umurcg/roboticFarm/modelsali/Models2/CableCarier/Track Joining Plate_MIR Stress Analysis Report 05_01_2017.html

Image Width (pixels):

# Stress Analysis Report



Analyzed File: | Track Joining Plate_MIR.ipt
Autodesk Inventor Version: | 2017 (Build 210142000, 142)
Creation Date: | 05/01/2017, 04:51
Study Author: | Ali
Summary:

###  Project Info (iProperties)

####  Summary

Author | umr

####  Project

Part Number | Track Joining Plate_MIR
Designer | Ali
Cost | £0.00
Date Created | 01/04/2014

####  Status

Design Status | WorkInProgress

####  Custom

Sending System | SolidWorks 2014
Last Author | Rory
Last Saved | 22/03/2016

####  Physical

Material | SolidWorks Materials|6061 Alloy|21
Density | 2.7 g/cm^3
Mass | 0.0997726 kg
Area | 17201.1 mm^2
Volume | 36952.8 mm^3
Center of Gravity | x=0 mm y=-32.6579 mm z=-2.5 mm

Note: Physical values could be different from Physical values used by FEA reported below.

##  Static Analysis:1

General objective and settings:

Design Objective | Single Point
Study Type | Static Analysis
Last Modification Date | 05/01/2017, 04:49
Detect and Eliminate Rigid Body Modes | No

Mesh settings:

Avg. Element Size (fraction of model diameter) | 0.1
Min. Element Size (fraction of avg. size) | 0.2
Grading Factor | 1.5
Max. Turn Angle | 60 deg
Create Curved Mesh Elements | Yes

###  Material(s)

Name | SolidWorks Materials|6061 Alloy|21
General | Mass Density | 2.7 g/cm^3
| Yield Strength | 55.1485 MPa
| Ultimate Tensile Strength | 124.084 MPa
Stress | Young's Modulus | 69 GPa
| Poisson's Ratio | 0.33 ul
| Shear Modulus | 25.9398 GPa
Part Name(s) | Track Joining Plate_MIR

###  Operating conditions

####  Force:1

Load Type | Force
Magnitude | 300.000 N
Vector X | 0.000 N
Vector Y | -300.000 N
Vector Z | 0.000 N

#####  Selected Face(s)

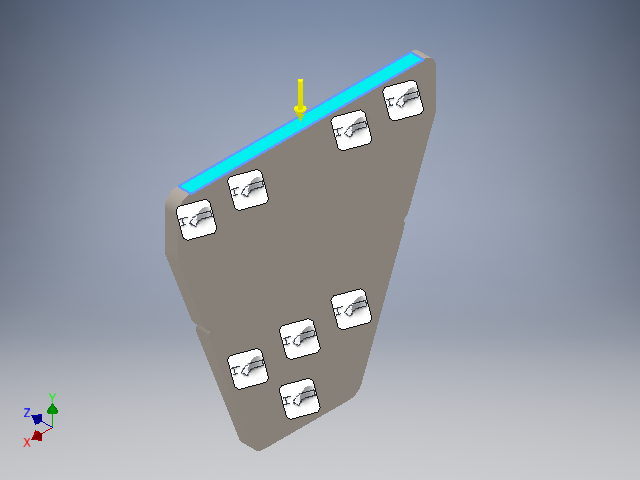
[picture p12: modelsali/Models2/CableCarier/Images/Track Joining Plate_MIR Stress Analysis Report 05_01_2017/0/Load_0_1.png]


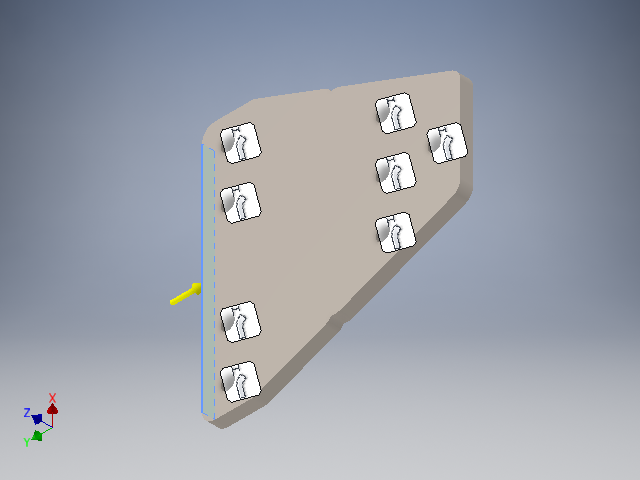
[picture p13: modelsali/Models2/CableCarier/Images/Track Joining Plate_MIR Stress Analysis Report 05_01_2017/0/Load_0_1_rev.png]


####  Fixed Constraint:1

Constraint Type | Fixed Constraint

#####  Selected Face(s)

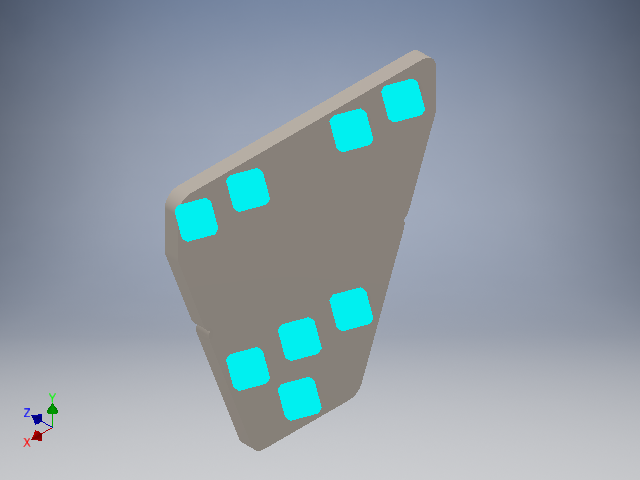
[picture p14: modelsali/Models2/CableCarier/Images/Track Joining Plate_MIR Stress Analysis Report 05_01_2017/0/Constraint_0_0.png]


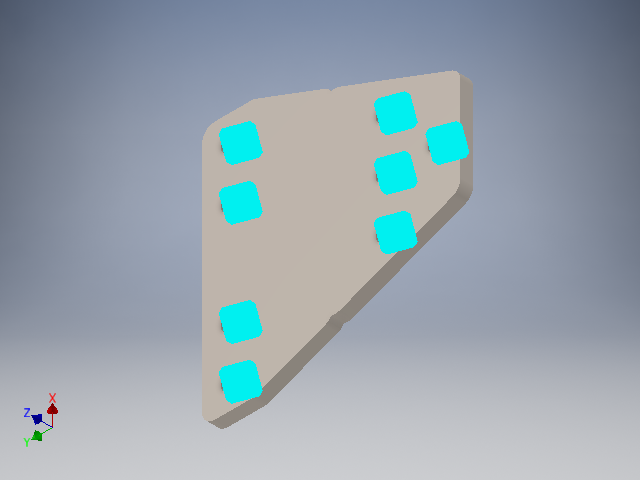
[picture p15: modelsali/Models2/CableCarier/Images/Track Joining Plate_MIR Stress Analysis Report 05_01_2017/0/Constraint_0_0_rev.png]


###  Results

####  Reaction Force and Moment on Constraints

Constraint Name | Reaction Force | | Reaction Moment
| Magnitude | Component (X,Y,Z) | Magnitude | Component (X,Y,Z)
Fixed Constraint:1 | 300 N | 0 N | 0.750183 N m | -0.750183 N m
| | 300 N | | 0 N m
| | 0 N | | 0 N m

####  Result Summary

Name | Minimum | Maximum
Volume | 36952.8 mm^3
Mass | 0.0997726 kg
Von Mises Stress | 0.00381254 MPa | 13.3405 MPa
1st Principal Stress | -1.33449 MPa | 9.61153 MPa
3rd Principal Stress | -10.5247 MPa | 0.820453 MPa
Displacement | 0 mm | 0.00102038 mm
Safety Factor | 4.1339 ul | 15 ul
Stress XX | -3.39842 MPa | 2.84843 MPa
Stress XY | -5.35685 MPa | 5.08963 MPa
Stress XZ | -3.9444 MPa | 3.36345 MPa
Stress YY | -8.54324 MPa | 8.24378 MPa
Stress YZ | -5.30222 MPa | 1.28965 MPa
Stress ZZ | -4.37922 MPa | 5.03622 MPa
X Displacement | -0.000126355 mm | 0.000126466 mm
Y Displacement | -0.00068512 mm | 0 mm
Z Displacement | -0.000884961 mm | 0.000793341 mm
Equivalent Strain | 0.0000000489979 ul | 0.000172419 ul
1st Principal Strain | 0.0000000444516 ul | 0.000158573 ul
3rd Principal Strain | -0.000165094 ul | -0.0000000357224 ul
Strain XX | -0.0000426302 ul | 0.0000384396 ul
Strain XY | -0.000103255 ul | 0.0000981045 ul
Strain XZ | -0.0000760298 ul | 0.0000648317 ul
Strain YY | -0.000126692 ul | 0.000118599 ul
Strain YZ | -0.000102202 ul | 0.0000248585 ul
Strain ZZ | -0.0000789899 ul | 0.000102537 ul

####  Figures

#####  Von Mises Stress

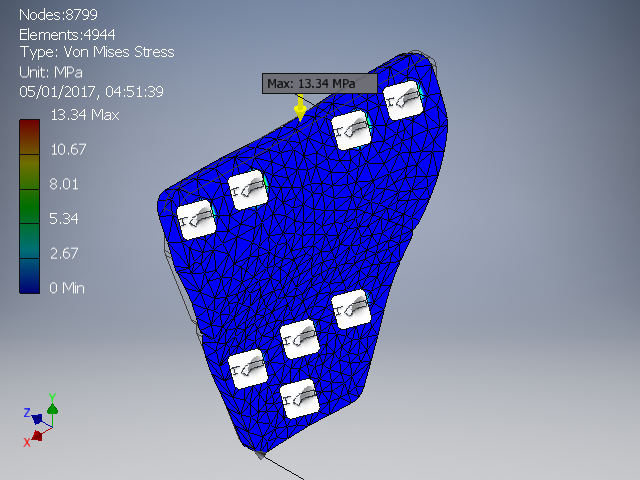
[picture p16: modelsali/Models2/CableCarier/Images/Track Joining Plate_MIR Stress Analysis Report 05_01_2017/0/Result_0_1.png]


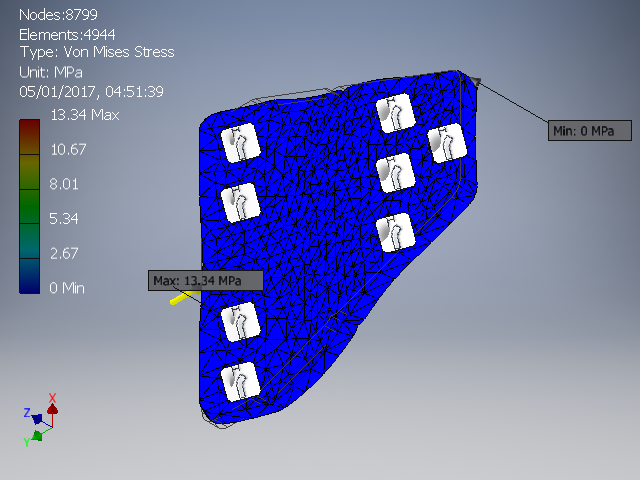
[picture p17: modelsali/Models2/CableCarier/Images/Track Joining Plate_MIR Stress Analysis Report 05_01_2017/0/Result_0_1_rev.png]


#####  1st Principal Stress

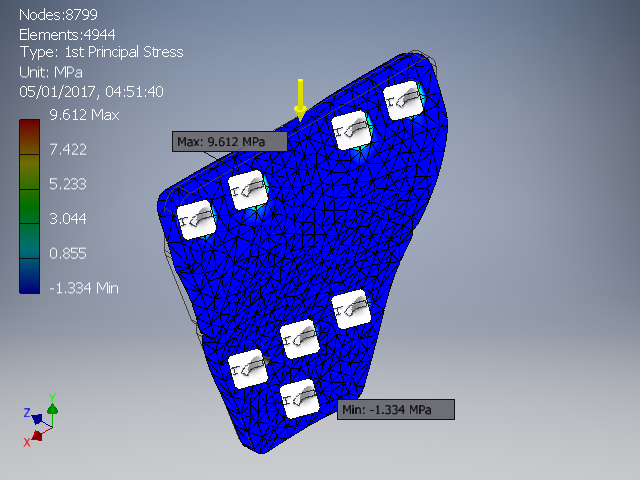
[picture p18: modelsali/Models2/CableCarier/Images/Track Joining Plate_MIR Stress Analysis Report 05_01_2017/0/Result_0_6.png]


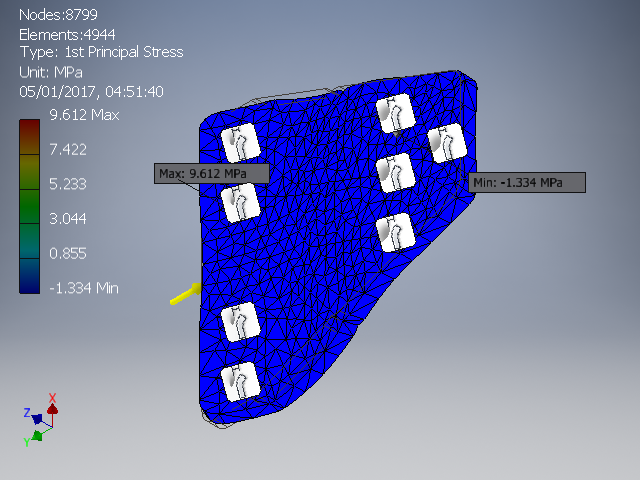
[picture p19: modelsali/Models2/CableCarier/Images/Track Joining Plate_MIR Stress Analysis Report 05_01_2017/0/Result_0_6_rev.png]


#####  3rd Principal Stress

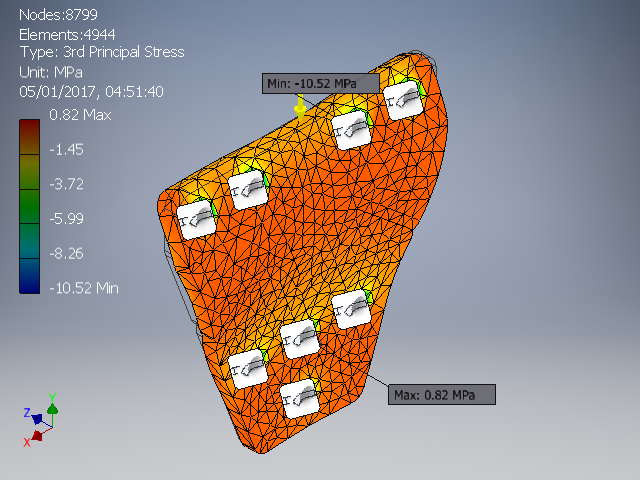
[picture p20: modelsali/Models2/CableCarier/Images/Track Joining Plate_MIR Stress Analysis Report 05_01_2017/0/Result_0_8.png]


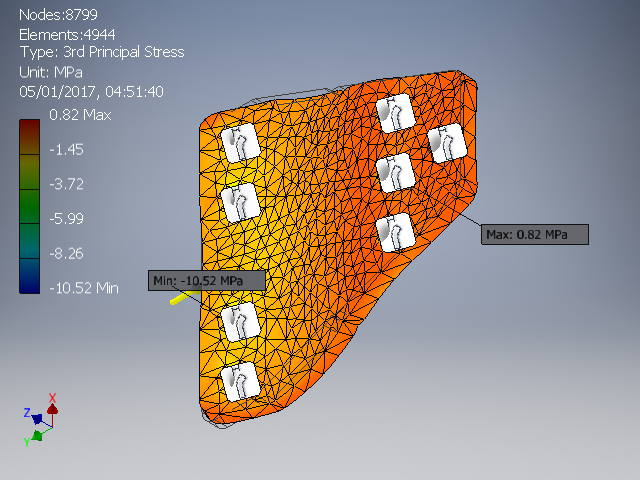
[picture p21: modelsali/Models2/CableCarier/Images/Track Joining Plate_MIR Stress Analysis Report 05_01_2017/0/Result_0_8_rev.png]


#####  Displacement

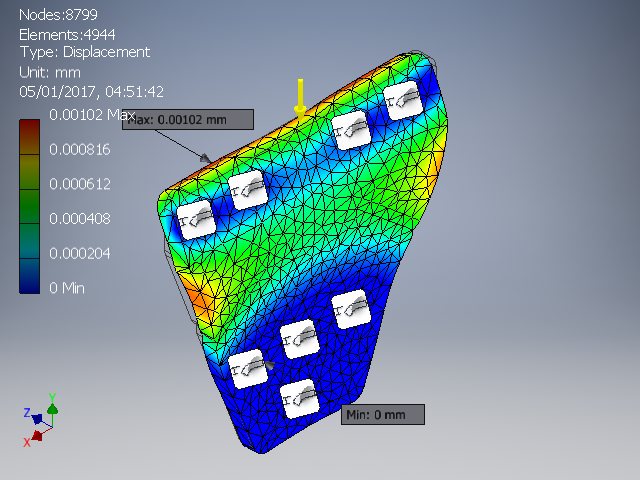
[picture p22: modelsali/Models2/CableCarier/Images/Track Joining Plate_MIR Stress Analysis Report 05_01_2017/0/Result_0_2.png]


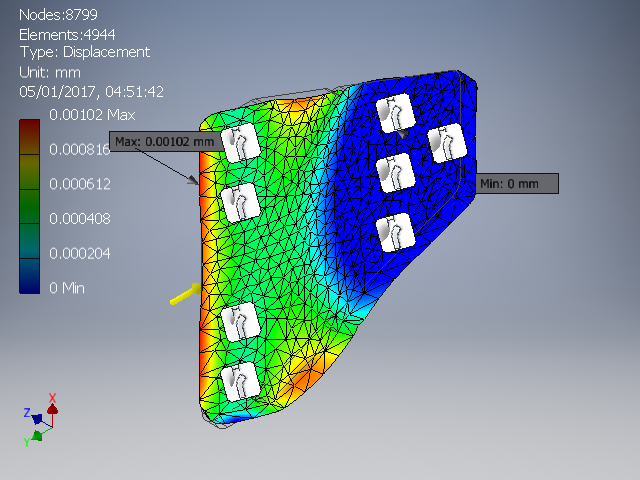
[picture p23: modelsali/Models2/CableCarier/Images/Track Joining Plate_MIR Stress Analysis Report 05_01_2017/0/Result_0_2_rev.png]


#####  Safety Factor

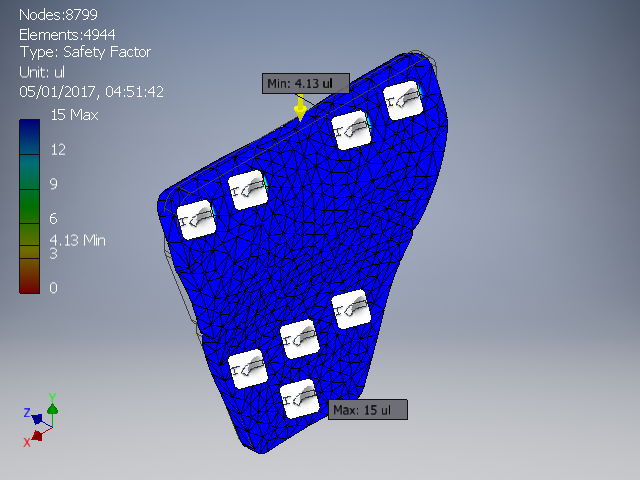
[picture p24: modelsali/Models2/CableCarier/Images/Track Joining Plate_MIR Stress Analysis Report 05_01_2017/0/Result_0_57.png]


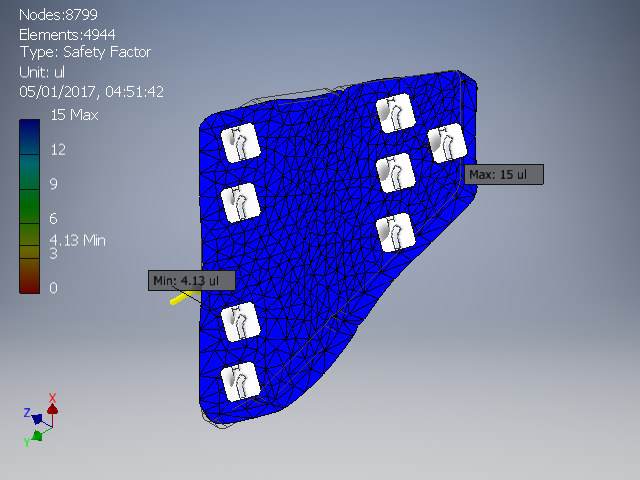
[picture p25: modelsali/Models2/CableCarier/Images/Track Joining Plate_MIR Stress Analysis Report 05_01_2017/0/Result_0_57_rev.png]


#####  Stress XX

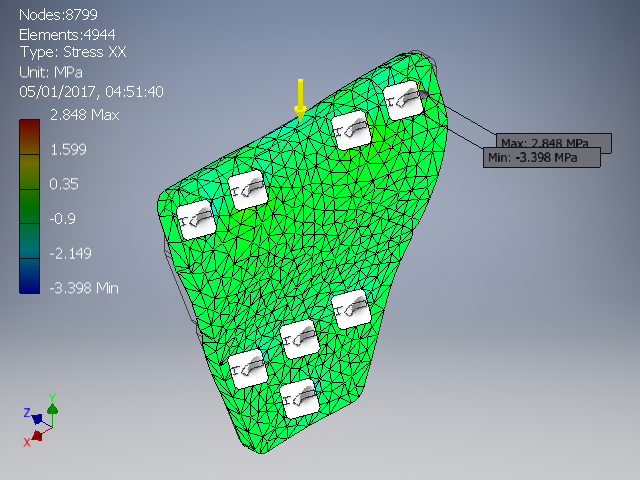
[picture p26: modelsali/Models2/CableCarier/Images/Track Joining Plate_MIR Stress Analysis Report 05_01_2017/0/Result_0_9.png]


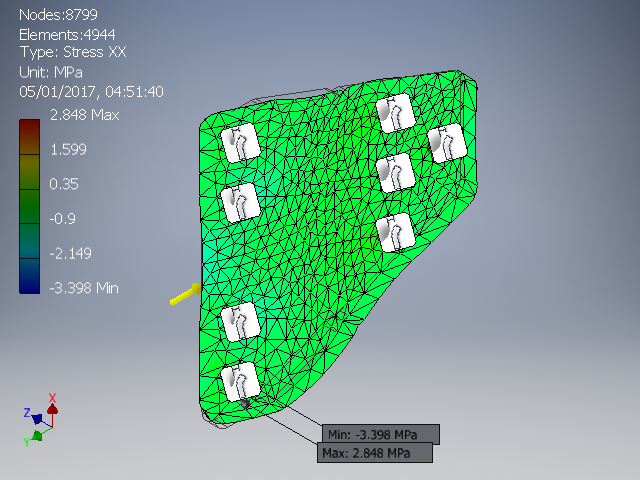
[picture p27: modelsali/Models2/CableCarier/Images/Track Joining Plate_MIR Stress Analysis Report 05_01_2017/0/Result_0_9_rev.png]


#####  Stress XY

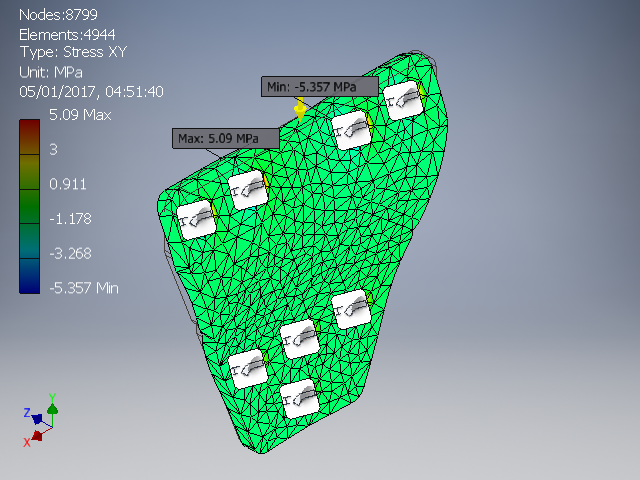
[picture p28: modelsali/Models2/CableCarier/Images/Track Joining Plate_MIR Stress Analysis Report 05_01_2017/0/Result_0_10.png]


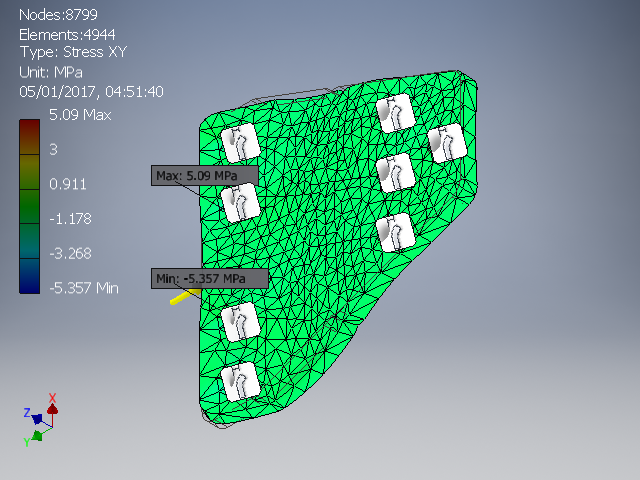
[picture p29: modelsali/Models2/CableCarier/Images/Track Joining Plate_MIR Stress Analysis Report 05_01_2017/0/Result_0_10_rev.png]


#####  Stress XZ

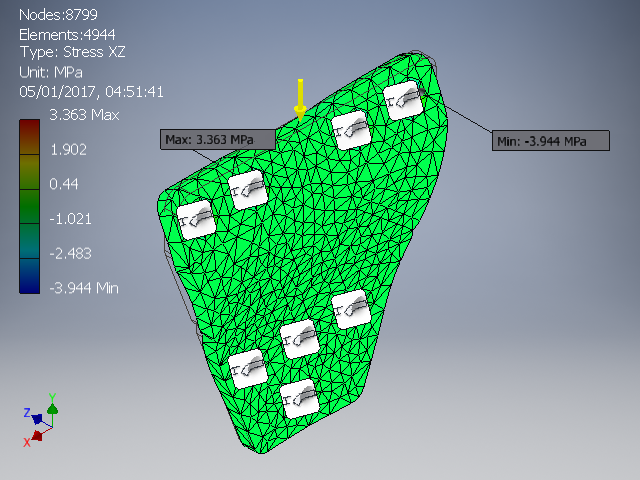
[picture p30: modelsali/Models2/CableCarier/Images/Track Joining Plate_MIR Stress Analysis Report 05_01_2017/0/Result_0_11.png]


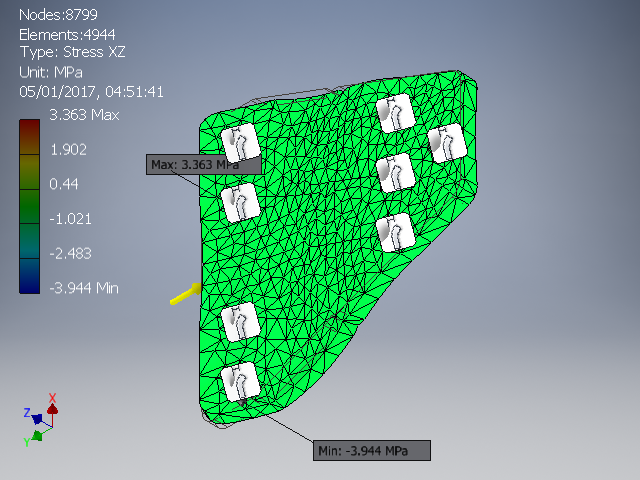
[picture p31: modelsali/Models2/CableCarier/Images/Track Joining Plate_MIR Stress Analysis Report 05_01_2017/0/Result_0_11_rev.png]


#####  Stress YY

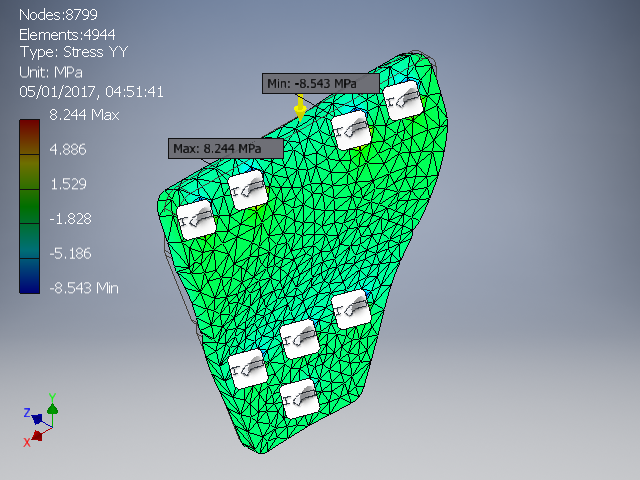
[picture p32: modelsali/Models2/CableCarier/Images/Track Joining Plate_MIR Stress Analysis Report 05_01_2017/0/Result_0_12.png]


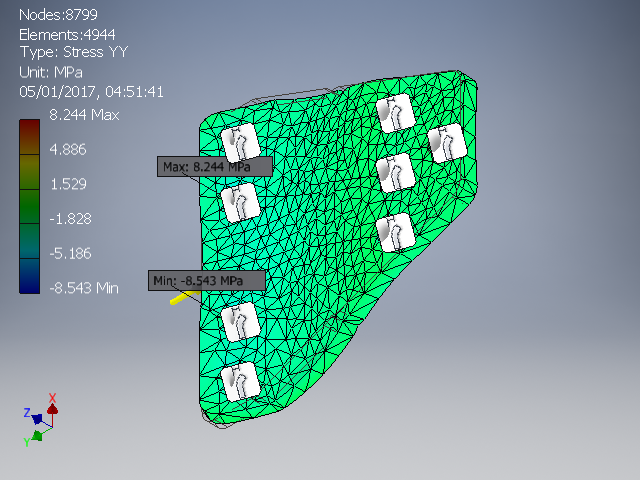
[picture p33: modelsali/Models2/CableCarier/Images/Track Joining Plate_MIR Stress Analysis Report 05_01_2017/0/Result_0_12_rev.png]


#####  Stress YZ

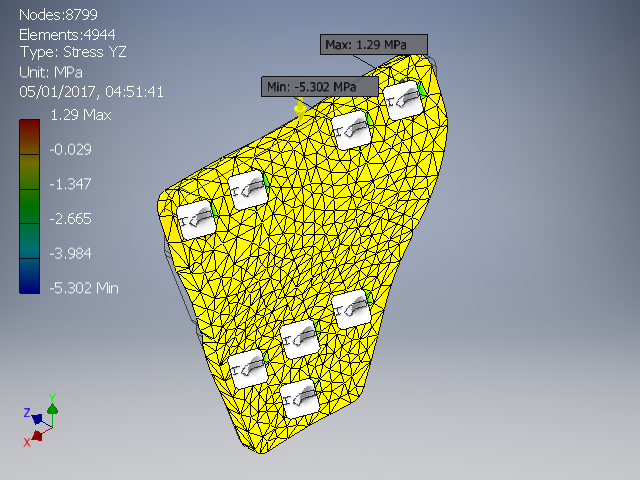
[picture p34: modelsali/Models2/CableCarier/Images/Track Joining Plate_MIR Stress Analysis Report 05_01_2017/0/Result_0_13.png]


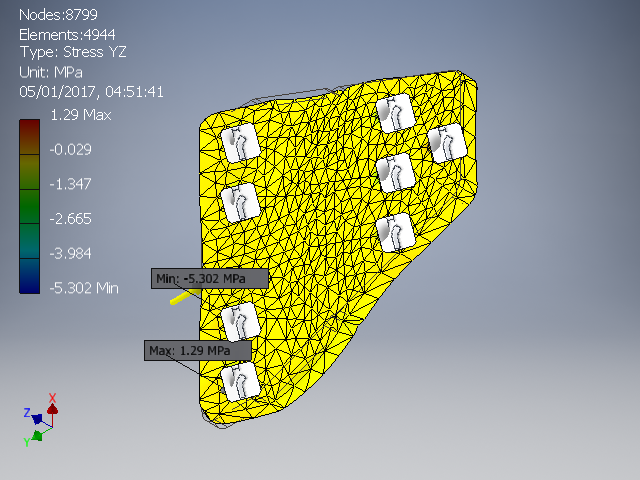
[picture p35: modelsali/Models2/CableCarier/Images/Track Joining Plate_MIR Stress Analysis Report 05_01_2017/0/Result_0_13_rev.png]


#####  Stress ZZ

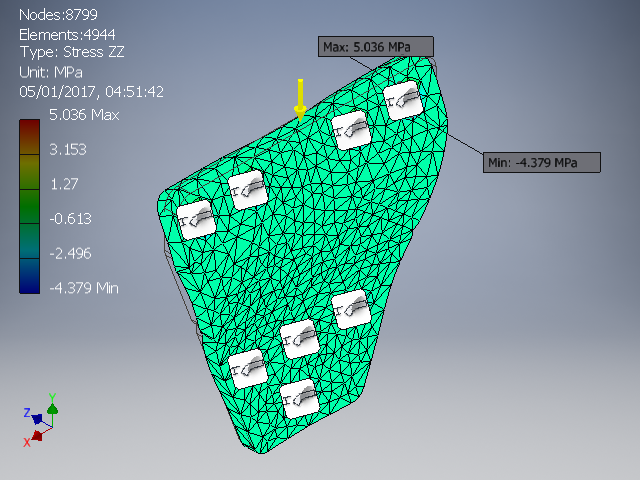
[picture p36: modelsali/Models2/CableCarier/Images/Track Joining Plate_MIR Stress Analysis Report 05_01_2017/0/Result_0_14.png]


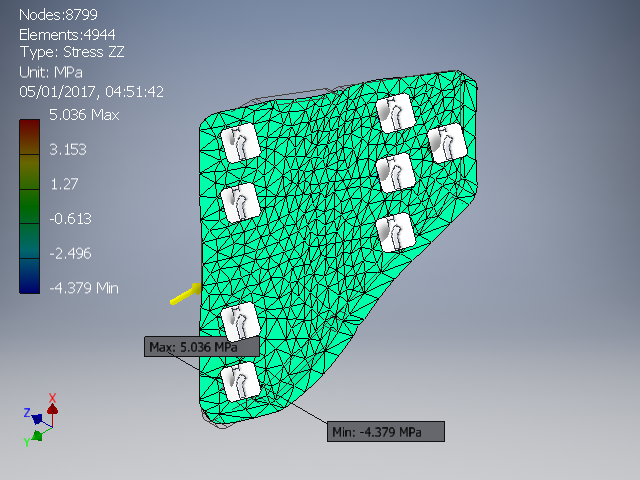
[picture p37: modelsali/Models2/CableCarier/Images/Track Joining Plate_MIR Stress Analysis Report 05_01_2017/0/Result_0_14_rev.png]


#####  X Displacement

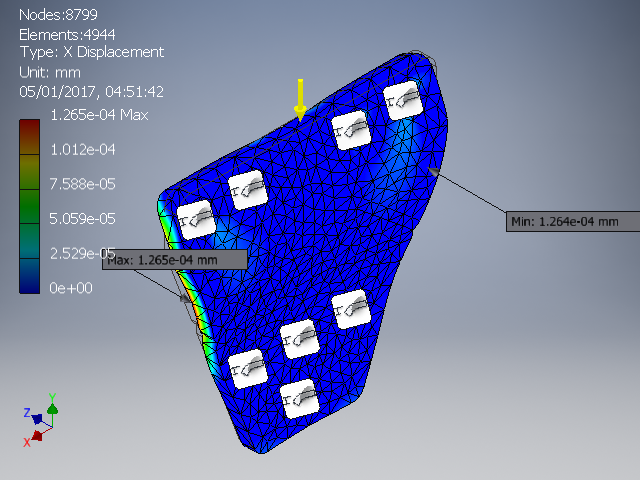
[picture p38: modelsali/Models2/CableCarier/Images/Track Joining Plate_MIR Stress Analysis Report 05_01_2017/0/Result_0_3.png]


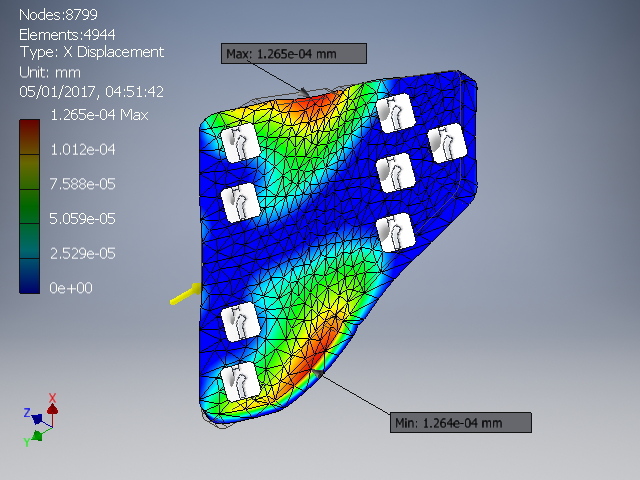
[picture p39: modelsali/Models2/CableCarier/Images/Track Joining Plate_MIR Stress Analysis Report 05_01_2017/0/Result_0_3_rev.png]


#####  Y Displacement

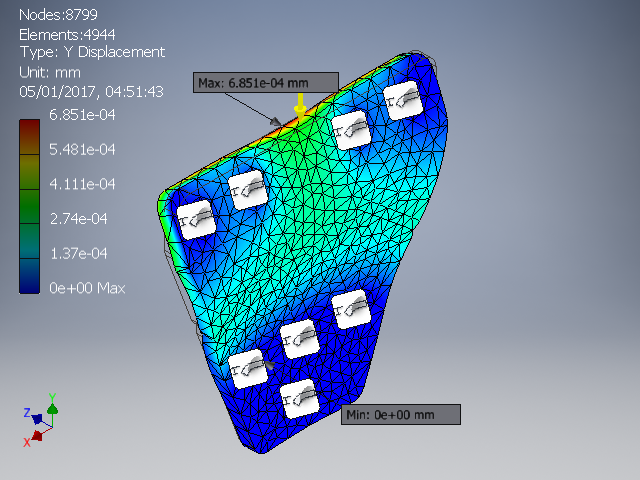
[picture p40: modelsali/Models2/CableCarier/Images/Track Joining Plate_MIR Stress Analysis Report 05_01_2017/0/Result_0_4.png]


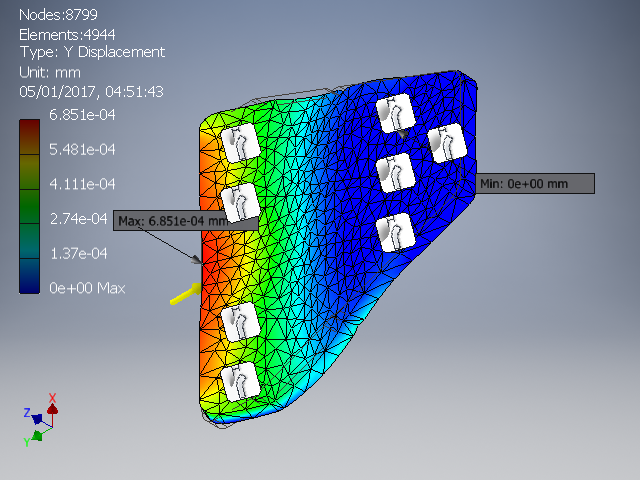
[picture p41: modelsali/Models2/CableCarier/Images/Track Joining Plate_MIR Stress Analysis Report 05_01_2017/0/Result_0_4_rev.png]


#####  Z Displacement

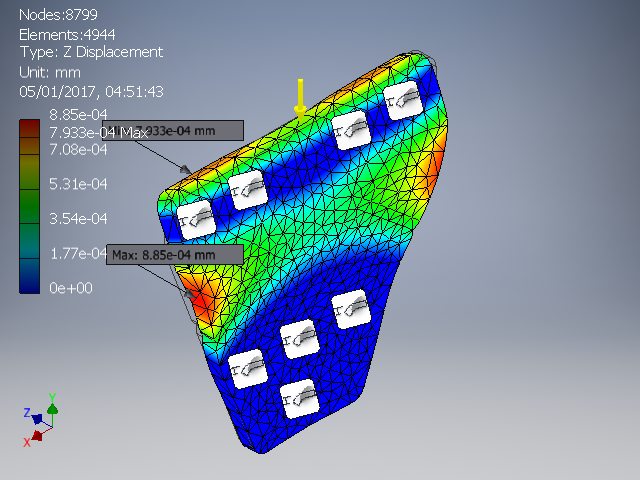
[picture p42: modelsali/Models2/CableCarier/Images/Track Joining Plate_MIR Stress Analysis Report 05_01_2017/0/Result_0_5.png]


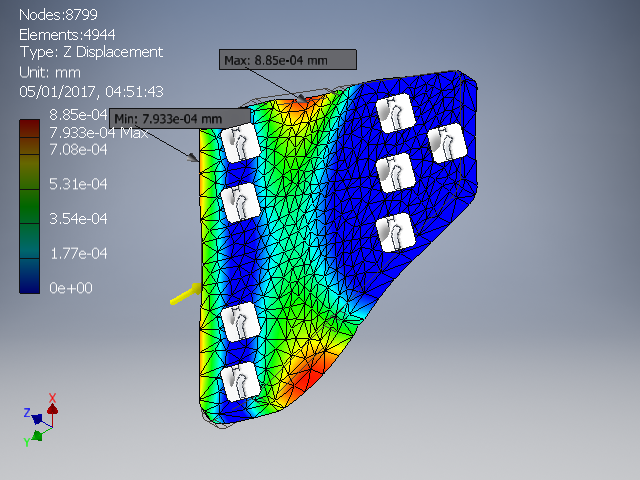
[picture p43: modelsali/Models2/CableCarier/Images/Track Joining Plate_MIR Stress Analysis Report 05_01_2017/0/Result_0_5_rev.png]


#####  Equivalent Strain

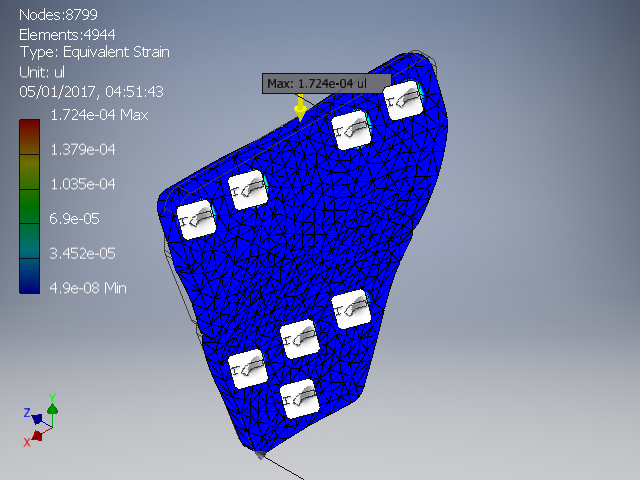
[picture p44: modelsali/Models2/CableCarier/Images/Track Joining Plate_MIR Stress Analysis Report 05_01_2017/0/Result_0_80.png]


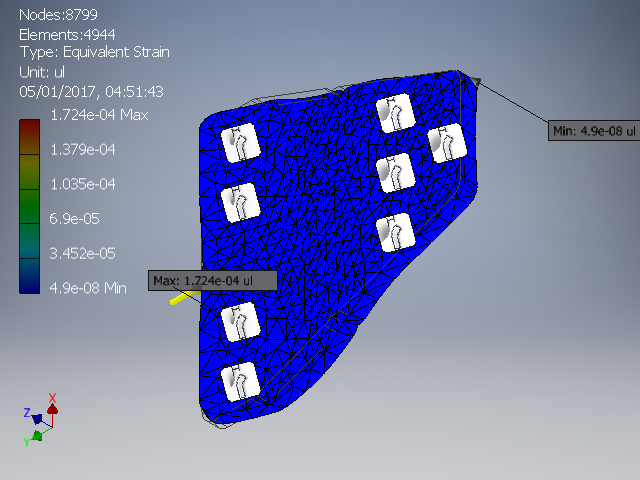
[picture p45: modelsali/Models2/CableCarier/Images/Track Joining Plate_MIR Stress Analysis Report 05_01_2017/0/Result_0_80_rev.png]


#####  1st Principal Strain

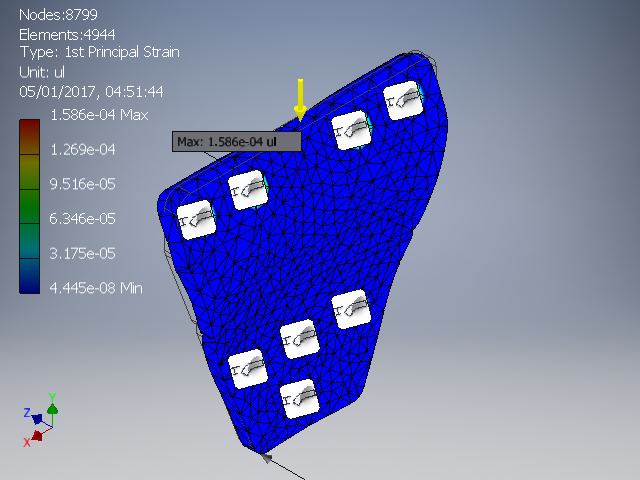
[picture p46: modelsali/Models2/CableCarier/Images/Track Joining Plate_MIR Stress Analysis Report 05_01_2017/0/Result_0_81.png]


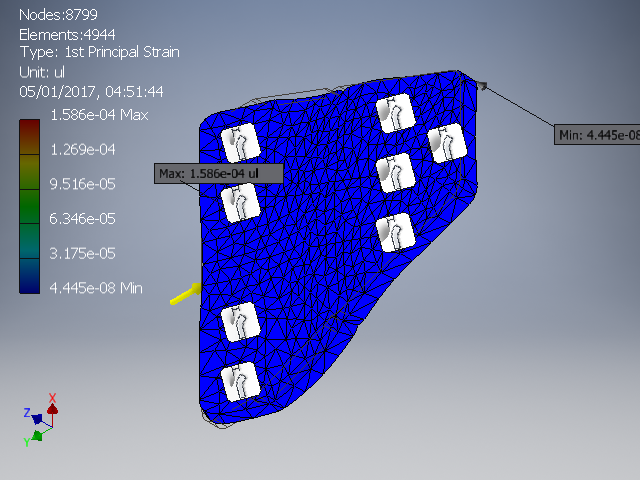
[picture p47: modelsali/Models2/CableCarier/Images/Track Joining Plate_MIR Stress Analysis Report 05_01_2017/0/Result_0_81_rev.png]


#####  3rd Principal Strain

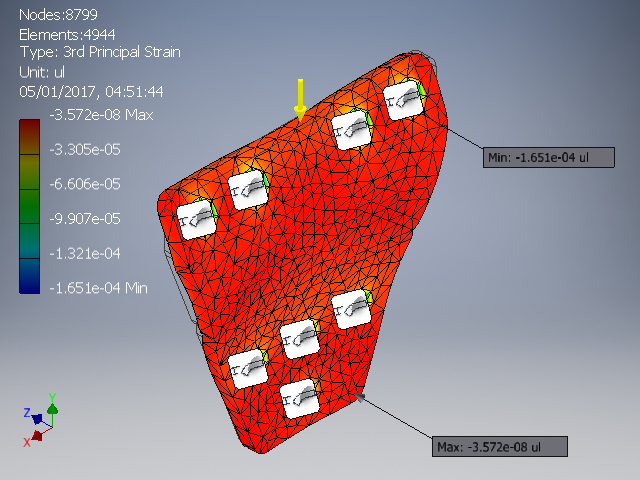
[picture p48: modelsali/Models2/CableCarier/Images/Track Joining Plate_MIR Stress Analysis Report 05_01_2017/0/Result_0_83.png]


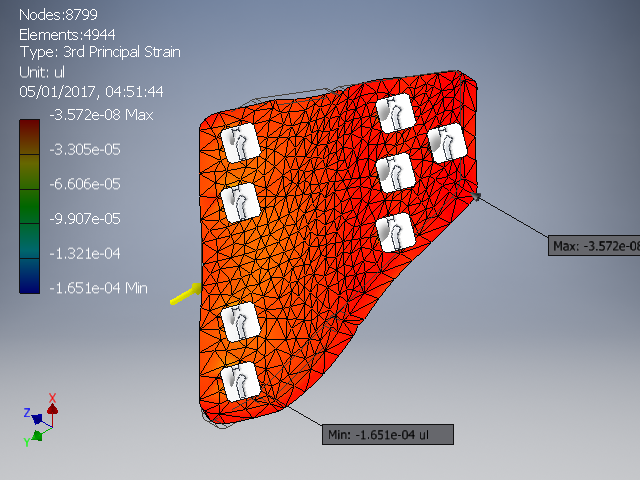
[picture p49: modelsali/Models2/CableCarier/Images/Track Joining Plate_MIR Stress Analysis Report 05_01_2017/0/Result_0_83_rev.png]


#####  Strain XX

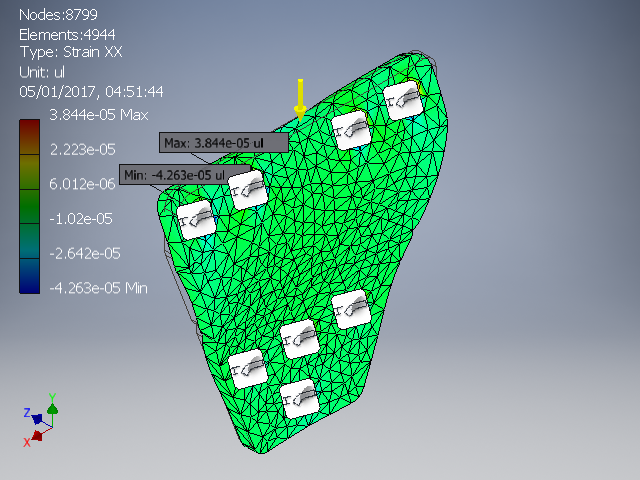
[picture p50: modelsali/Models2/CableCarier/Images/Track Joining Plate_MIR Stress Analysis Report 05_01_2017/0/Result_0_58.png]


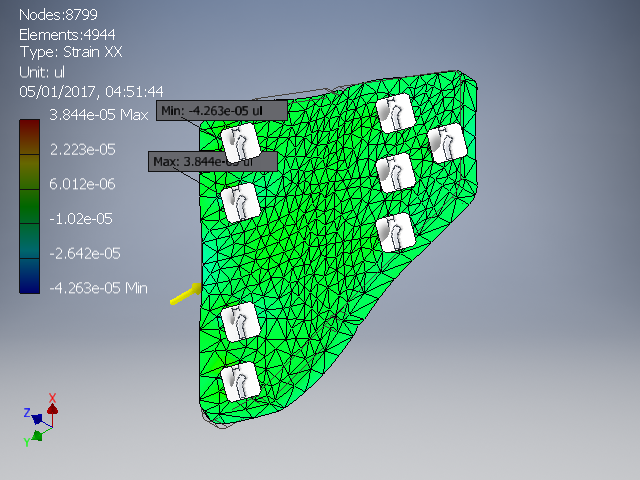
[picture p51: modelsali/Models2/CableCarier/Images/Track Joining Plate_MIR Stress Analysis Report 05_01_2017/0/Result_0_58_rev.png]


#####  Strain XY

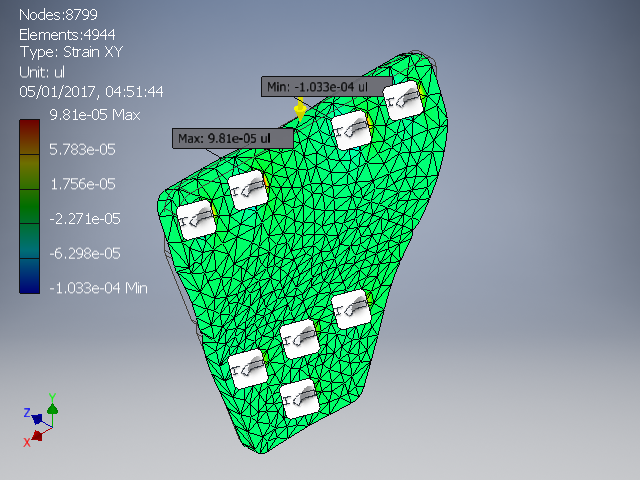
[picture p52: modelsali/Models2/CableCarier/Images/Track Joining Plate_MIR Stress Analysis Report 05_01_2017/0/Result_0_59.png]


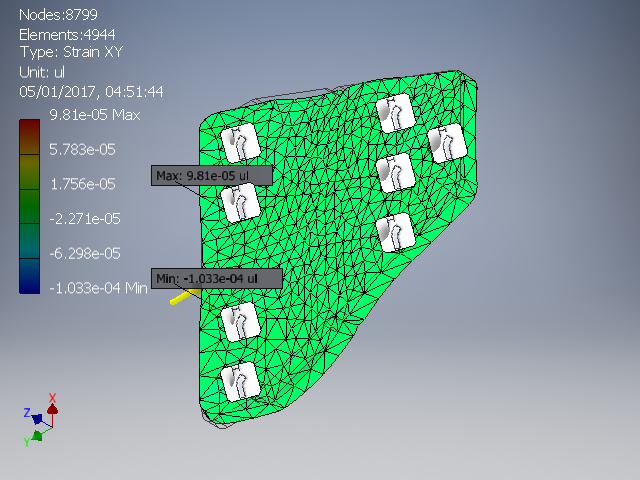
[picture p53: modelsali/Models2/CableCarier/Images/Track Joining Plate_MIR Stress Analysis Report 05_01_2017/0/Result_0_59_rev.png]


#####  Strain XZ

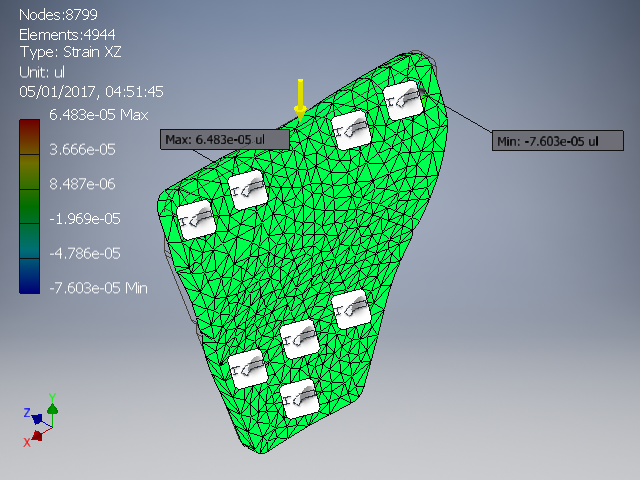
[picture p54: modelsali/Models2/CableCarier/Images/Track Joining Plate_MIR Stress Analysis Report 05_01_2017/0/Result_0_60.png]


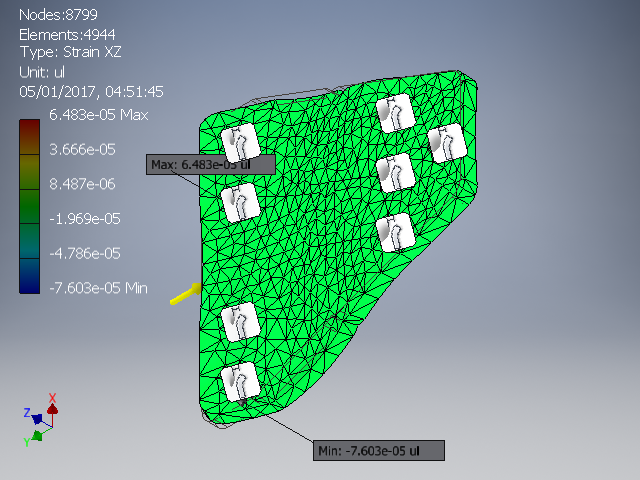
[picture p55: modelsali/Models2/CableCarier/Images/Track Joining Plate_MIR Stress Analysis Report 05_01_2017/0/Result_0_60_rev.png]


#####  Strain YY

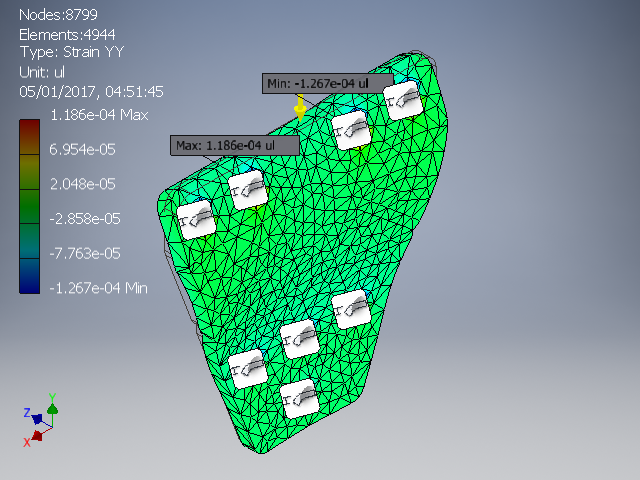
[picture p56: modelsali/Models2/CableCarier/Images/Track Joining Plate_MIR Stress Analysis Report 05_01_2017/0/Result_0_61.png]


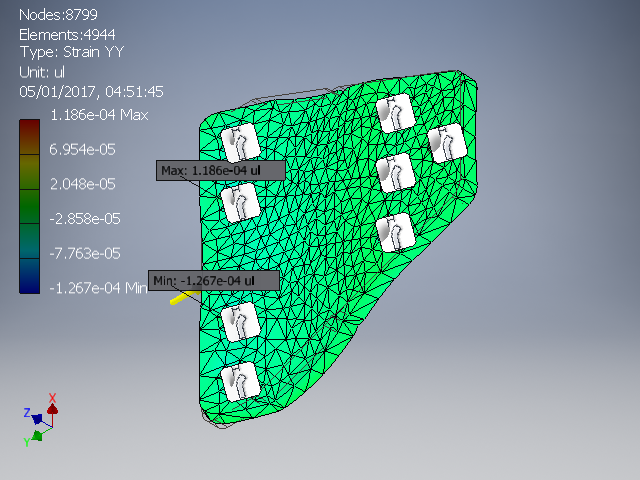
[picture p57: modelsali/Models2/CableCarier/Images/Track Joining Plate_MIR Stress Analysis Report 05_01_2017/0/Result_0_61_rev.png]


#####  Strain YZ

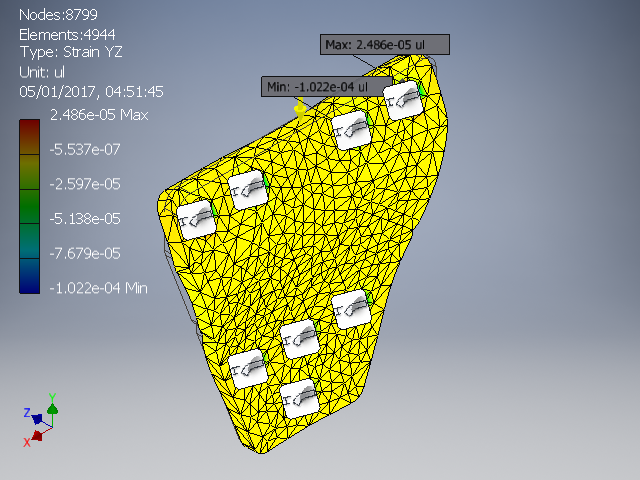
[picture p58: modelsali/Models2/CableCarier/Images/Track Joining Plate_MIR Stress Analysis Report 05_01_2017/0/Result_0_62.png]


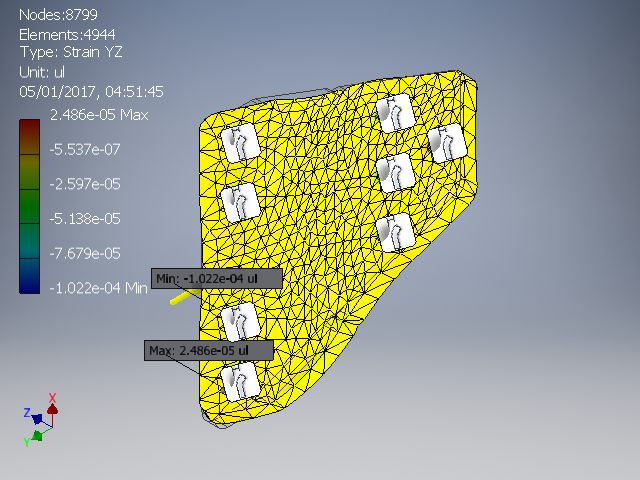
[picture p59: modelsali/Models2/CableCarier/Images/Track Joining Plate_MIR Stress Analysis Report 05_01_2017/0/Result_0_62_rev.png]


#####  Strain ZZ

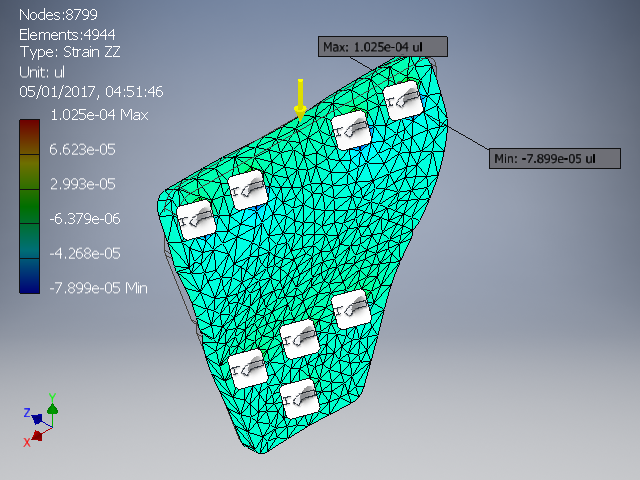
[picture p60: modelsali/Models2/CableCarier/Images/Track Joining Plate_MIR Stress Analysis Report 05_01_2017/0/Result_0_63.png]


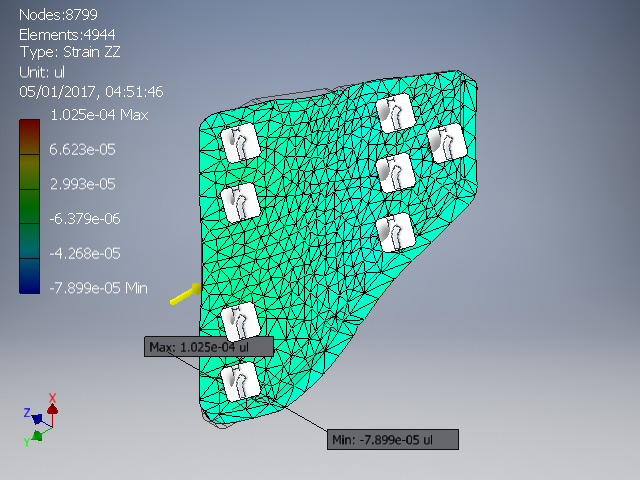
[picture p61: modelsali/Models2/CableCarier/Images/Track Joining Plate_MIR Stress Analysis Report 05_01_2017/0/Result_0_63_rev.png]


C:\Users\Ali\Desktop\roboticFarm-master\Models2\CableCarier\Track Joining Plate_MIR.ipt

Image Width (pixels):
