umurcg/roboticFarm/modelsali/Models2/Gantry/Driveshaft Stress Analysis Report 05_01_2017.html

Image Width (pixels):

# Stress Analysis Report



Analyzed File: | Driveshaft.ipt
Autodesk Inventor Version: | 2017 (Build 210142000, 142)
Creation Date: | 05/01/2017, 04:24
Study Author: | Ali
Summary:

###  Project Info (iProperties)

####  Summary

Author | umr

####  Project

Part Number | Driveshaft
Designer | umr
Cost | £0.00
Date Created | 12/12/2016

####  Status

Design Status | WorkInProgress

####  Physical

Material | Aluminum 6061
Density | 2.7 g/cm^3
Mass | 0.0689187 kg
Area | 20459.6 mm^2
Volume | 25525.4 mm^3
Center of Gravity | x=0.00000000026142 mm y=650 mm z=0 mm

Note: Physical values could be different from Physical values used by FEA reported below.

##  Static Analysis:1

General objective and settings:

Design Objective | Single Point
Study Type | Static Analysis
Last Modification Date | 05/01/2017, 04:22
Detect and Eliminate Rigid Body Modes | No

Mesh settings:

Avg. Element Size (fraction of model diameter) | 0.05
Min. Element Size (fraction of avg. size) | 0.1
Grading Factor | 1.5
Max. Turn Angle | 60 deg
Create Curved Mesh Elements | Yes

###  Material(s)

Name | Aluminum 6061
General | Mass Density | 2.7 g/cm^3
| Yield Strength | 275 MPa
| Ultimate Tensile Strength | 310 MPa
Stress | Young's Modulus | 68.9 GPa
| Poisson's Ratio | 0.33 ul
| Shear Modulus | 25.9023 GPa
Part Name(s) | Driveshaft

###  Operating conditions

####  Moment:1

Load Type | Moment
Magnitude | 100.000 N mm
Vector X | 0.000 N mm
Vector Y | -100.000 N mm
Vector Z | 0.000 N mm

#####  Selected Face(s)

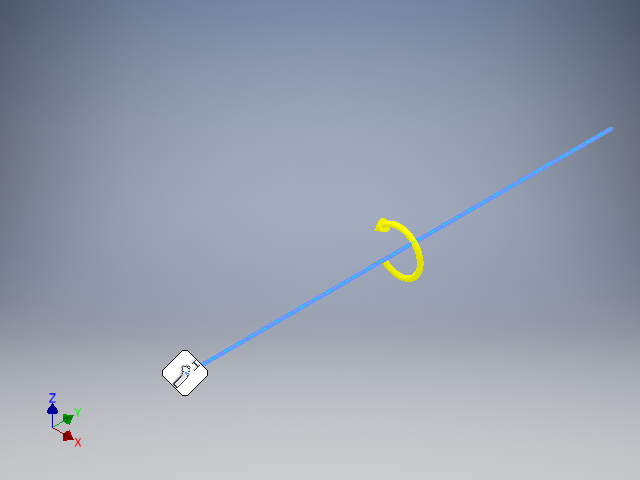
[picture p62: modelsali/Models2/Gantry/Images/Driveshaft Stress Analysis Report 05_01_2017/0/Load_0_0.png]


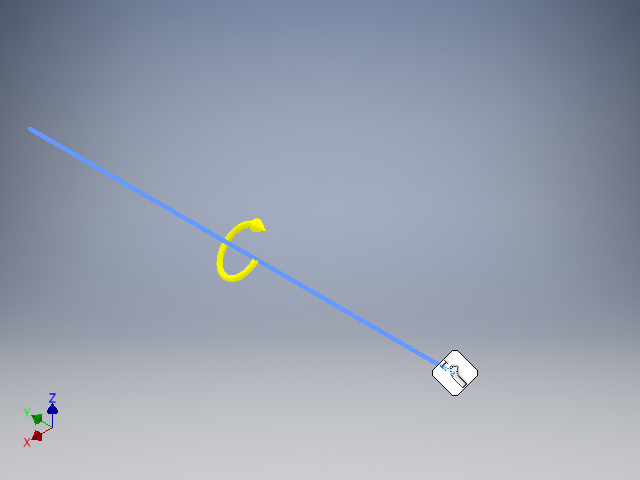
[picture p63: modelsali/Models2/Gantry/Images/Driveshaft Stress Analysis Report 05_01_2017/0/Load_0_0_rev.png]


####  Fixed Constraint:1

Constraint Type | Fixed Constraint

#####  Selected Face(s)

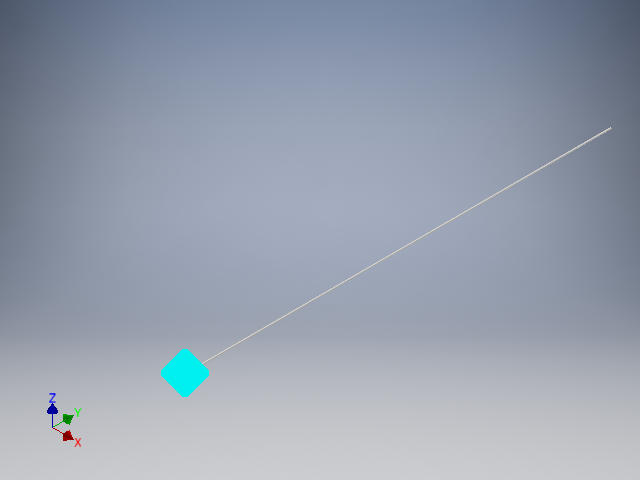
[picture p64: modelsali/Models2/Gantry/Images/Driveshaft Stress Analysis Report 05_01_2017/0/Constraint_0_2.png]


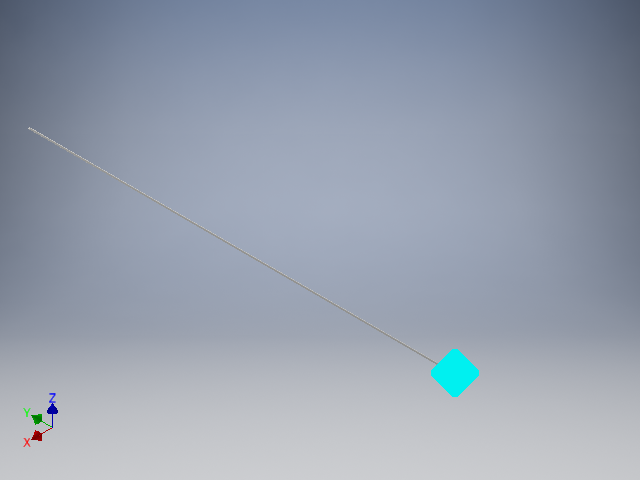
[picture p65: modelsali/Models2/Gantry/Images/Driveshaft Stress Analysis Report 05_01_2017/0/Constraint_0_2_rev.png]


###  Results

####  Reaction Force and Moment on Constraints

Constraint Name | Reaction Force | | Reaction Moment
| Magnitude | Component (X,Y,Z) | Magnitude | Component (X,Y,Z)
Fixed Constraint:1 | 0 N | 0 N | 0.0998838 N m | -0.00295947 N m
| | 0 N | | 0.0998395 N m
| | 0 N | | 0.000288372 N m

####  Result Summary

Name | Minimum | Maximum
Volume | 25525.4 mm^3
Mass | 0.0689187 kg
Von Mises Stress | 0.00118769 MPa | 11.9474 MPa
1st Principal Stress | -0.00111354 MPa | 7.09513 MPa
3rd Principal Stress | -7.41829 MPa | 0.144277 MPa
Displacement | 0 mm | 0.758937 mm
Safety Factor | 15 ul | 15 ul
Stress XX | -5.44887 MPa | 4.71323 MPa
Stress XY | -5.83788 MPa | 5.30874 MPa
Stress XZ | -5.2708 MPa | 4.14465 MPa
Stress YY | -0.696162 MPa | 0.526933 MPa
Stress YZ | -5.00687 MPa | 5.21906 MPa
Stress ZZ | -4.76428 MPa | 5.61412 MPa
X Displacement | -0.0471642 mm | 0.215522 mm
Y Displacement | -0.00173211 mm | 0.00173486 mm
Z Displacement | -0.00834352 mm | 0.750322 mm
Equivalent Strain | 0.00000001575 ul | 0.000153756 ul
1st Principal Strain | 0.0000000104867 ul | 0.000134059 ul
3rd Principal Strain | -0.000134647 ul | -0.000000013685 ul
Strain XX | -0.000106698 ul | 0.000091753 ul
Strain XY | -0.00011269 ul | 0.000102476 ul
Strain XZ | -0.000101744 ul | 0.0000800056 ul
Strain YY | -0.00000738737 ul | 0.00000635923 ul
Strain YZ | -0.0000966494 ul | 0.000100745 ul
Strain ZZ | -0.0000911946 ul | 0.00010547 ul

####  Figures

#####  Von Mises Stress

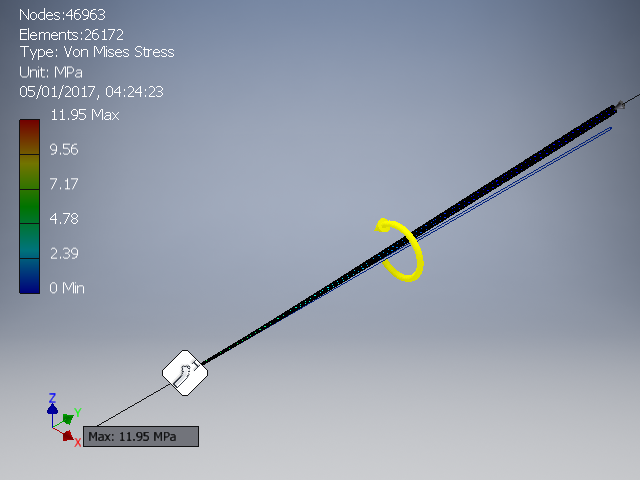
[picture p66: modelsali/Models2/Gantry/Images/Driveshaft Stress Analysis Report 05_01_2017/0/Result_0_1.png]


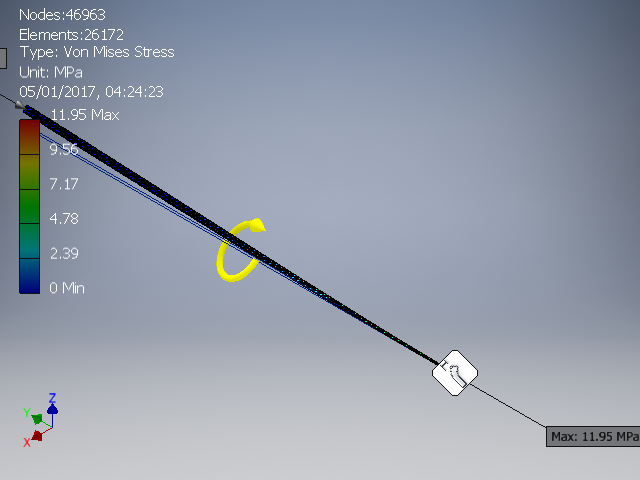
[picture p67: modelsali/Models2/Gantry/Images/Driveshaft Stress Analysis Report 05_01_2017/0/Result_0_1_rev.png]


#####  1st Principal Stress

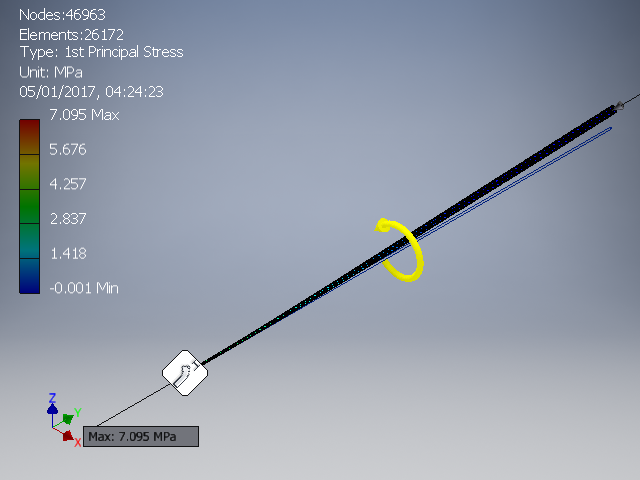
[picture p68: modelsali/Models2/Gantry/Images/Driveshaft Stress Analysis Report 05_01_2017/0/Result_0_6.png]


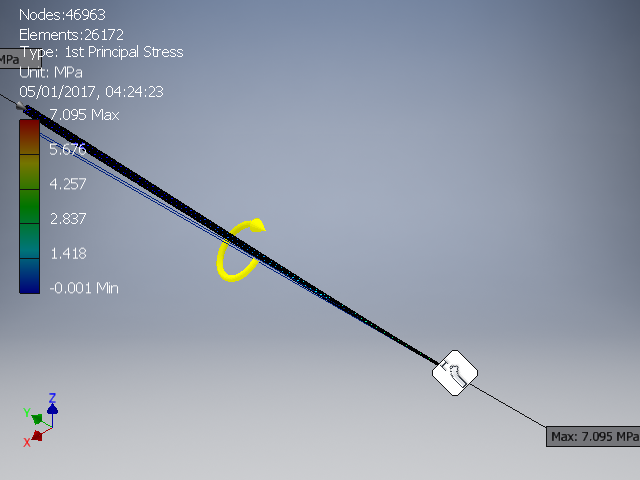
[picture p69: modelsali/Models2/Gantry/Images/Driveshaft Stress Analysis Report 05_01_2017/0/Result_0_6_rev.png]


#####  3rd Principal Stress

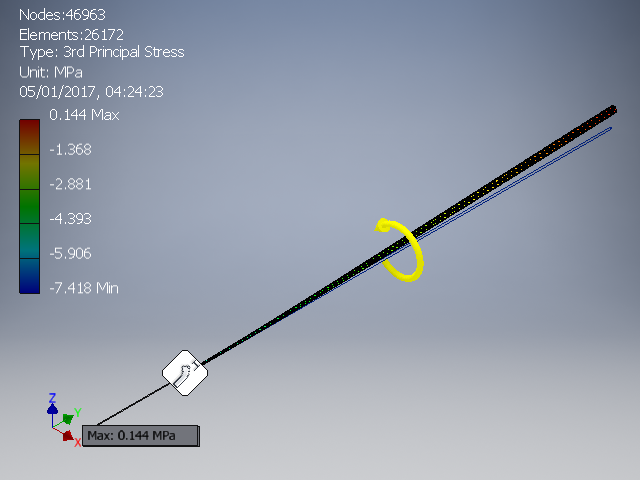
[picture p70: modelsali/Models2/Gantry/Images/Driveshaft Stress Analysis Report 05_01_2017/0/Result_0_8.png]


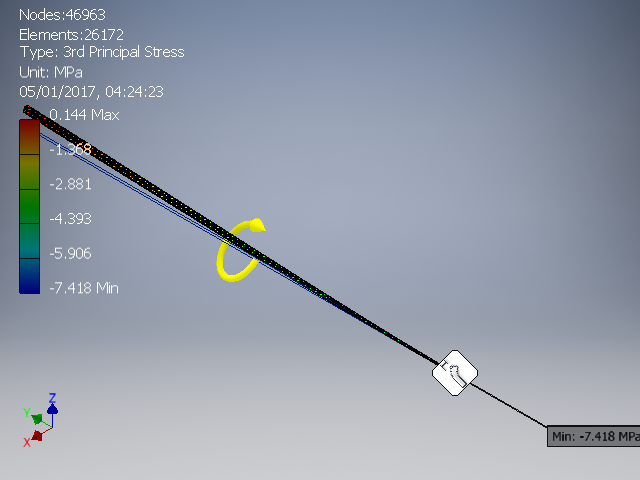
[picture p71: modelsali/Models2/Gantry/Images/Driveshaft Stress Analysis Report 05_01_2017/0/Result_0_8_rev.png]


#####  Displacement

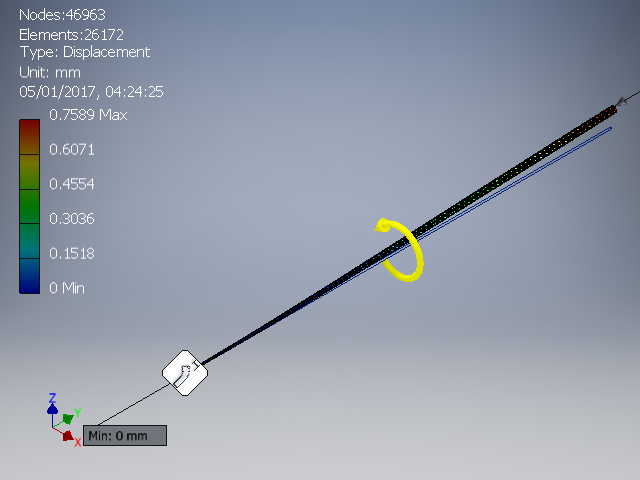
[picture p72: modelsali/Models2/Gantry/Images/Driveshaft Stress Analysis Report 05_01_2017/0/Result_0_2.png]


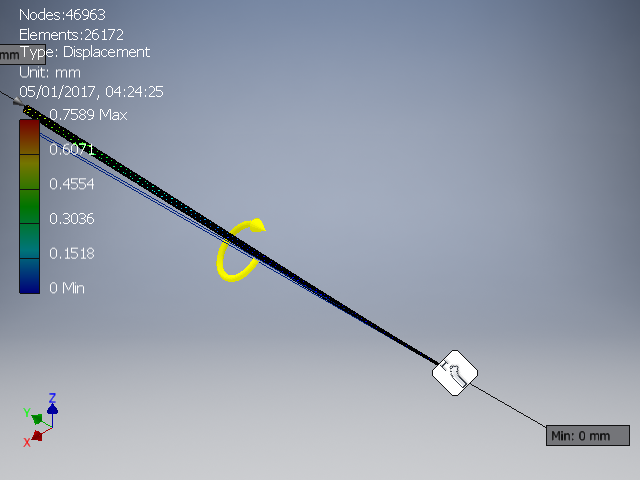
[picture p73: modelsali/Models2/Gantry/Images/Driveshaft Stress Analysis Report 05_01_2017/0/Result_0_2_rev.png]


#####  Safety Factor

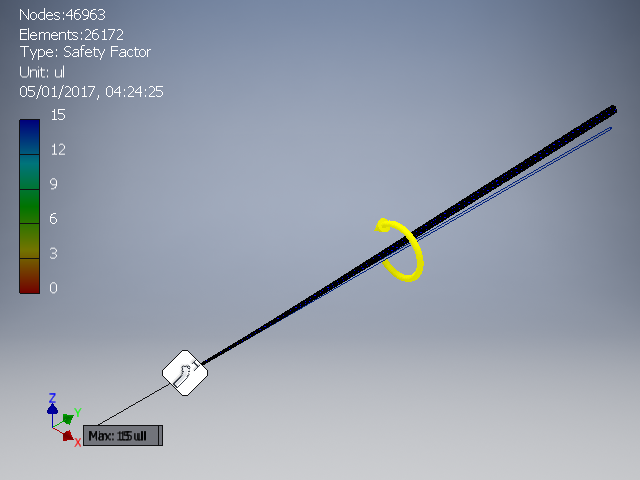
[picture p74: modelsali/Models2/Gantry/Images/Driveshaft Stress Analysis Report 05_01_2017/0/Result_0_57.png]


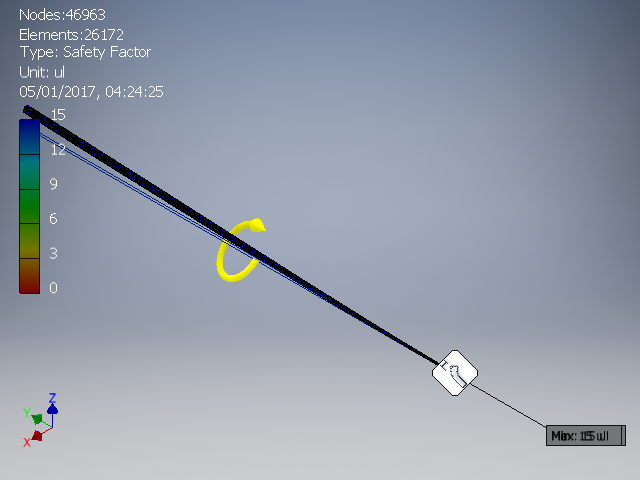
[picture p75: modelsali/Models2/Gantry/Images/Driveshaft Stress Analysis Report 05_01_2017/0/Result_0_57_rev.png]


#####  Stress XX

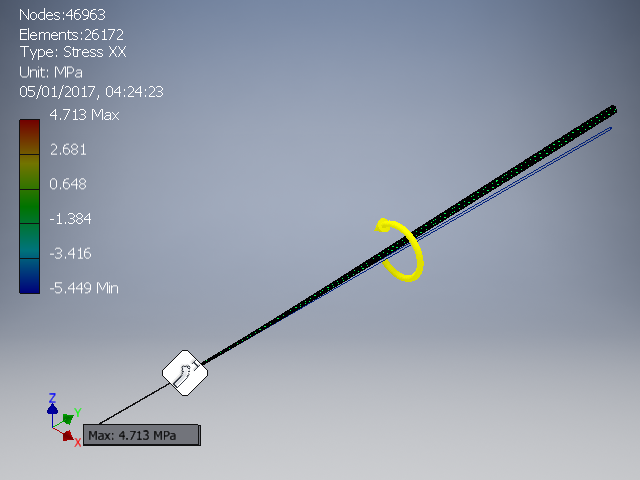
[picture p76: modelsali/Models2/Gantry/Images/Driveshaft Stress Analysis Report 05_01_2017/0/Result_0_9.png]


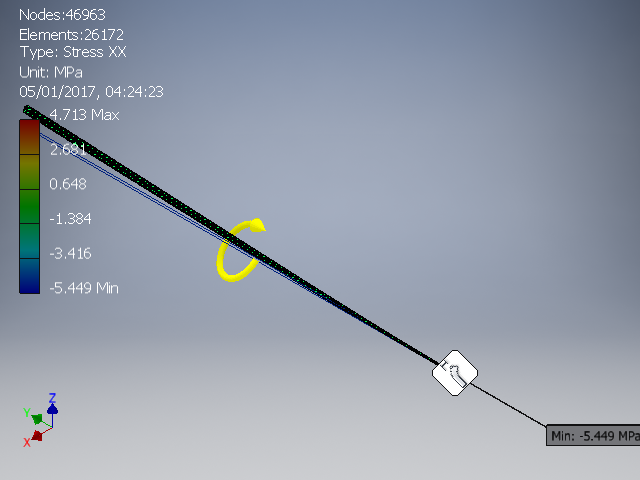
[picture p77: modelsali/Models2/Gantry/Images/Driveshaft Stress Analysis Report 05_01_2017/0/Result_0_9_rev.png]


#####  Stress XY

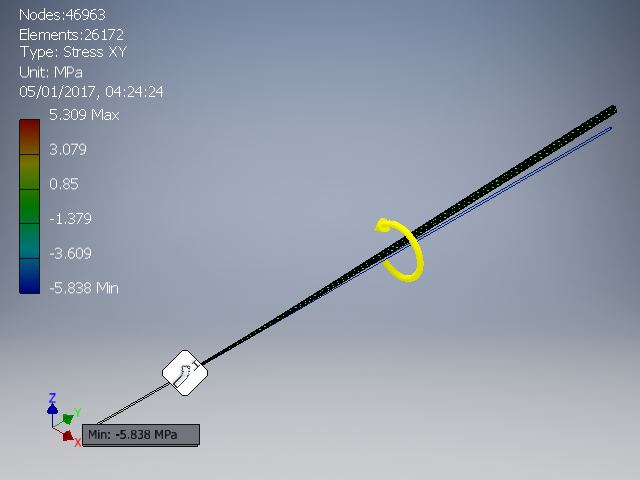
[picture p78: modelsali/Models2/Gantry/Images/Driveshaft Stress Analysis Report 05_01_2017/0/Result_0_10.png]


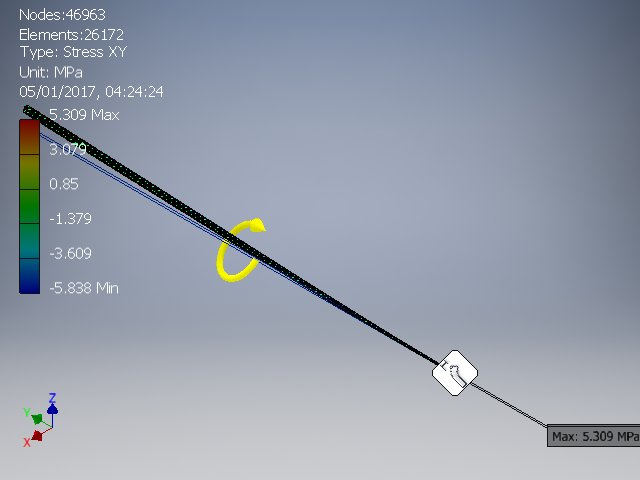
[picture p79: modelsali/Models2/Gantry/Images/Driveshaft Stress Analysis Report 05_01_2017/0/Result_0_10_rev.png]


#####  Stress XZ

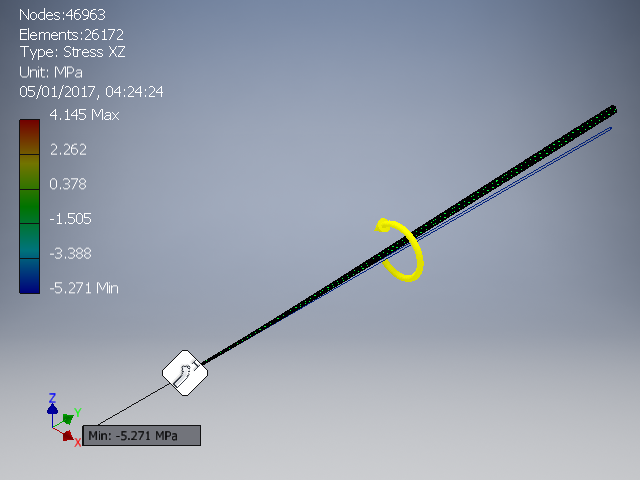
[picture p80: modelsali/Models2/Gantry/Images/Driveshaft Stress Analysis Report 05_01_2017/0/Result_0_11.png]


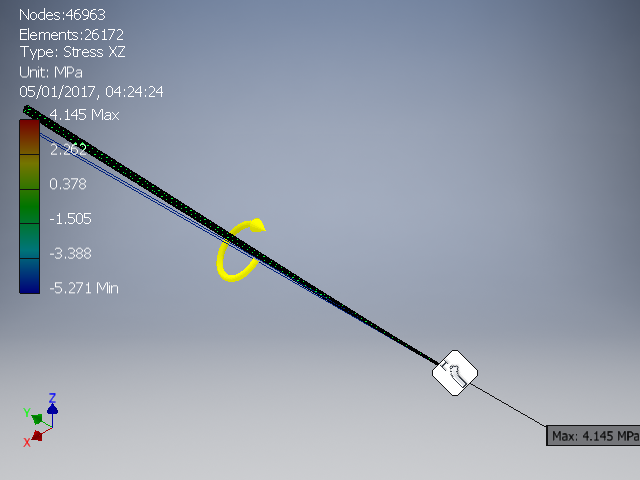
[picture p81: modelsali/Models2/Gantry/Images/Driveshaft Stress Analysis Report 05_01_2017/0/Result_0_11_rev.png]


#####  Stress YY

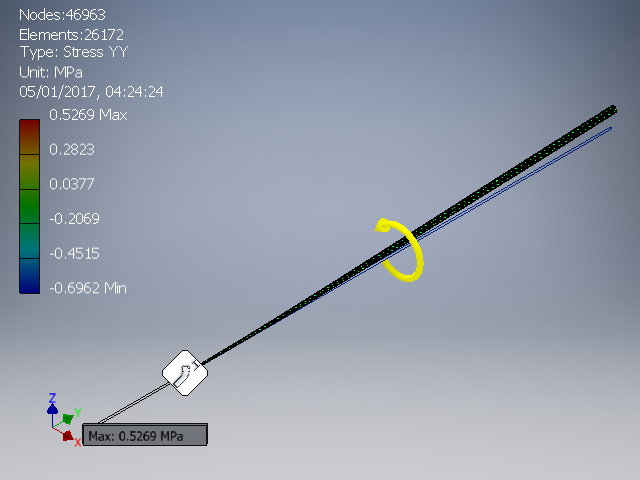
[picture p82: modelsali/Models2/Gantry/Images/Driveshaft Stress Analysis Report 05_01_2017/0/Result_0_12.png]


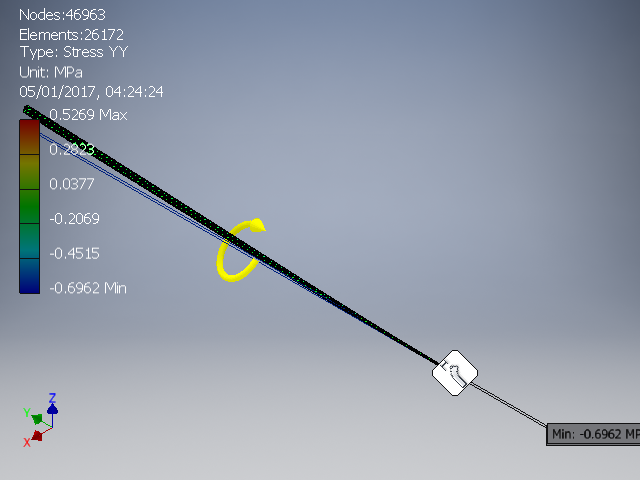
[picture p83: modelsali/Models2/Gantry/Images/Driveshaft Stress Analysis Report 05_01_2017/0/Result_0_12_rev.png]


#####  Stress YZ

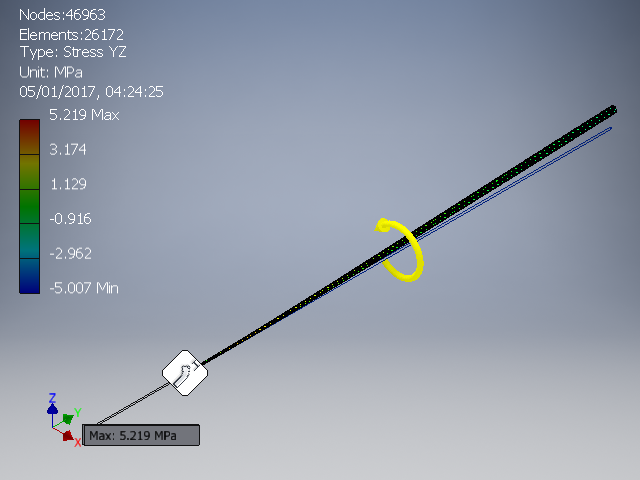
[picture p84: modelsali/Models2/Gantry/Images/Driveshaft Stress Analysis Report 05_01_2017/0/Result_0_13.png]


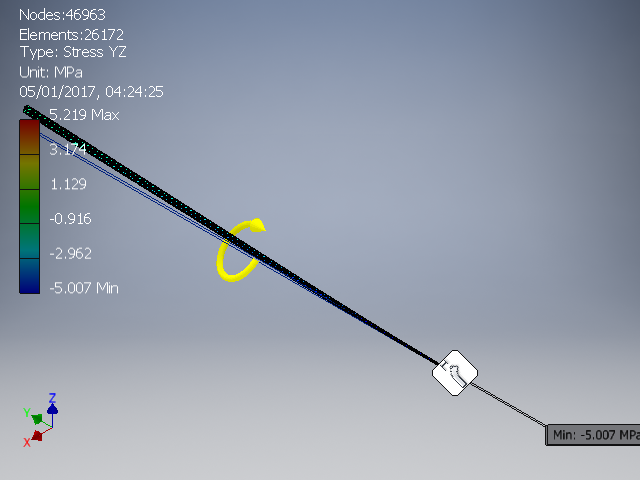
[picture p85: modelsali/Models2/Gantry/Images/Driveshaft Stress Analysis Report 05_01_2017/0/Result_0_13_rev.png]


#####  Stress ZZ

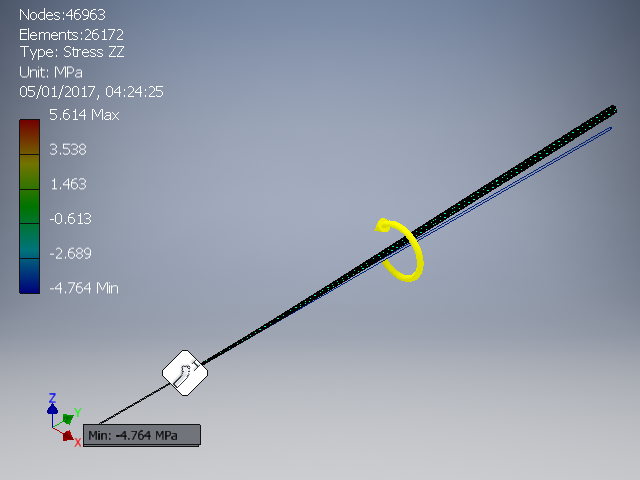
[picture p86: modelsali/Models2/Gantry/Images/Driveshaft Stress Analysis Report 05_01_2017/0/Result_0_14.png]


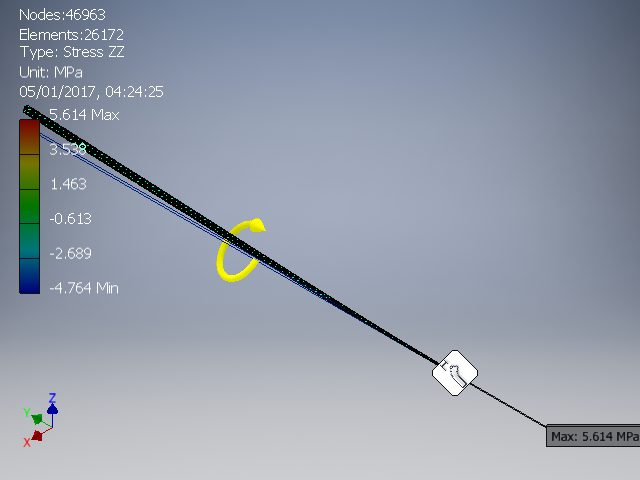
[picture p87: modelsali/Models2/Gantry/Images/Driveshaft Stress Analysis Report 05_01_2017/0/Result_0_14_rev.png]


#####  X Displacement

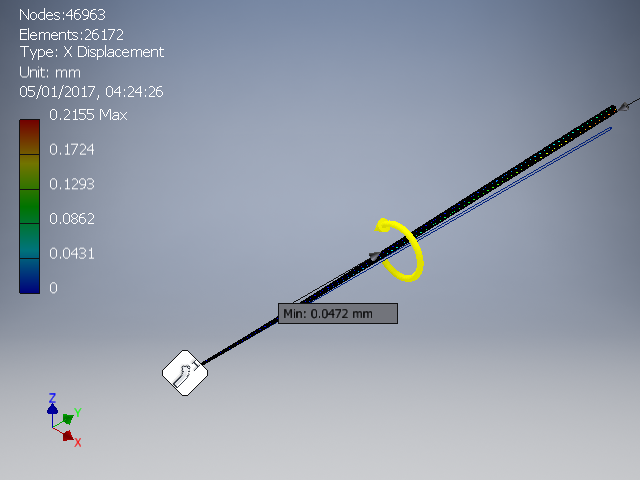
[picture p88: modelsali/Models2/Gantry/Images/Driveshaft Stress Analysis Report 05_01_2017/0/Result_0_3.png]


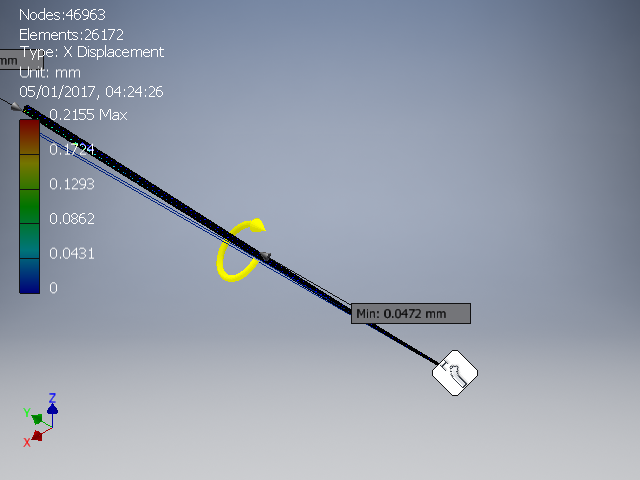
[picture p89: modelsali/Models2/Gantry/Images/Driveshaft Stress Analysis Report 05_01_2017/0/Result_0_3_rev.png]


#####  Y Displacement

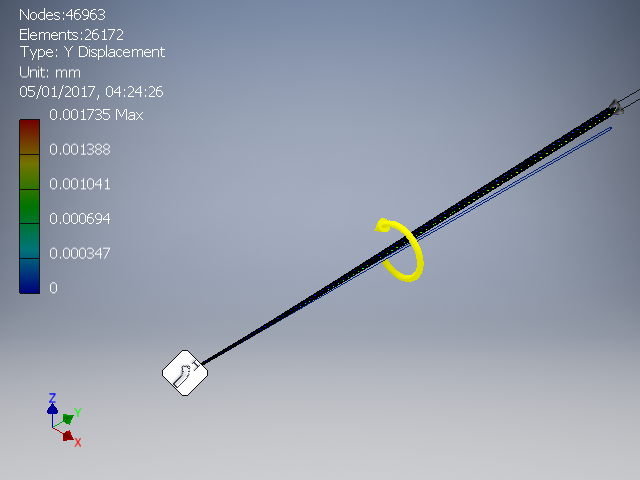
[picture p90: modelsali/Models2/Gantry/Images/Driveshaft Stress Analysis Report 05_01_2017/0/Result_0_4.png]


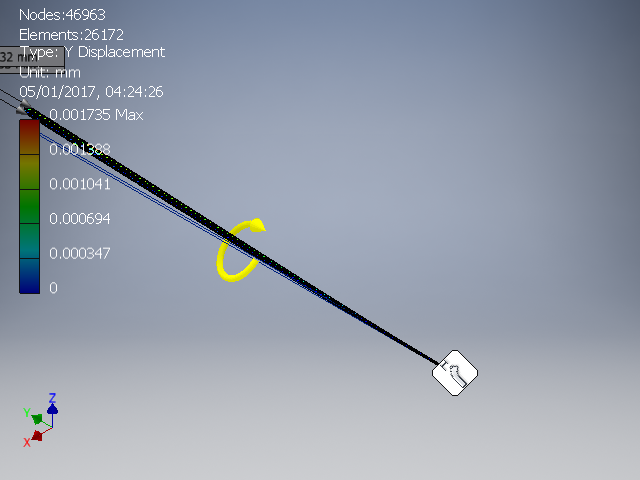
[picture p91: modelsali/Models2/Gantry/Images/Driveshaft Stress Analysis Report 05_01_2017/0/Result_0_4_rev.png]


#####  Z Displacement

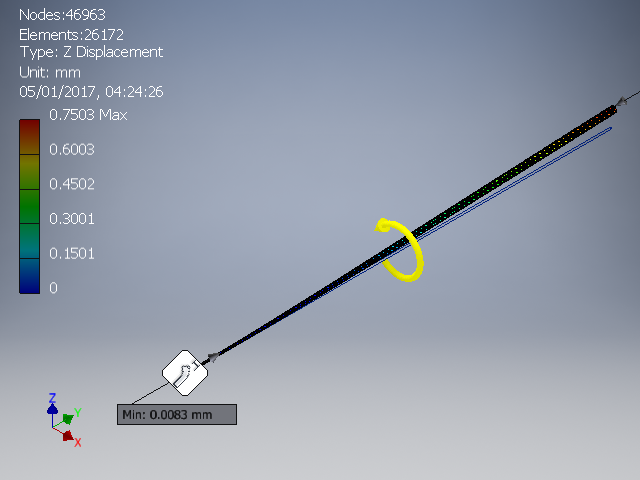
[picture p92: modelsali/Models2/Gantry/Images/Driveshaft Stress Analysis Report 05_01_2017/0/Result_0_5.png]


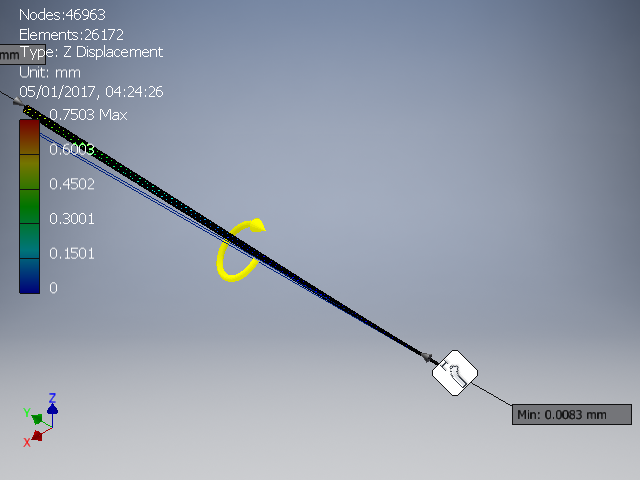
[picture p93: modelsali/Models2/Gantry/Images/Driveshaft Stress Analysis Report 05_01_2017/0/Result_0_5_rev.png]


#####  Equivalent Strain

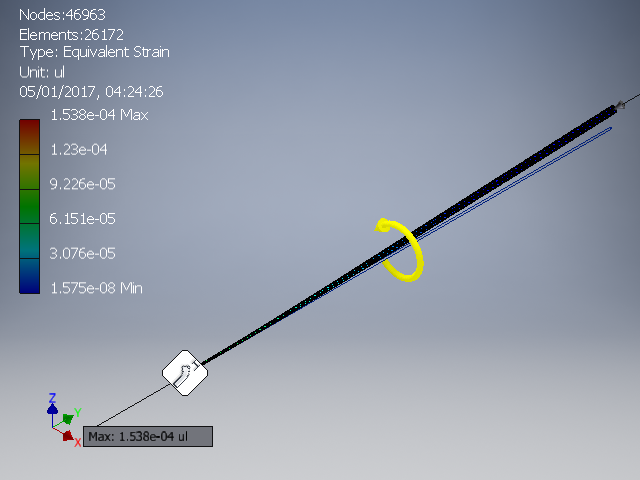
[picture p94: modelsali/Models2/Gantry/Images/Driveshaft Stress Analysis Report 05_01_2017/0/Result_0_80.png]


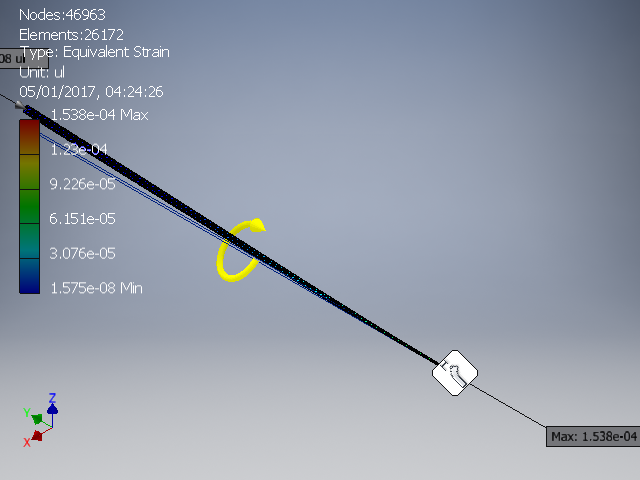
[picture p95: modelsali/Models2/Gantry/Images/Driveshaft Stress Analysis Report 05_01_2017/0/Result_0_80_rev.png]


#####  1st Principal Strain

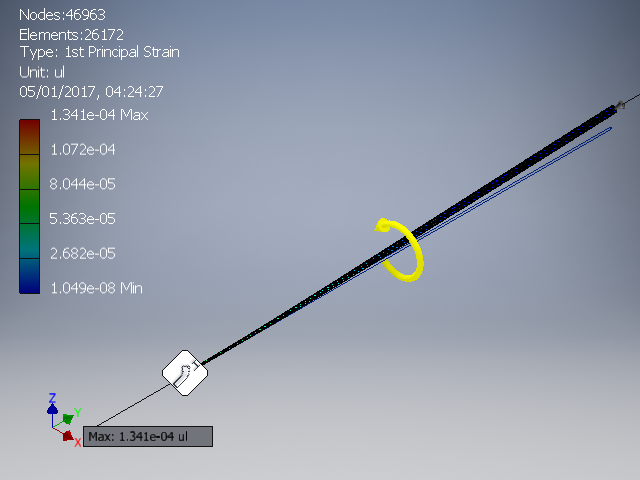
[picture p96: modelsali/Models2/Gantry/Images/Driveshaft Stress Analysis Report 05_01_2017/0/Result_0_81.png]


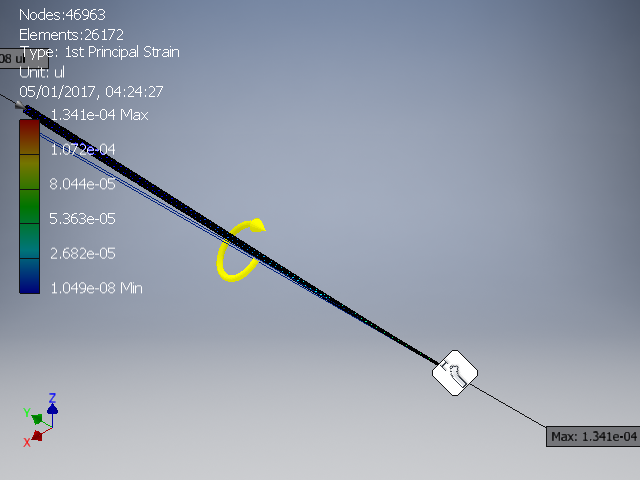
[picture p97: modelsali/Models2/Gantry/Images/Driveshaft Stress Analysis Report 05_01_2017/0/Result_0_81_rev.png]


#####  3rd Principal Strain

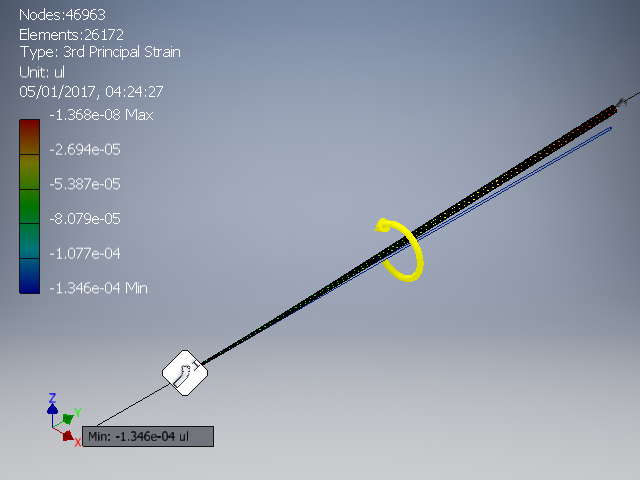
[picture p98: modelsali/Models2/Gantry/Images/Driveshaft Stress Analysis Report 05_01_2017/0/Result_0_83.png]


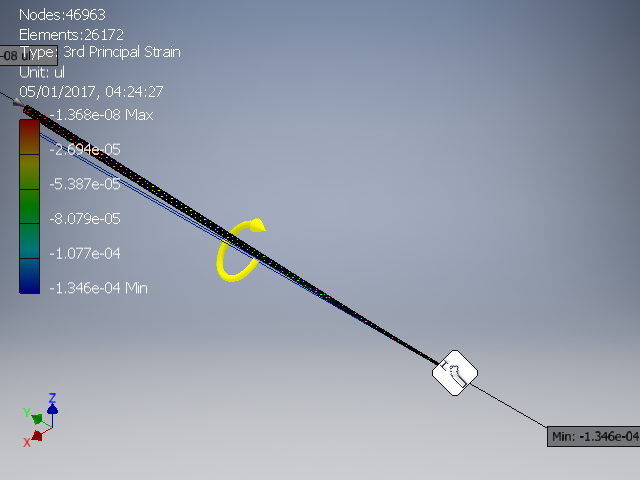
[picture p99: modelsali/Models2/Gantry/Images/Driveshaft Stress Analysis Report 05_01_2017/0/Result_0_83_rev.png]


#####  Strain XX

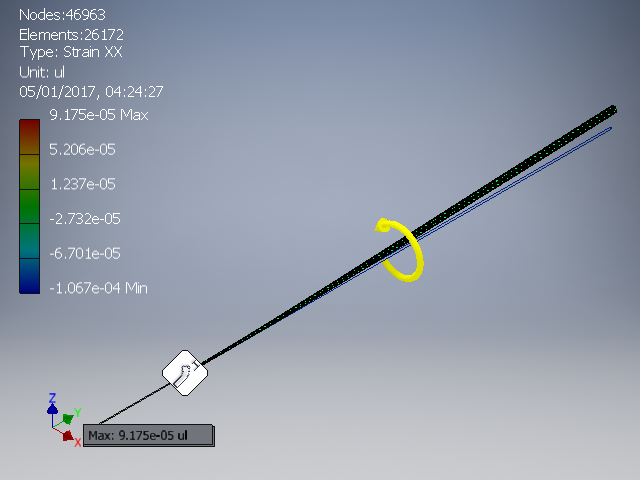
[picture p100: modelsali/Models2/Gantry/Images/Driveshaft Stress Analysis Report 05_01_2017/0/Result_0_58.png]


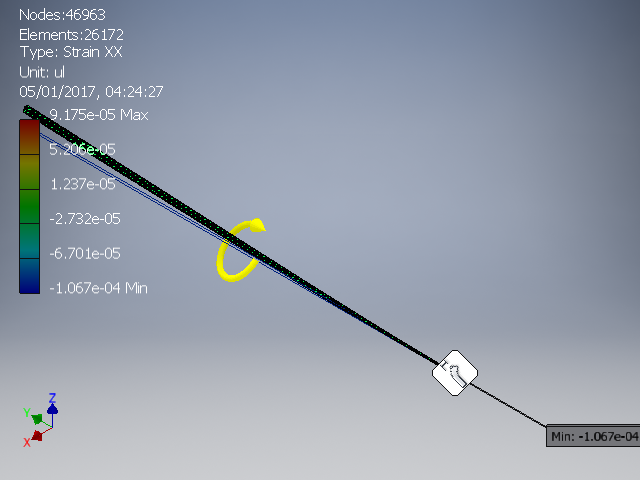
[picture p101: modelsali/Models2/Gantry/Images/Driveshaft Stress Analysis Report 05_01_2017/0/Result_0_58_rev.png]


#####  Strain XY

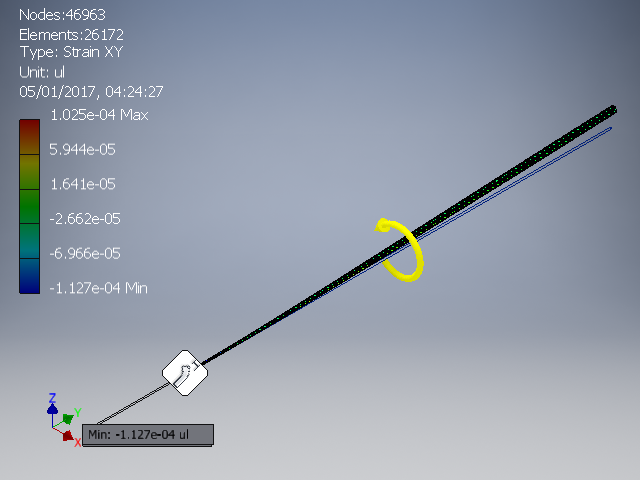
[picture p102: modelsali/Models2/Gantry/Images/Driveshaft Stress Analysis Report 05_01_2017/0/Result_0_59.png]


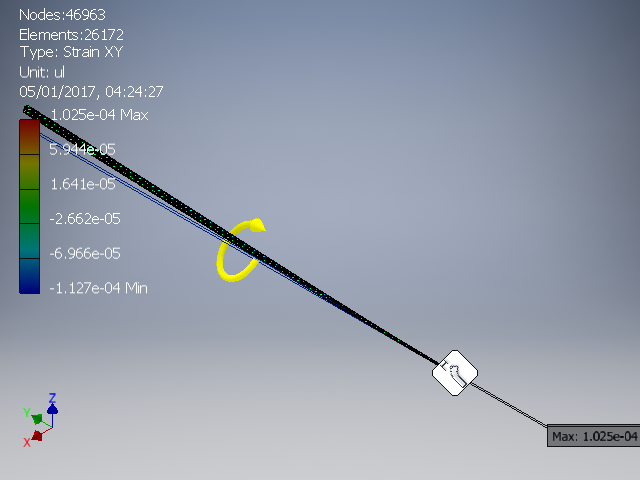
[picture p103: modelsali/Models2/Gantry/Images/Driveshaft Stress Analysis Report 05_01_2017/0/Result_0_59_rev.png]


#####  Strain XZ

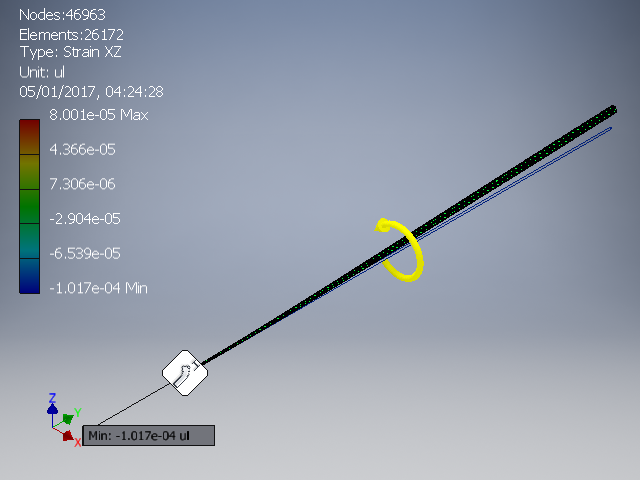
[picture p104: modelsali/Models2/Gantry/Images/Driveshaft Stress Analysis Report 05_01_2017/0/Result_0_60.png]


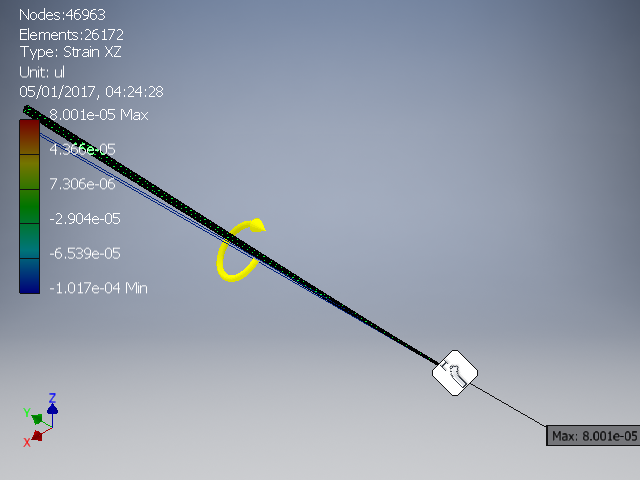
[picture p105: modelsali/Models2/Gantry/Images/Driveshaft Stress Analysis Report 05_01_2017/0/Result_0_60_rev.png]


#####  Strain YY

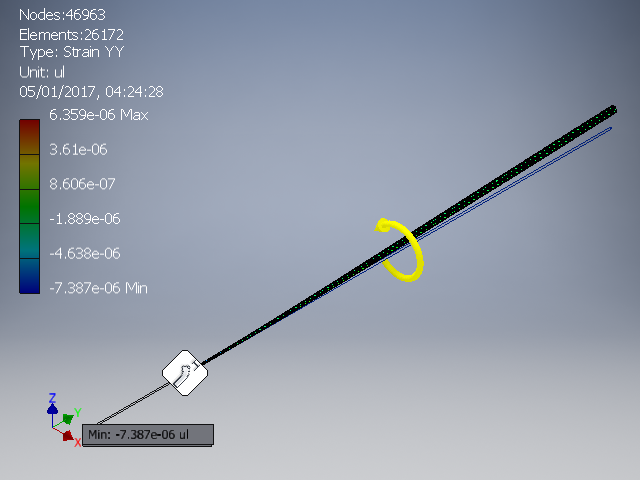
[picture p106: modelsali/Models2/Gantry/Images/Driveshaft Stress Analysis Report 05_01_2017/0/Result_0_61.png]


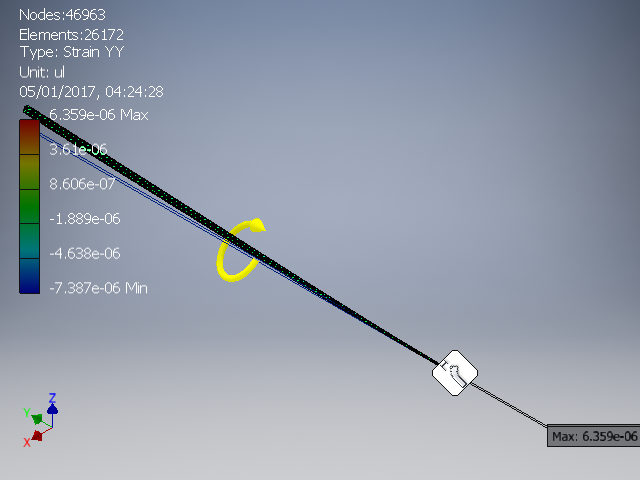
[picture p107: modelsali/Models2/Gantry/Images/Driveshaft Stress Analysis Report 05_01_2017/0/Result_0_61_rev.png]


#####  Strain YZ

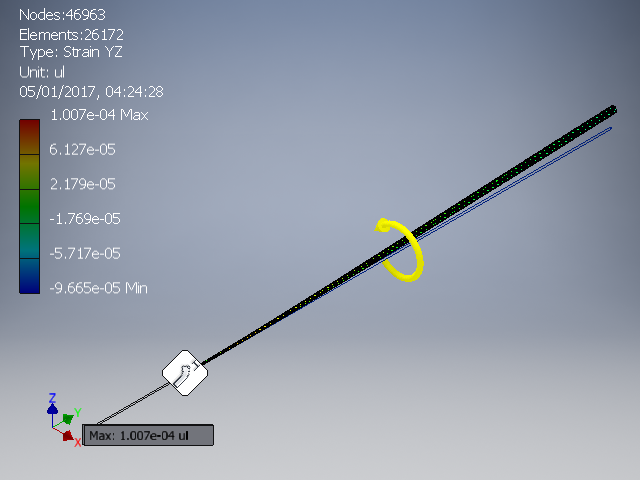
[picture p108: modelsali/Models2/Gantry/Images/Driveshaft Stress Analysis Report 05_01_2017/0/Result_0_62.png]


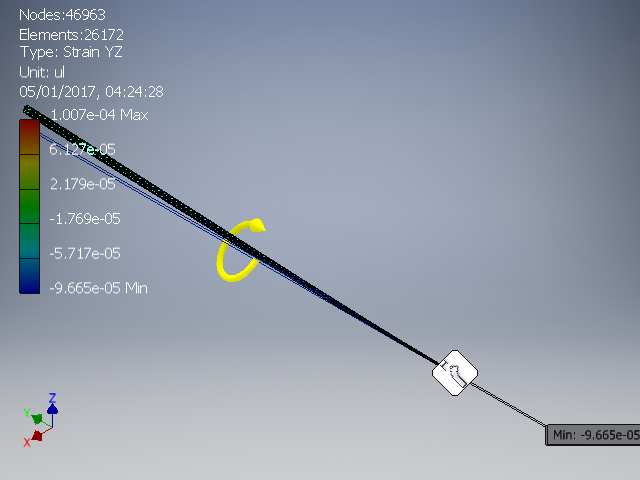
[picture p109: modelsali/Models2/Gantry/Images/Driveshaft Stress Analysis Report 05_01_2017/0/Result_0_62_rev.png]


#####  Strain ZZ

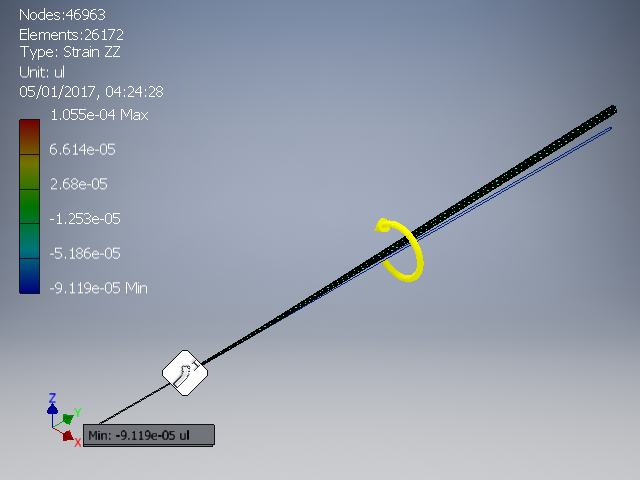
[picture p110: modelsali/Models2/Gantry/Images/Driveshaft Stress Analysis Report 05_01_2017/0/Result_0_63.png]


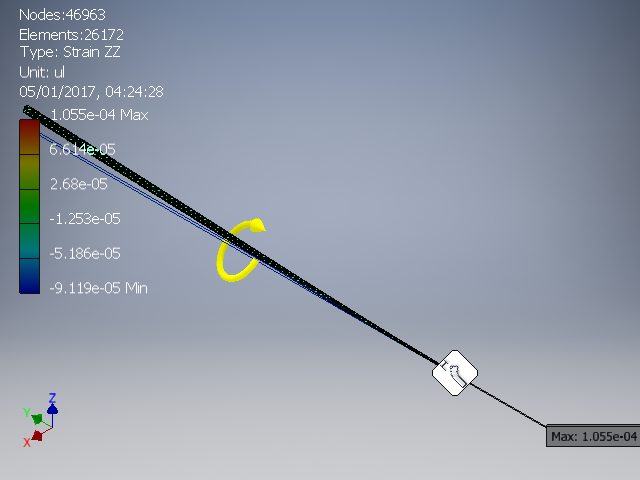
[picture p111: modelsali/Models2/Gantry/Images/Driveshaft Stress Analysis Report 05_01_2017/0/Result_0_63_rev.png]


C:\Users\Ali\Desktop\roboticFarm-master\Models2\Gantry\Driveshaft.ipt

Image Width (pixels):
