umurcg/roboticFarm/modelsali/Models2/Stress/Gantry Plate Stress Analysis Report 05_01_2017.html

Image Width (pixels):

# Stress Analysis Report



Analyzed File: | Gantry Plate.ipt
Autodesk Inventor Version: | 2017 (Build 210142000, 142)
Creation Date: | 05/01/2017, 05:47
Study Author: | Ali
Summary:

###  Project Info (iProperties)

####  Summary

Author | umr

####  Project

Part Number | Gantry Plate
Designer | umr
Cost | £0.00
Date Created | 01/04/2014

####  Status

Design Status | WorkInProgress

####  Custom

Sending System | SolidWorks 2014
Last Author | Rory
Last Saved | 21/05/2016

####  Physical

Material | SolidWorks Materials|6061 Alloy|21
Density | 2.7 g/cm^3
Mass | 0.284739 kg
Area | 46700 mm^2
Volume | 105459 mm^3
Center of Gravity | x=-80.6771 mm y=67.9083 mm z=2.5 mm

Note: Physical values could be different from Physical values used by FEA reported below.

##  Static Analysis:1

General objective and settings:

Design Objective | Single Point
Study Type | Static Analysis
Last Modification Date | 05/01/2017, 05:46
Detect and Eliminate Rigid Body Modes | No

Mesh settings:

Avg. Element Size (fraction of model diameter) | 0.1
Min. Element Size (fraction of avg. size) | 0.2
Grading Factor | 1.5
Max. Turn Angle | 60 deg
Create Curved Mesh Elements | Yes

###  Material(s)

Name | Aluminum 6061
General | Mass Density | 2.7 g/cm^3
| Yield Strength | 275 MPa
| Ultimate Tensile Strength | 310 MPa
Stress | Young's Modulus | 68.9 GPa
| Poisson's Ratio | 0.33 ul
| Shear Modulus | 25.9023 GPa
Part Name(s) | Gantry Plate

###  Operating conditions

####  Force:1

Load Type | Force
Magnitude | 200.000 N
Vector X | 0.000 N
Vector Y | -200.000 N
Vector Z | 0.000 N

#####  Selected Face(s)

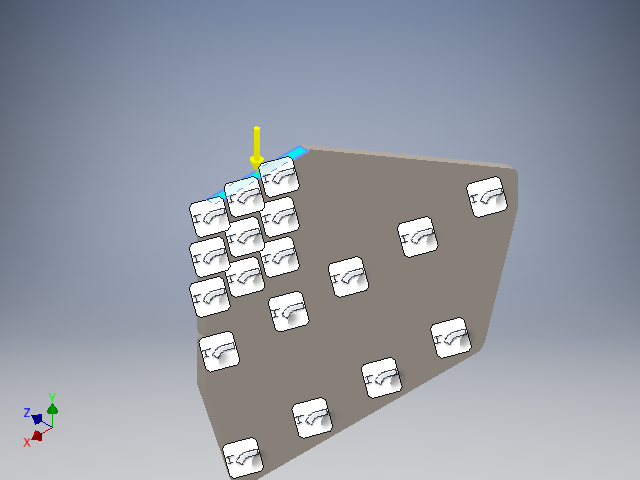
[picture p112: modelsali/Models2/Stress/Images/Gantry Plate Stress Analysis Report 05_01_2017/0/Load_0_1.png]


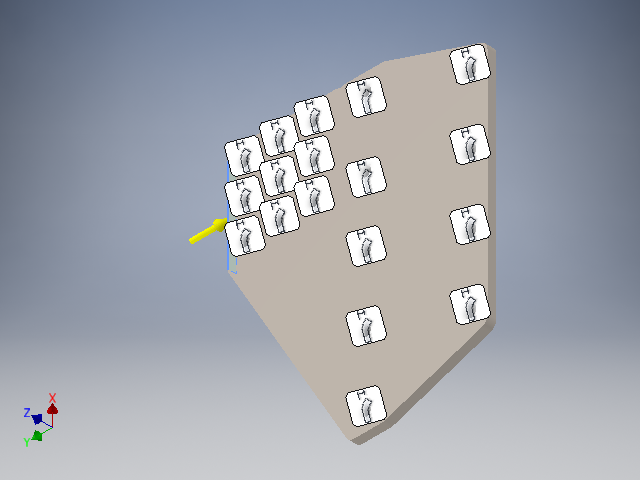
[picture p113: modelsali/Models2/Stress/Images/Gantry Plate Stress Analysis Report 05_01_2017/0/Load_0_1_rev.png]


####  Fixed Constraint:1

Constraint Type | Fixed Constraint

#####  Selected Face(s)

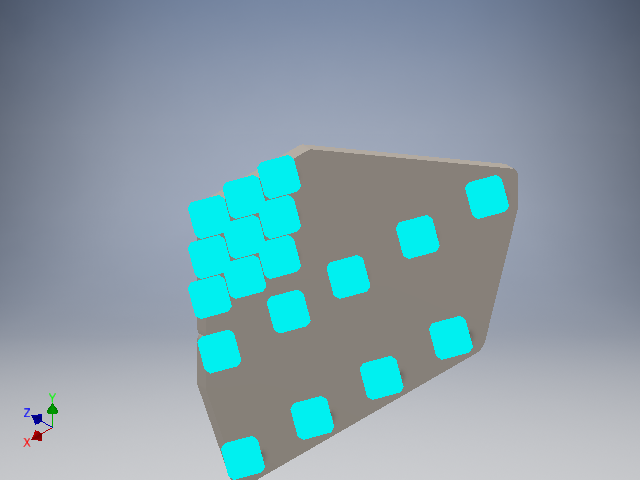
[picture p114: modelsali/Models2/Stress/Images/Gantry Plate Stress Analysis Report 05_01_2017/0/Constraint_0_0.png]


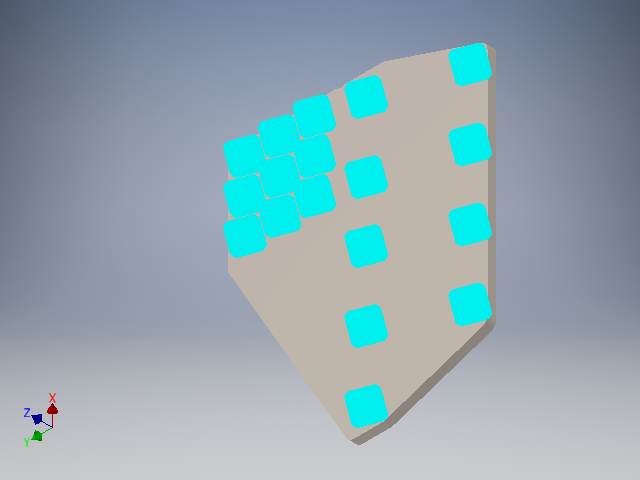
[picture p115: modelsali/Models2/Stress/Images/Gantry Plate Stress Analysis Report 05_01_2017/0/Constraint_0_0_rev.png]


###  Results

####  Reaction Force and Moment on Constraints

Constraint Name | Reaction Force | | Reaction Moment
| Magnitude | Component (X,Y,Z) | Magnitude | Component (X,Y,Z)
Fixed Constraint:1 | 200 N | 0 N | 6.03862 N m | 0.500393 N m
| | 200 N | | 0 N m
| | 0 N | | 6.01785 N m

####  Result Summary

Name | Minimum | Maximum
Volume | 105459 mm^3
Mass | 0.284739 kg
Von Mises Stress | 0.000415616 MPa | 7.76232 MPa
1st Principal Stress | -0.977927 MPa | 6.36483 MPa
3rd Principal Stress | -7.03118 MPa | 0.38019 MPa
Displacement | 0 mm | 0.000561821 mm
Safety Factor | 15 ul | 15 ul
Stress XX | -1.8933 MPa | 2.23893 MPa
Stress XY | -3.1212 MPa | 2.85202 MPa
Stress XZ | -1.70719 MPa | 1.54829 MPa
Stress YY | -6.90479 MPa | 5.10206 MPa
Stress YZ | -0.158316 MPa | 2.76185 MPa
Stress ZZ | -1.49075 MPa | 2.47959 MPa
X Displacement | -0.0000376145 mm | 0.0000924481 mm
Y Displacement | -0.000391651 mm | 0 mm
Z Displacement | -0.000402845 mm | 0.000126073 mm
Equivalent Strain | 0.00000000539467 ul | 0.000100275 ul
1st Principal Strain | 0.00000000479784 ul | 0.0000985865 ul
3rd Principal Strain | -0.0000966369 ul | -0.00000000440666 ul
Strain XX | -0.0000211852 ul | 0.0000312625 ul
Strain XY | -0.0000602495 ul | 0.0000550534 ul
Strain XZ | -0.0000329544 ul | 0.0000298873 ul
Strain YY | -0.0000941973 ul | 0.0000651361 ul
Strain YZ | -0.00000305603 ul | 0.0000533129 ul
Strain ZZ | -0.0000223475 ul | 0.0000532302 ul

####  Figures

#####  Von Mises Stress

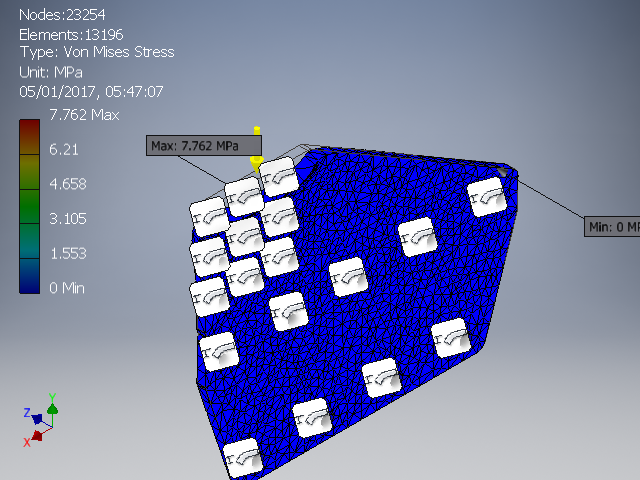
[picture p116: modelsali/Models2/Stress/Images/Gantry Plate Stress Analysis Report 05_01_2017/0/Result_0_1.png]


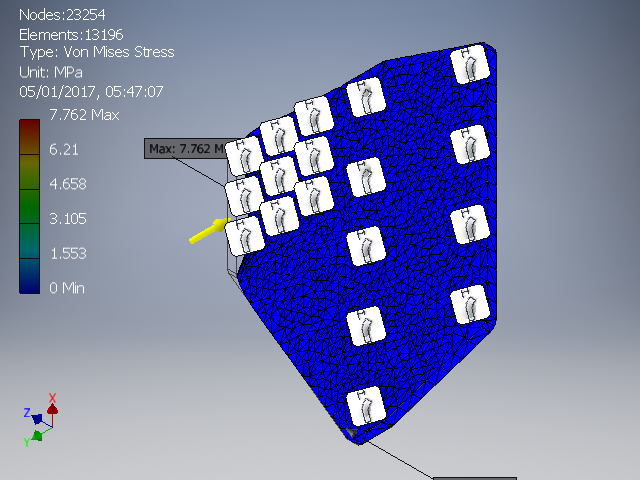
[picture p117: modelsali/Models2/Stress/Images/Gantry Plate Stress Analysis Report 05_01_2017/0/Result_0_1_rev.png]


#####  1st Principal Stress

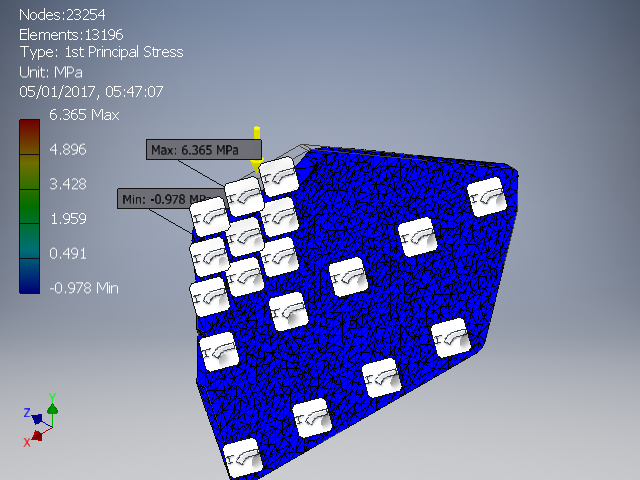
[picture p118: modelsali/Models2/Stress/Images/Gantry Plate Stress Analysis Report 05_01_2017/0/Result_0_6.png]


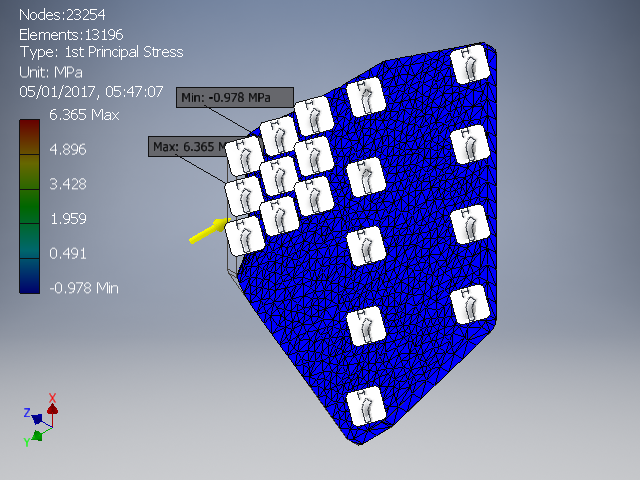
[picture p119: modelsali/Models2/Stress/Images/Gantry Plate Stress Analysis Report 05_01_2017/0/Result_0_6_rev.png]


#####  3rd Principal Stress

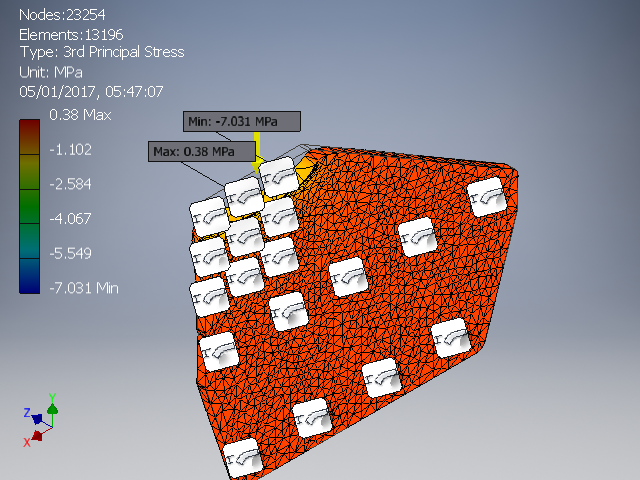
[picture p120: modelsali/Models2/Stress/Images/Gantry Plate Stress Analysis Report 05_01_2017/0/Result_0_8.png]


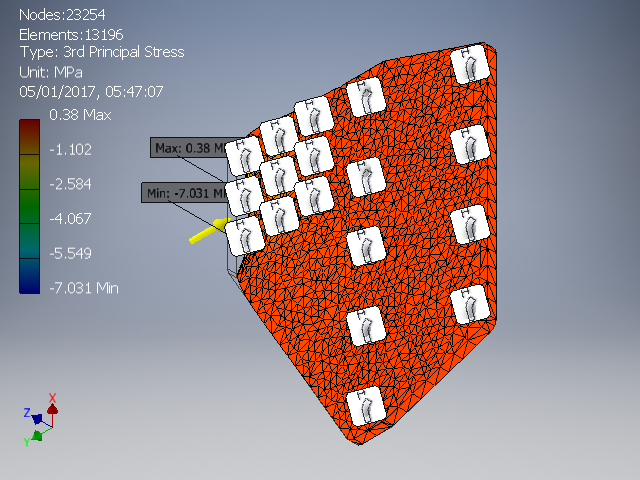
[picture p121: modelsali/Models2/Stress/Images/Gantry Plate Stress Analysis Report 05_01_2017/0/Result_0_8_rev.png]


#####  Displacement

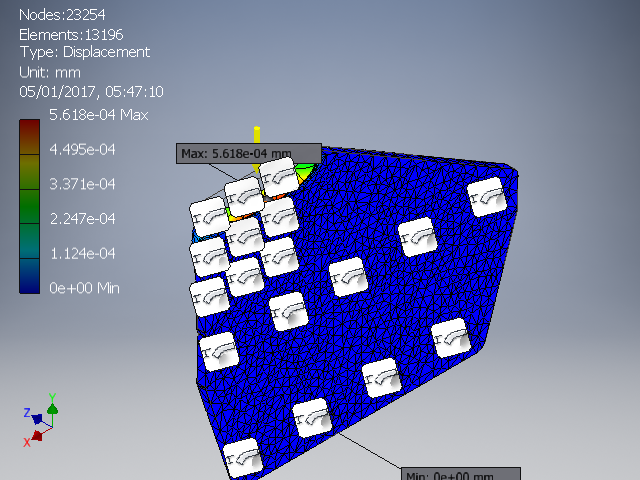
[picture p122: modelsali/Models2/Stress/Images/Gantry Plate Stress Analysis Report 05_01_2017/0/Result_0_2.png]


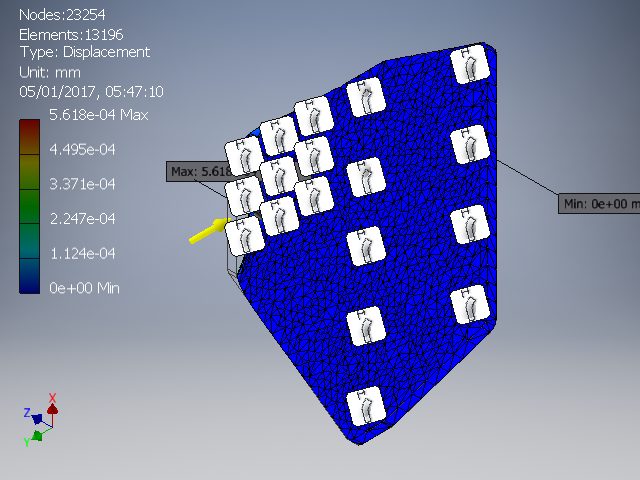
[picture p123: modelsali/Models2/Stress/Images/Gantry Plate Stress Analysis Report 05_01_2017/0/Result_0_2_rev.png]


#####  Safety Factor

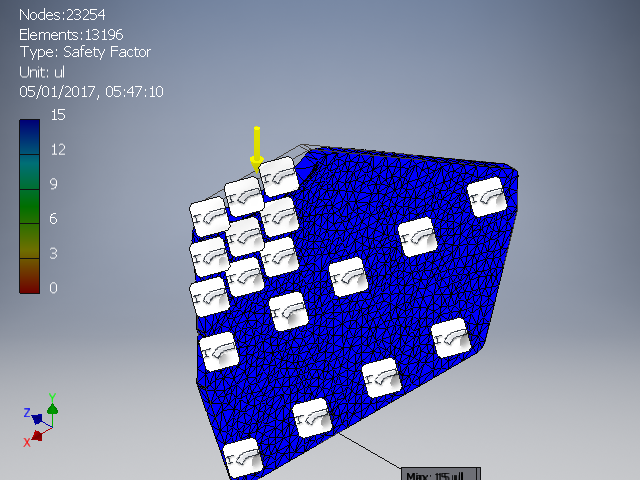
[picture p124: modelsali/Models2/Stress/Images/Gantry Plate Stress Analysis Report 05_01_2017/0/Result_0_57.png]


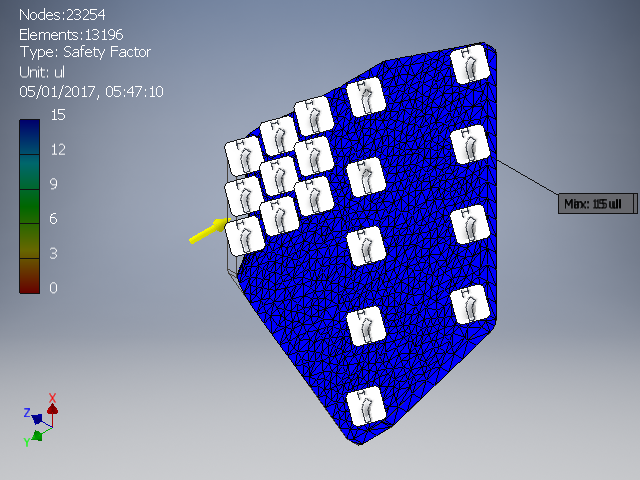
[picture p125: modelsali/Models2/Stress/Images/Gantry Plate Stress Analysis Report 05_01_2017/0/Result_0_57_rev.png]


#####  Stress XX

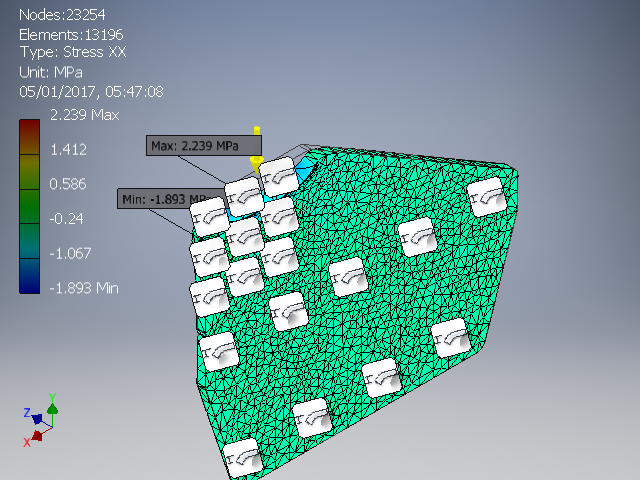
[picture p126: modelsali/Models2/Stress/Images/Gantry Plate Stress Analysis Report 05_01_2017/0/Result_0_9.png]


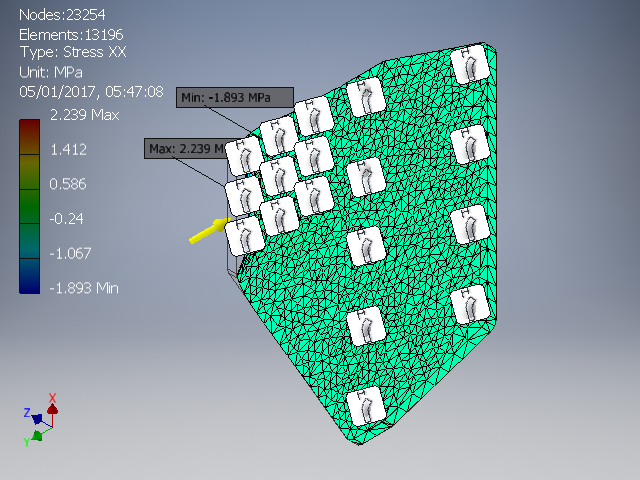
[picture p127: modelsali/Models2/Stress/Images/Gantry Plate Stress Analysis Report 05_01_2017/0/Result_0_9_rev.png]


#####  Stress XY

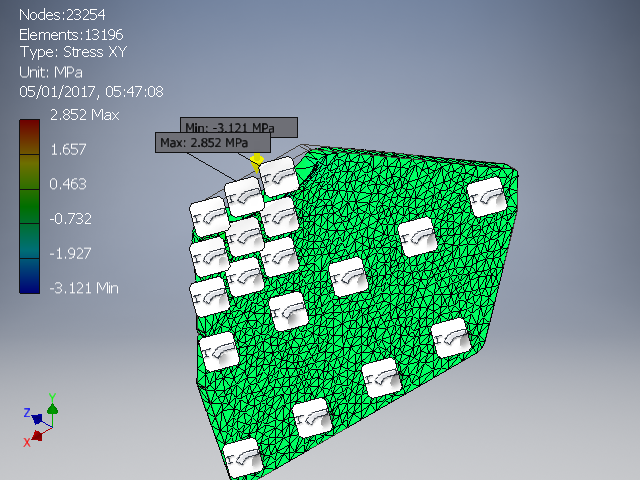
[picture p128: modelsali/Models2/Stress/Images/Gantry Plate Stress Analysis Report 05_01_2017/0/Result_0_10.png]


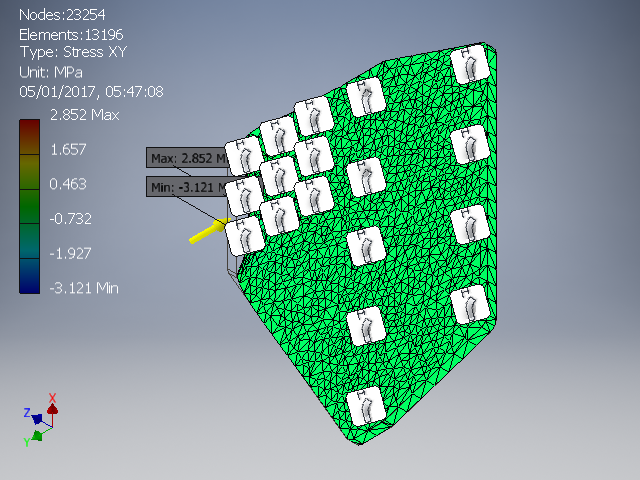
[picture p129: modelsali/Models2/Stress/Images/Gantry Plate Stress Analysis Report 05_01_2017/0/Result_0_10_rev.png]


#####  Stress XZ

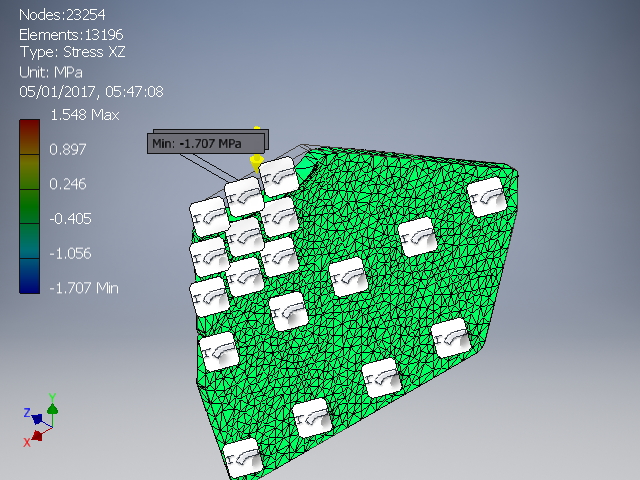
[picture p130: modelsali/Models2/Stress/Images/Gantry Plate Stress Analysis Report 05_01_2017/0/Result_0_11.png]


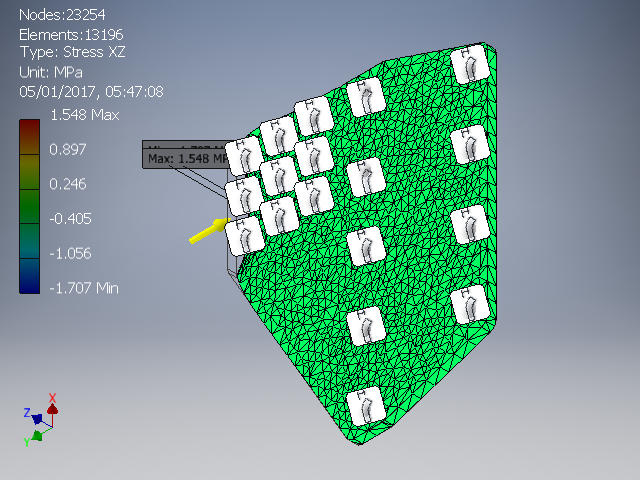
[picture p131: modelsali/Models2/Stress/Images/Gantry Plate Stress Analysis Report 05_01_2017/0/Result_0_11_rev.png]


#####  Stress YY

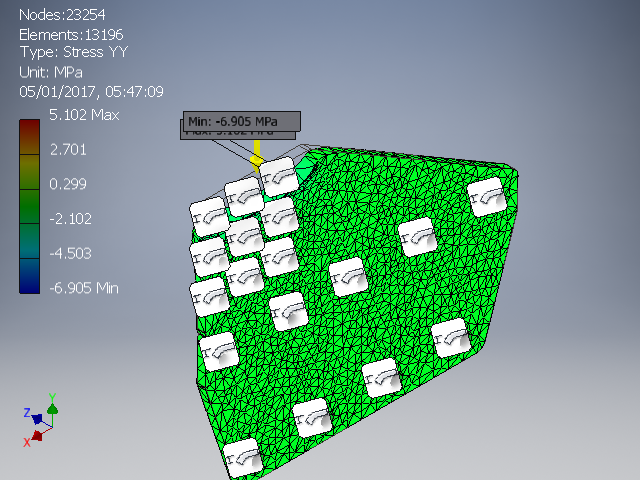
[picture p132: modelsali/Models2/Stress/Images/Gantry Plate Stress Analysis Report 05_01_2017/0/Result_0_12.png]


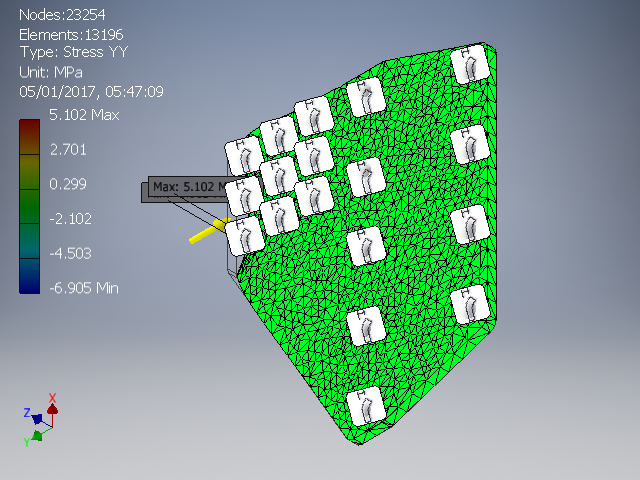
[picture p133: modelsali/Models2/Stress/Images/Gantry Plate Stress Analysis Report 05_01_2017/0/Result_0_12_rev.png]


#####  Stress YZ

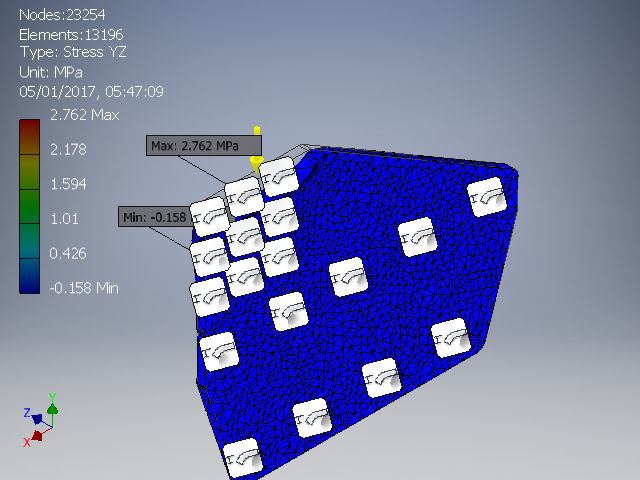
[picture p134: modelsali/Models2/Stress/Images/Gantry Plate Stress Analysis Report 05_01_2017/0/Result_0_13.png]


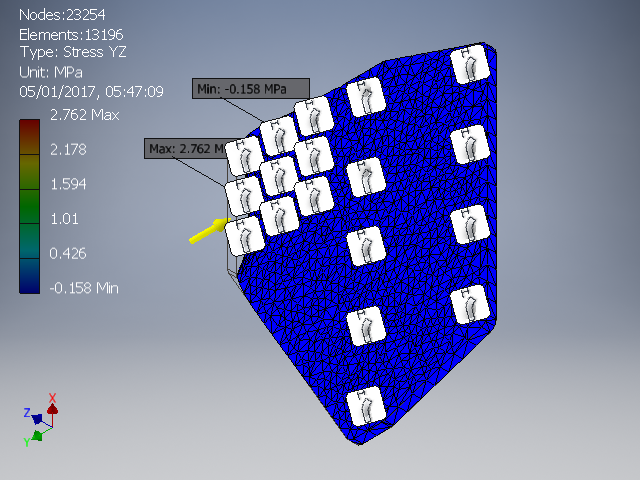
[picture p135: modelsali/Models2/Stress/Images/Gantry Plate Stress Analysis Report 05_01_2017/0/Result_0_13_rev.png]


#####  Stress ZZ

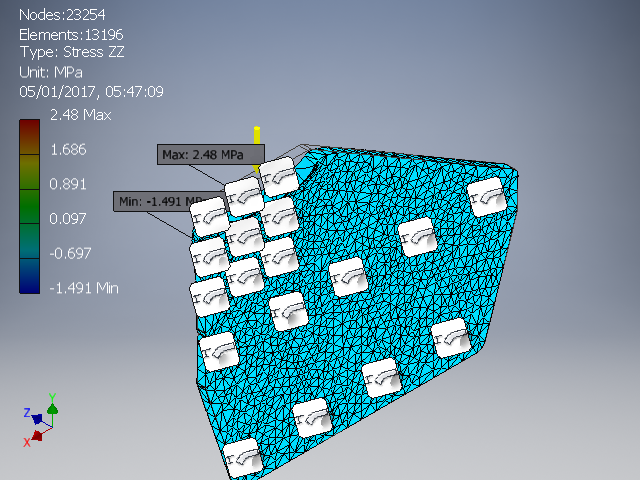
[picture p136: modelsali/Models2/Stress/Images/Gantry Plate Stress Analysis Report 05_01_2017/0/Result_0_14.png]


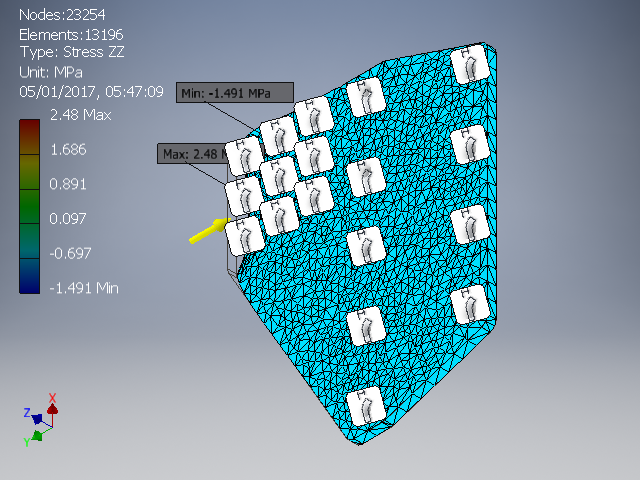
[picture p137: modelsali/Models2/Stress/Images/Gantry Plate Stress Analysis Report 05_01_2017/0/Result_0_14_rev.png]


#####  X Displacement

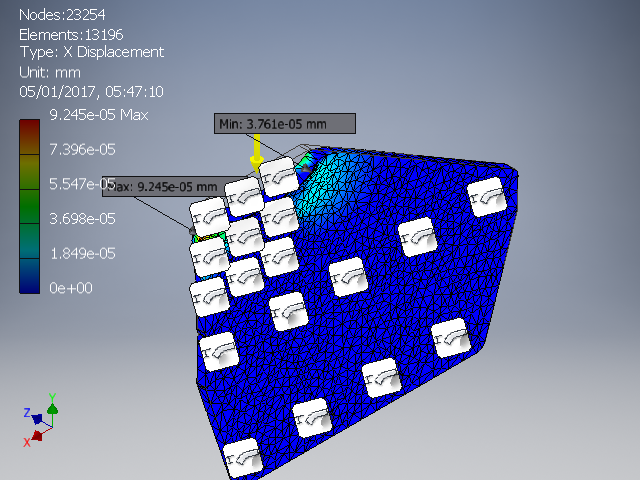
[picture p138: modelsali/Models2/Stress/Images/Gantry Plate Stress Analysis Report 05_01_2017/0/Result_0_3.png]


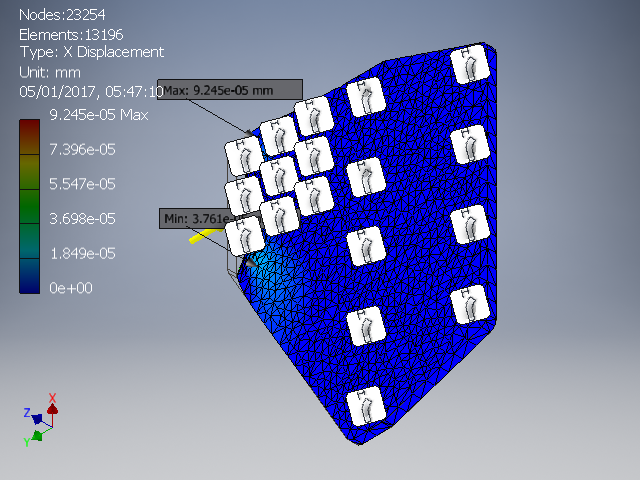
[picture p139: modelsali/Models2/Stress/Images/Gantry Plate Stress Analysis Report 05_01_2017/0/Result_0_3_rev.png]


#####  Y Displacement

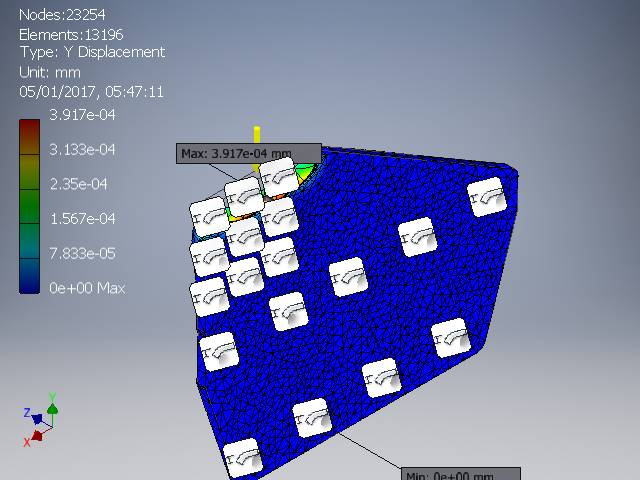
[picture p140: modelsali/Models2/Stress/Images/Gantry Plate Stress Analysis Report 05_01_2017/0/Result_0_4.png]


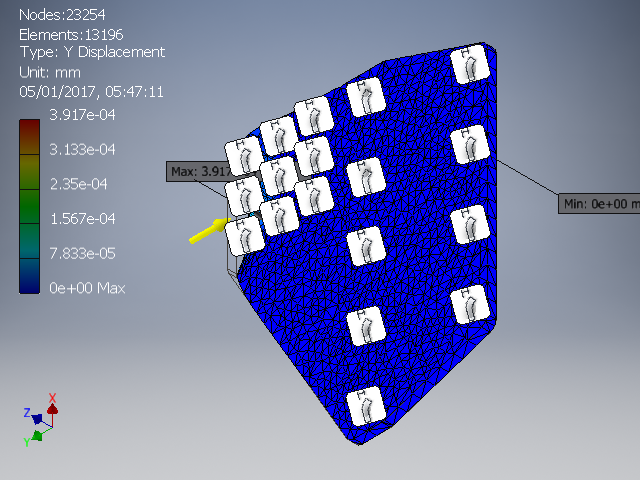
[picture p141: modelsali/Models2/Stress/Images/Gantry Plate Stress Analysis Report 05_01_2017/0/Result_0_4_rev.png]


#####  Z Displacement

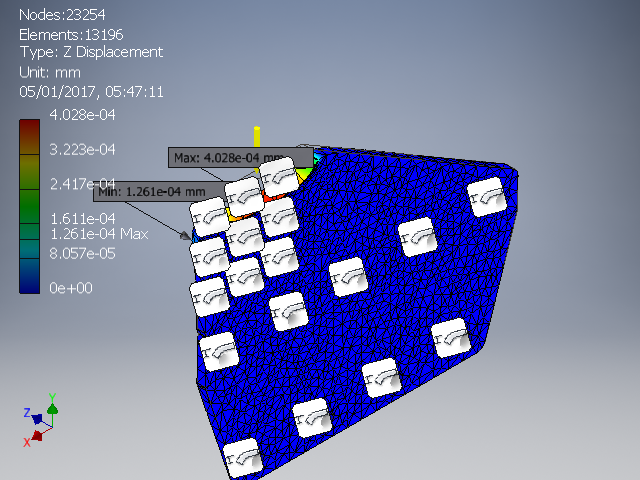
[picture p142: modelsali/Models2/Stress/Images/Gantry Plate Stress Analysis Report 05_01_2017/0/Result_0_5.png]


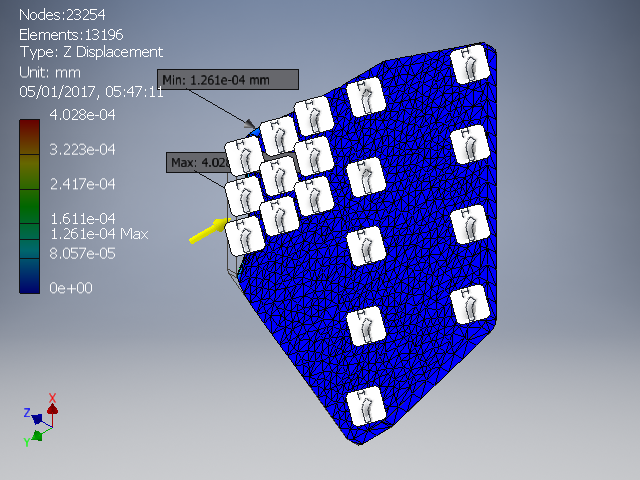
[picture p143: modelsali/Models2/Stress/Images/Gantry Plate Stress Analysis Report 05_01_2017/0/Result_0_5_rev.png]


#####  Equivalent Strain

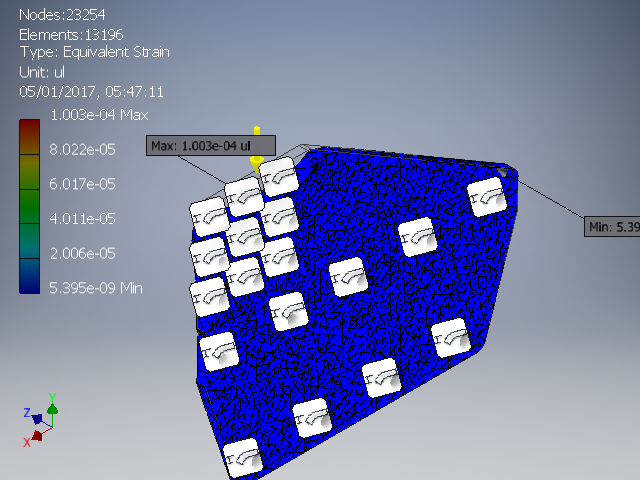
[picture p144: modelsali/Models2/Stress/Images/Gantry Plate Stress Analysis Report 05_01_2017/0/Result_0_80.png]


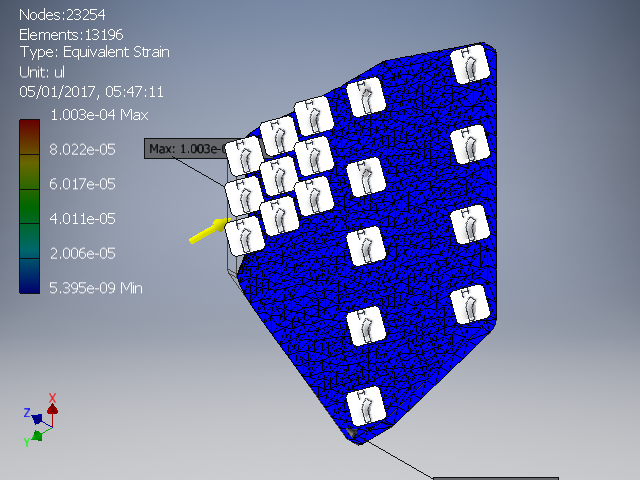
[picture p145: modelsali/Models2/Stress/Images/Gantry Plate Stress Analysis Report 05_01_2017/0/Result_0_80_rev.png]


#####  1st Principal Strain

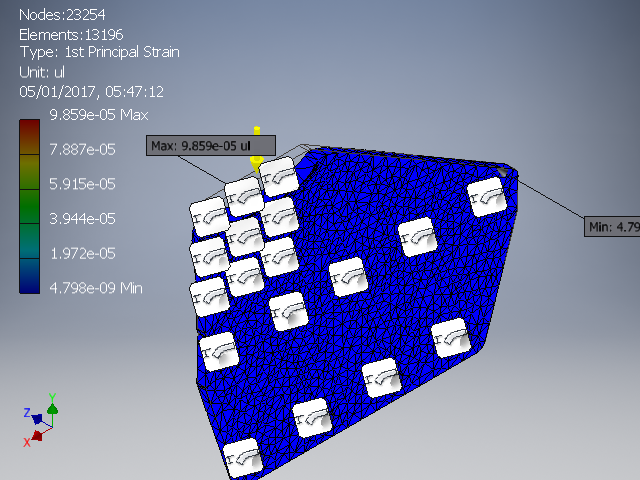
[picture p146: modelsali/Models2/Stress/Images/Gantry Plate Stress Analysis Report 05_01_2017/0/Result_0_81.png]


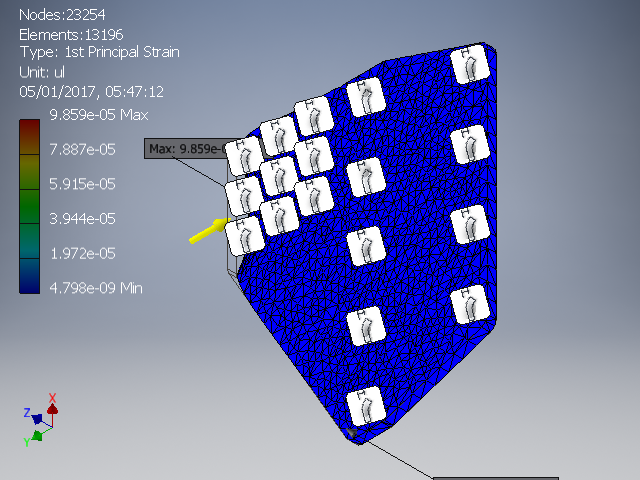
[picture p147: modelsali/Models2/Stress/Images/Gantry Plate Stress Analysis Report 05_01_2017/0/Result_0_81_rev.png]


#####  3rd Principal Strain

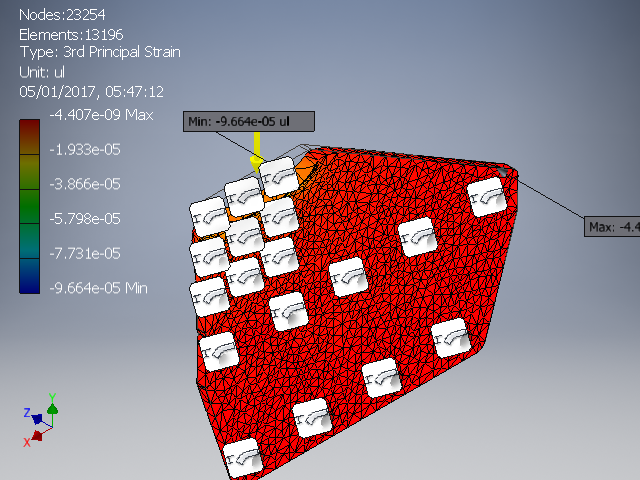
[picture p148: modelsali/Models2/Stress/Images/Gantry Plate Stress Analysis Report 05_01_2017/0/Result_0_83.png]


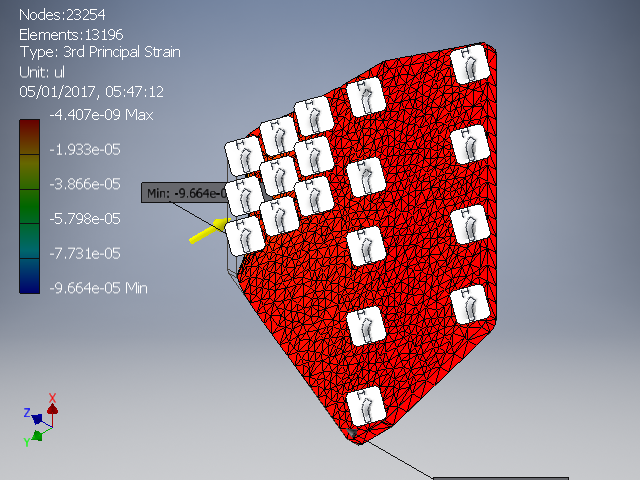
[picture p149: modelsali/Models2/Stress/Images/Gantry Plate Stress Analysis Report 05_01_2017/0/Result_0_83_rev.png]


#####  Strain XX

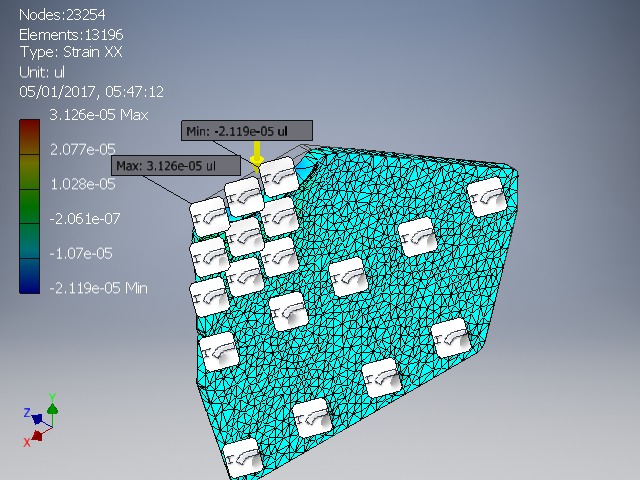
[picture p150: modelsali/Models2/Stress/Images/Gantry Plate Stress Analysis Report 05_01_2017/0/Result_0_58.png]


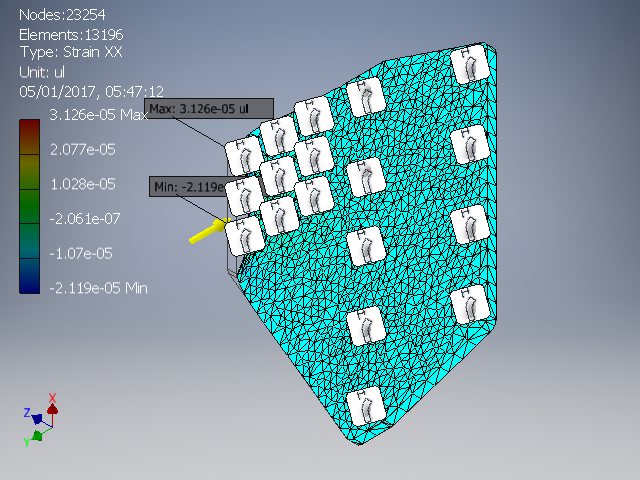
[picture p151: modelsali/Models2/Stress/Images/Gantry Plate Stress Analysis Report 05_01_2017/0/Result_0_58_rev.png]


#####  Strain XY

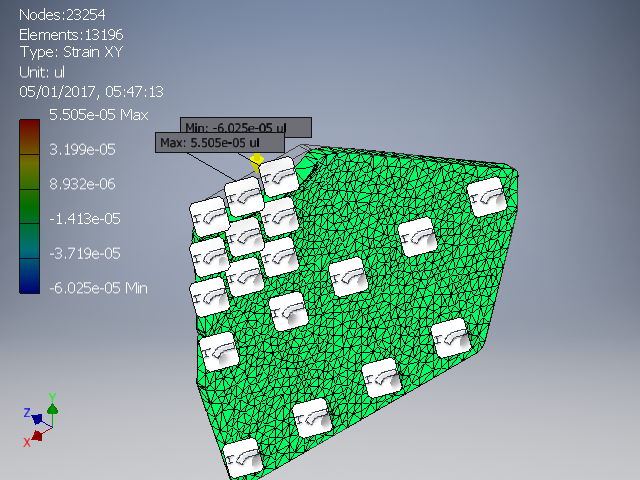
[picture p152: modelsali/Models2/Stress/Images/Gantry Plate Stress Analysis Report 05_01_2017/0/Result_0_59.png]


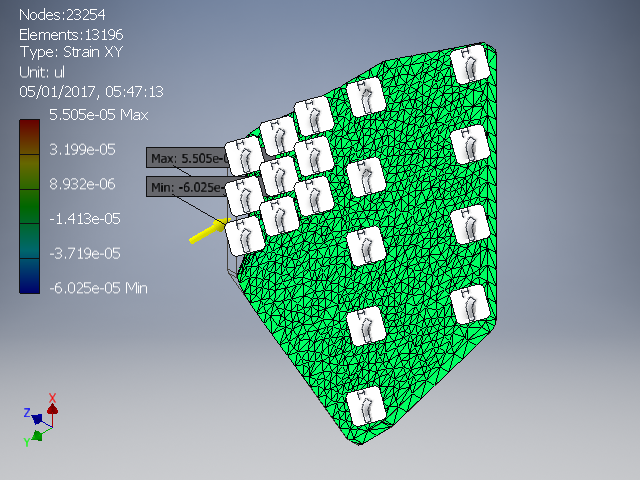
[picture p153: modelsali/Models2/Stress/Images/Gantry Plate Stress Analysis Report 05_01_2017/0/Result_0_59_rev.png]


#####  Strain XZ

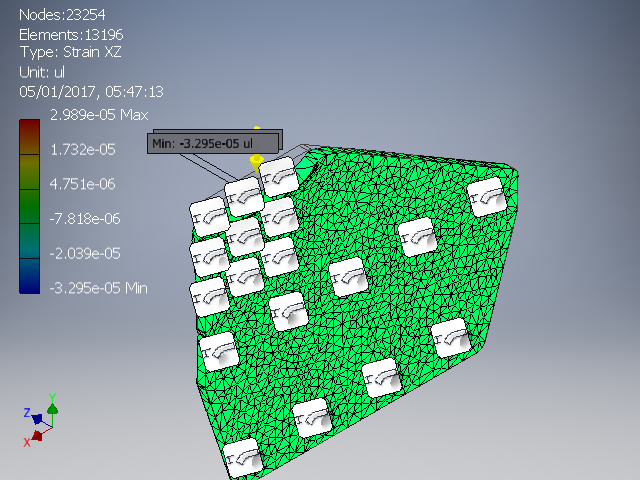
[picture p154: modelsali/Models2/Stress/Images/Gantry Plate Stress Analysis Report 05_01_2017/0/Result_0_60.png]


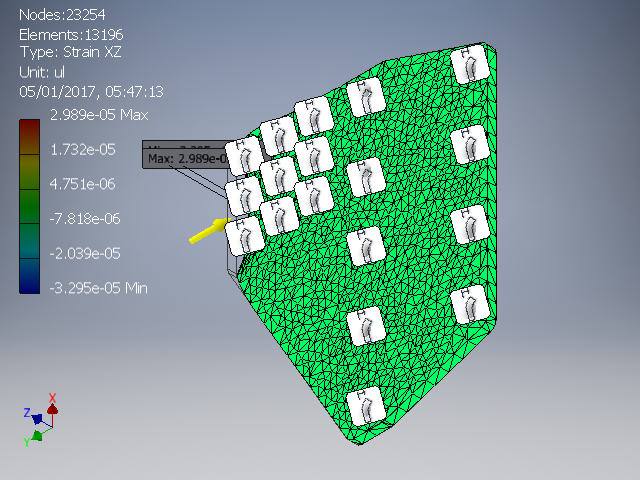
[picture p155: modelsali/Models2/Stress/Images/Gantry Plate Stress Analysis Report 05_01_2017/0/Result_0_60_rev.png]


#####  Strain YY

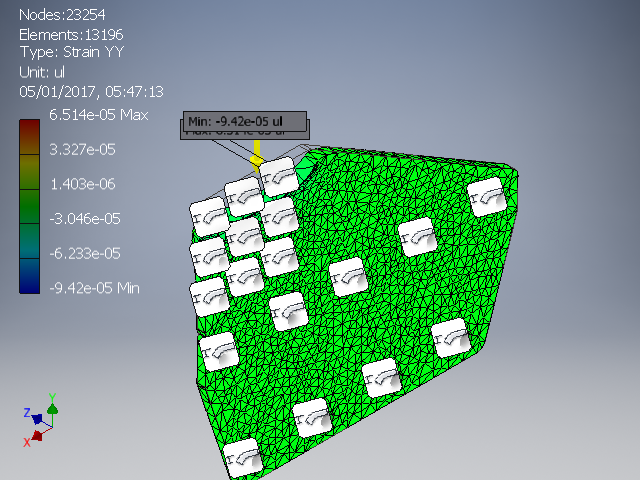
[picture p156: modelsali/Models2/Stress/Images/Gantry Plate Stress Analysis Report 05_01_2017/0/Result_0_61.png]


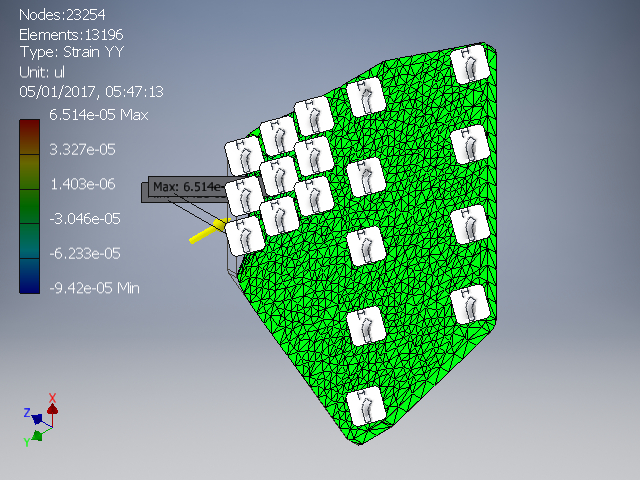
[picture p157: modelsali/Models2/Stress/Images/Gantry Plate Stress Analysis Report 05_01_2017/0/Result_0_61_rev.png]


#####  Strain YZ

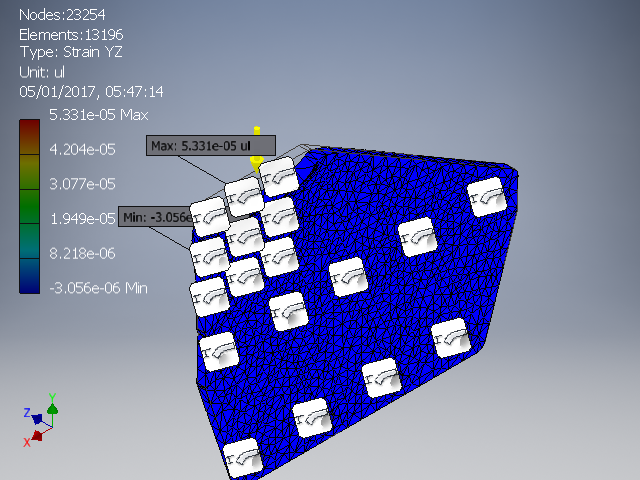
[picture p158: modelsali/Models2/Stress/Images/Gantry Plate Stress Analysis Report 05_01_2017/0/Result_0_62.png]


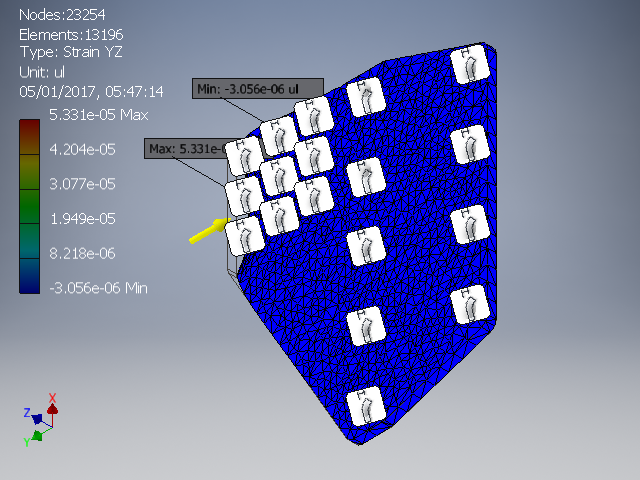
[picture p159: modelsali/Models2/Stress/Images/Gantry Plate Stress Analysis Report 05_01_2017/0/Result_0_62_rev.png]


#####  Strain ZZ

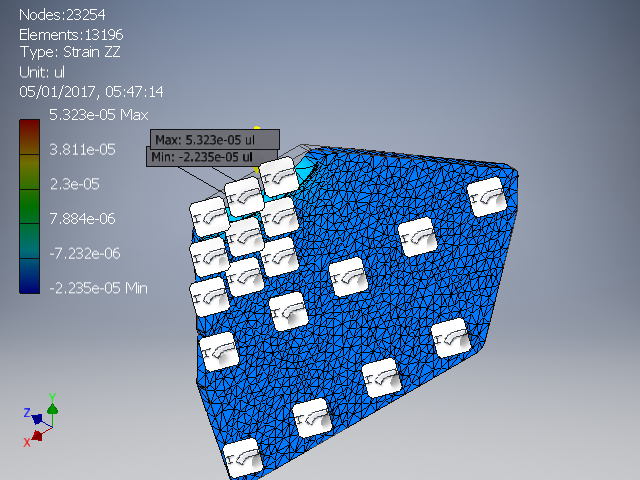
[picture p160: modelsali/Models2/Stress/Images/Gantry Plate Stress Analysis Report 05_01_2017/0/Result_0_63.png]


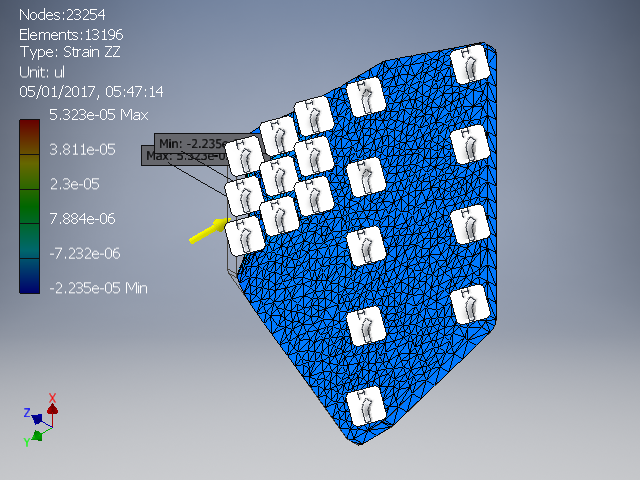
[picture p161: modelsali/Models2/Stress/Images/Gantry Plate Stress Analysis Report 05_01_2017/0/Result_0_63_rev.png]


C:\Users\Ali\Desktop\roboticFarm-master\Models2\Gantry\Gantry Plate.ipt

Image Width (pixels):
