umurcg/roboticFarm/modelsali/Models2/Stress/L_Fixer2 Stress Analysis Report 05_01_2017.html

Image Width (pixels):

# Stress Analysis Report



Analyzed File: | L_Fixer2.ipt
Autodesk Inventor Version: | 2017 (Build 210142000, 142)
Creation Date: | 05/01/2017, 05:30
Study Author: | Ali
Summary:

###  Project Info (iProperties)

####  Summary

Author | umr

####  Project

Part Number | L_Fixer2
Designer | umr
Cost | £0.00
Date Created | 12/12/2016

####  Status

Design Status | WorkInProgress

####  Physical

Material | Steel, Carbon
Density | 7.85 g/cm^3
Mass | 0.133255 kg
Area | 7244.37 mm^2
Volume | 16975.2 mm^3
Center of Gravity | x=-28.0969 mm y=11.9031 mm z=-20 mm

Note: Physical values could be different from Physical values used by FEA reported below.

##  Static Analysis:1

General objective and settings:

Design Objective | Single Point
Study Type | Static Analysis
Last Modification Date | 05/01/2017, 05:29
Detect and Eliminate Rigid Body Modes | No

Mesh settings:

Avg. Element Size (fraction of model diameter) | 0.1
Min. Element Size (fraction of avg. size) | 0.2
Grading Factor | 1.5
Max. Turn Angle | 60 deg
Create Curved Mesh Elements | Yes

###  Material(s)

Name | Aluminum 6061
General | Mass Density | 2.7 g/cm^3
| Yield Strength | 275 MPa
| Ultimate Tensile Strength | 310 MPa
Stress | Young's Modulus | 68.9 GPa
| Poisson's Ratio | 0.33 ul
| Shear Modulus | 25.9023 GPa
Part Name(s) | L_Fixer2

###  Operating conditions

####  Force:1

Load Type | Force
Magnitude | 100.000 N
Vector X | 0.000 N
Vector Y | -100.000 N
Vector Z | 0.000 N

#####  Selected Face(s)

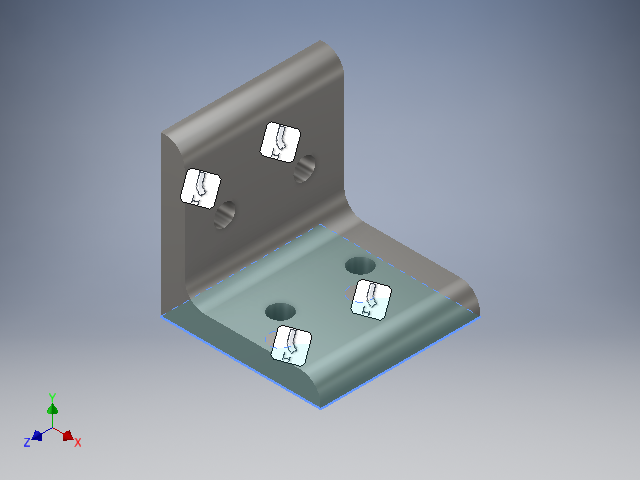
[picture p162: modelsali/Models2/Stress/Images/L_Fixer2 Stress Analysis Report 05_01_2017/0/Load_0_1.png]


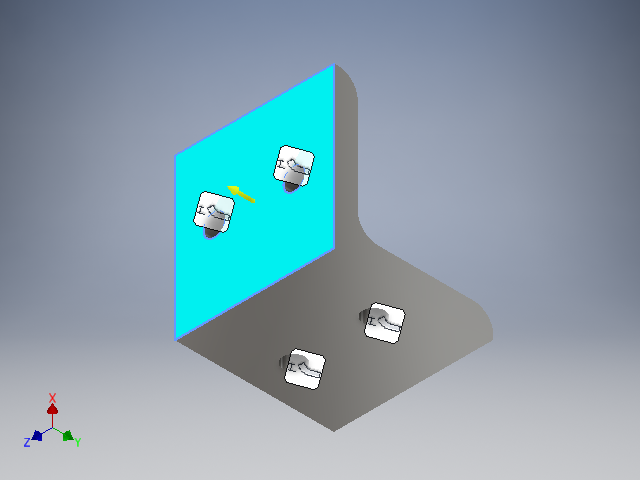
[picture p163: modelsali/Models2/Stress/Images/L_Fixer2 Stress Analysis Report 05_01_2017/0/Load_0_1_rev.png]


####  Fixed Constraint:1

Constraint Type | Fixed Constraint

#####  Selected Face(s)

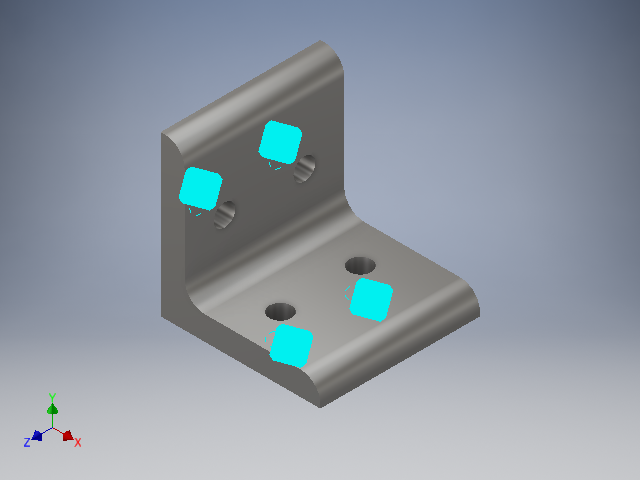
[picture p164: modelsali/Models2/Stress/Images/L_Fixer2 Stress Analysis Report 05_01_2017/0/Constraint_0_0.png]


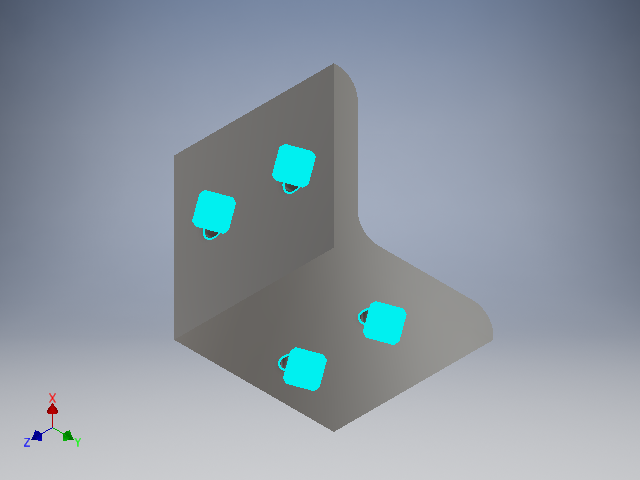
[picture p165: modelsali/Models2/Stress/Images/L_Fixer2 Stress Analysis Report 05_01_2017/0/Constraint_0_0_rev.png]


###  Results

####  Reaction Force and Moment on Constraints

Constraint Name | Reaction Force | | Reaction Moment
| Magnitude | Component (X,Y,Z) | Magnitude | Component (X,Y,Z)
Fixed Constraint:1 | 100 N | 0 N | 0.999976 N m | 0 N m
| | 100 N | | 0 N m
| | 0 N | | 0.999976 N m

####  Result Summary

Name | Minimum | Maximum
Volume | 16975.2 mm^3
Mass | 0.045833 kg
Von Mises Stress | 0.0000984153 MPa | 7.09274 MPa
1st Principal Stress | -2.6477 MPa | 3.27225 MPa
3rd Principal Stress | -9.83236 MPa | 0.481645 MPa
Displacement | 0 mm | 0.00193483 mm
Safety Factor | 15 ul | 15 ul
Stress XX | -5.51116 MPa | 3.24438 MPa
Stress XY | -3.51245 MPa | 1.60355 MPa
Stress XZ | -1.17048 MPa | 1.18169 MPa
Stress YY | -7.83987 MPa | 1.016 MPa
Stress YZ | -2.33734 MPa | 2.7863 MPa
Stress ZZ | -4.16225 MPa | 1.3433 MPa
X Displacement | -0.000159672 mm | 0.000476563 mm
Y Displacement | -0.00192834 mm | 0.0000593304 mm
Z Displacement | -0.0000386429 mm | 0.0000384902 mm
Equivalent Strain | 0.00000000128859 ul | 0.0000983227 ul
1st Principal Strain | 0.00000000102941 ul | 0.0000462577 ul
3rd Principal Strain | -0.000114538 ul | -0.00000000112399 ul
Strain XX | -0.0000376753 ul | 0.0000457195 ul
Strain XY | -0.0000678021 ul | 0.0000309539 ul
Strain XZ | -0.0000225941 ul | 0.0000228106 ul
Strain YY | -0.0000878415 ul | 0.00001703 ul
Strain YZ | -0.0000451185 ul | 0.0000537849 ul
Strain ZZ | -0.0000140385 ul | 0.0000194322 ul

####  Figures

#####  Von Mises Stress

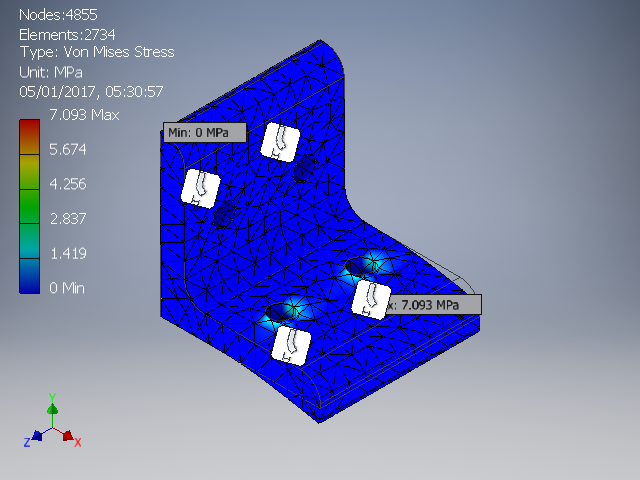
[picture p166: modelsali/Models2/Stress/Images/L_Fixer2 Stress Analysis Report 05_01_2017/0/Result_0_1.png]


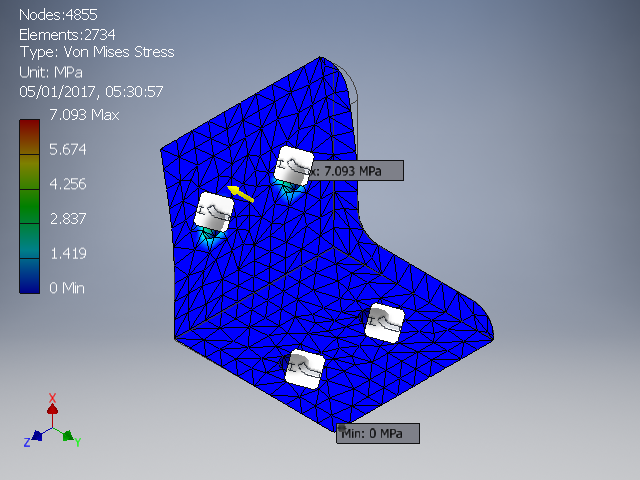
[picture p167: modelsali/Models2/Stress/Images/L_Fixer2 Stress Analysis Report 05_01_2017/0/Result_0_1_rev.png]


#####  1st Principal Stress

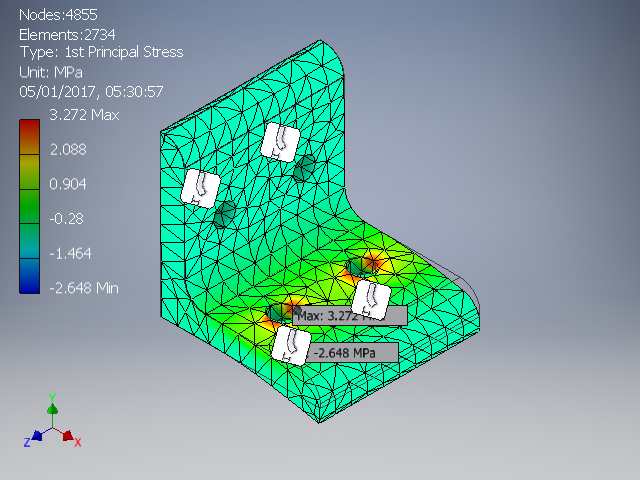
[picture p168: modelsali/Models2/Stress/Images/L_Fixer2 Stress Analysis Report 05_01_2017/0/Result_0_6.png]


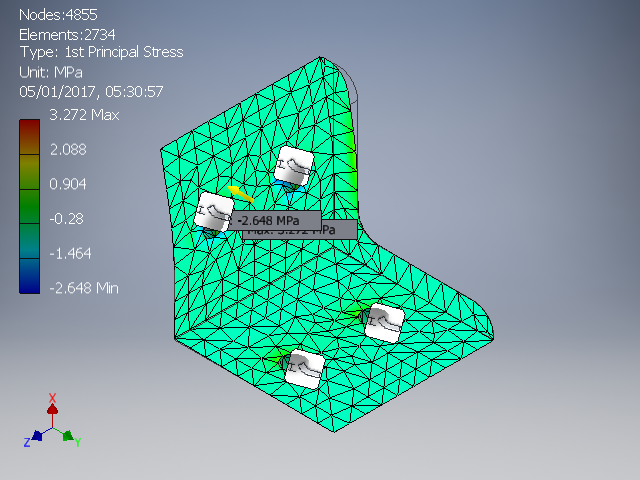
[picture p169: modelsali/Models2/Stress/Images/L_Fixer2 Stress Analysis Report 05_01_2017/0/Result_0_6_rev.png]


#####  3rd Principal Stress

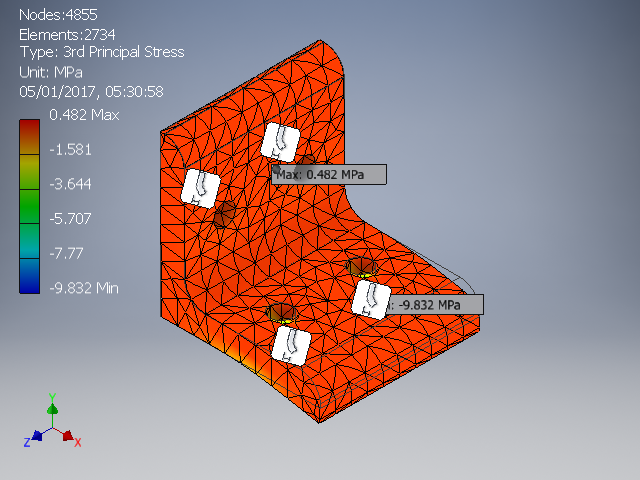
[picture p170: modelsali/Models2/Stress/Images/L_Fixer2 Stress Analysis Report 05_01_2017/0/Result_0_8.png]


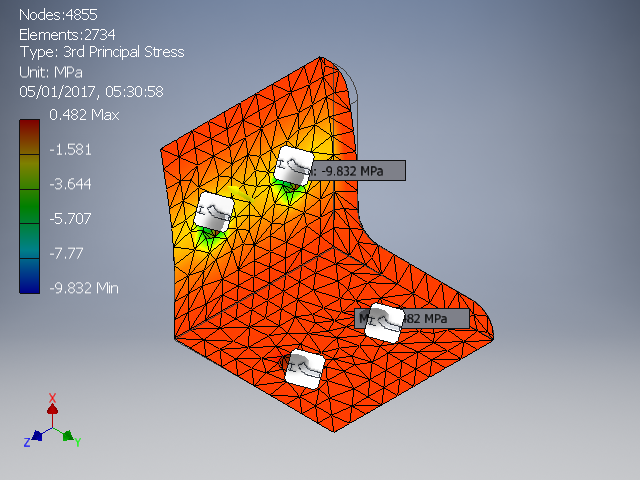
[picture p171: modelsali/Models2/Stress/Images/L_Fixer2 Stress Analysis Report 05_01_2017/0/Result_0_8_rev.png]


#####  Displacement

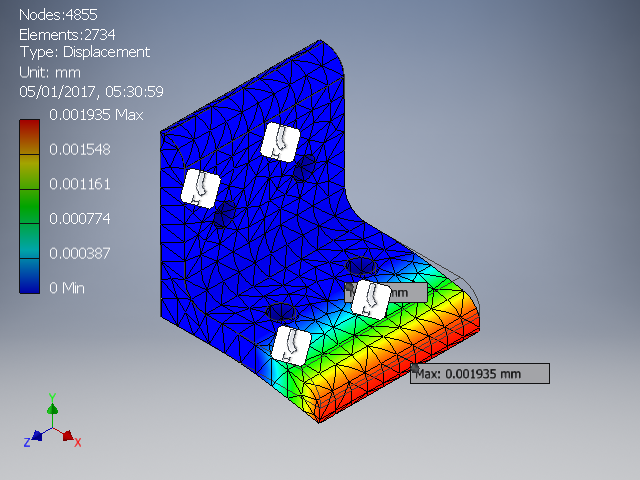
[picture p172: modelsali/Models2/Stress/Images/L_Fixer2 Stress Analysis Report 05_01_2017/0/Result_0_2.png]


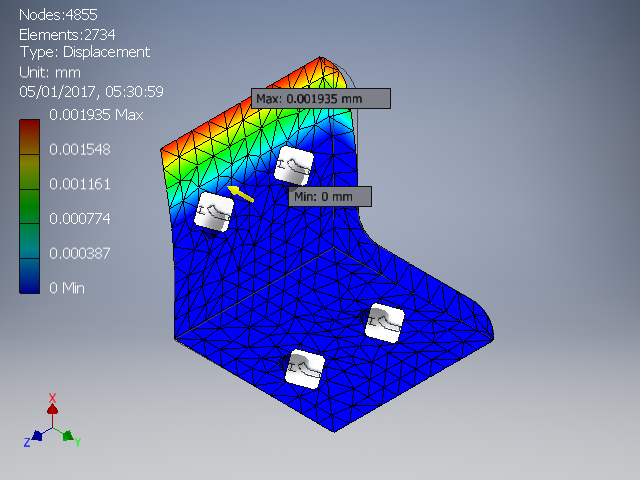
[picture p173: modelsali/Models2/Stress/Images/L_Fixer2 Stress Analysis Report 05_01_2017/0/Result_0_2_rev.png]


#####  Safety Factor

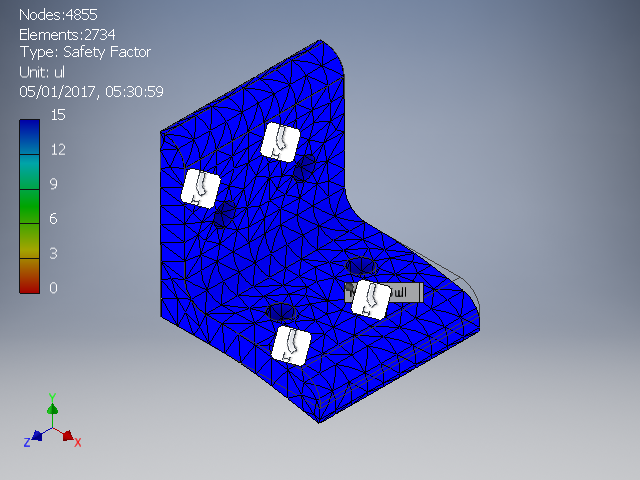
[picture p174: modelsali/Models2/Stress/Images/L_Fixer2 Stress Analysis Report 05_01_2017/0/Result_0_57.png]


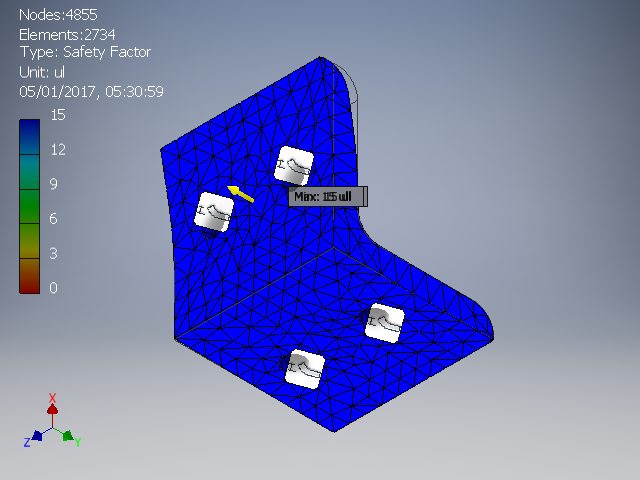
[picture p175: modelsali/Models2/Stress/Images/L_Fixer2 Stress Analysis Report 05_01_2017/0/Result_0_57_rev.png]


#####  Stress XX

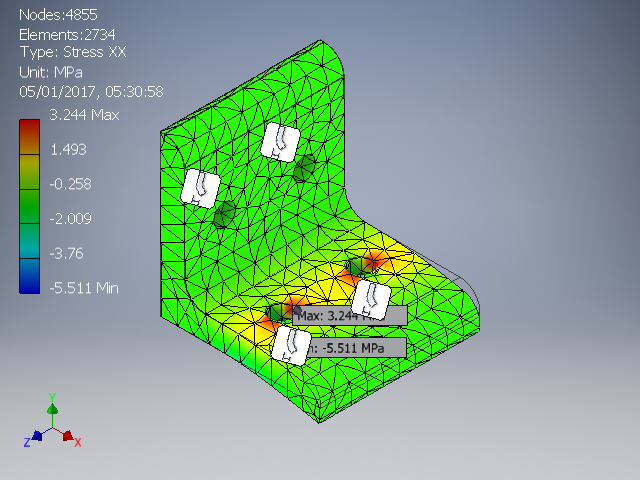
[picture p176: modelsali/Models2/Stress/Images/L_Fixer2 Stress Analysis Report 05_01_2017/0/Result_0_9.png]


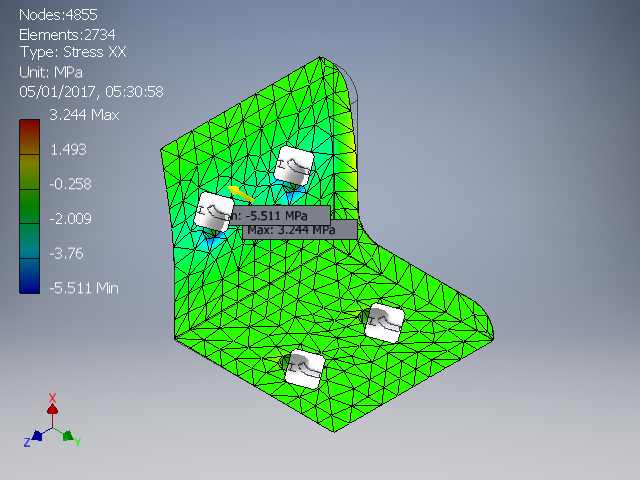
[picture p177: modelsali/Models2/Stress/Images/L_Fixer2 Stress Analysis Report 05_01_2017/0/Result_0_9_rev.png]


#####  Stress XY

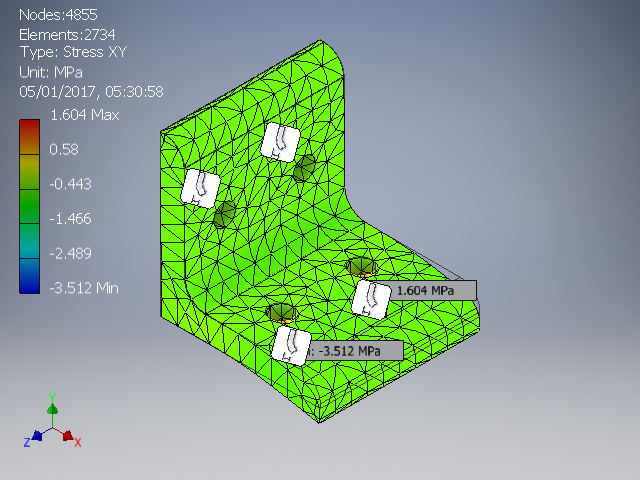
[picture p178: modelsali/Models2/Stress/Images/L_Fixer2 Stress Analysis Report 05_01_2017/0/Result_0_10.png]


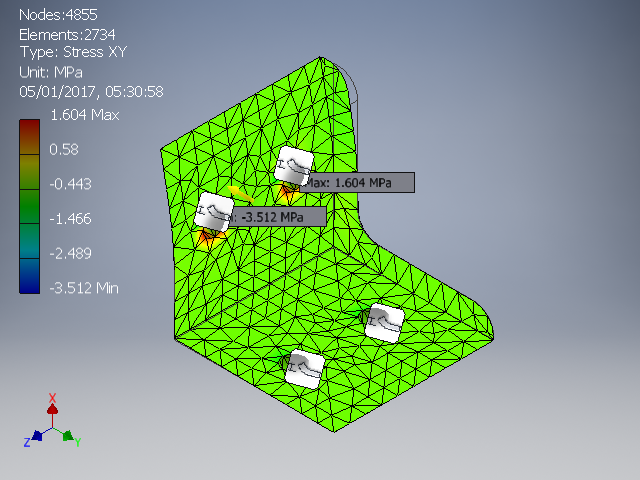
[picture p179: modelsali/Models2/Stress/Images/L_Fixer2 Stress Analysis Report 05_01_2017/0/Result_0_10_rev.png]


#####  Stress XZ

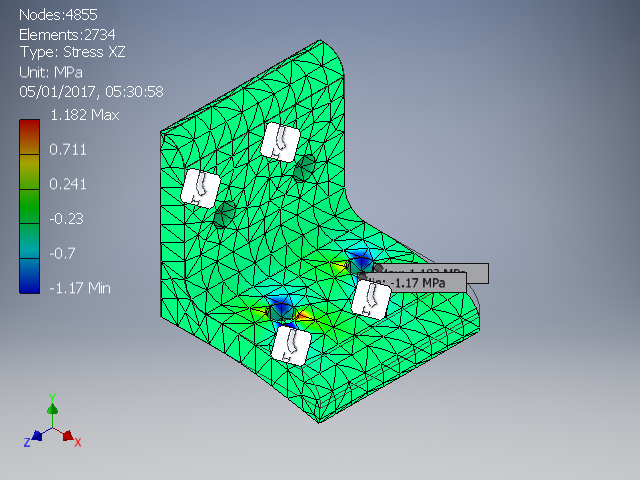
[picture p180: modelsali/Models2/Stress/Images/L_Fixer2 Stress Analysis Report 05_01_2017/0/Result_0_11.png]


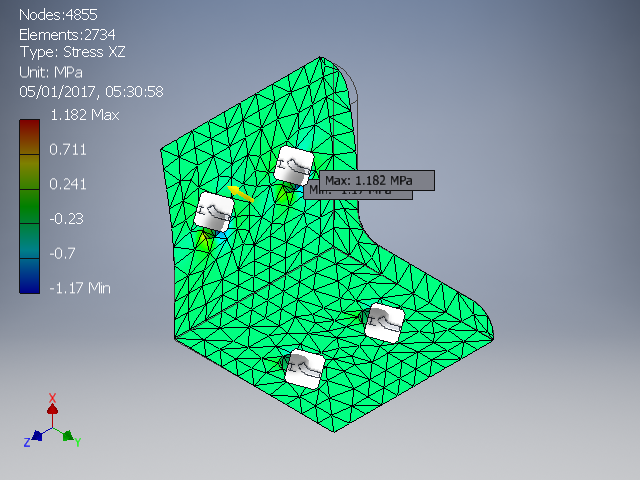
[picture p181: modelsali/Models2/Stress/Images/L_Fixer2 Stress Analysis Report 05_01_2017/0/Result_0_11_rev.png]


#####  Stress YY

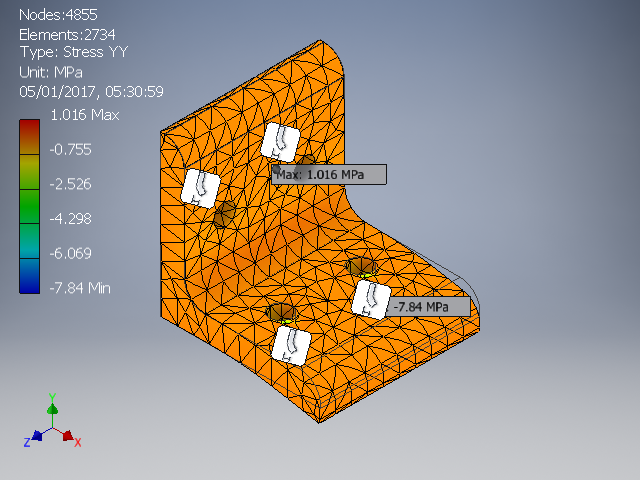
[picture p182: modelsali/Models2/Stress/Images/L_Fixer2 Stress Analysis Report 05_01_2017/0/Result_0_12.png]


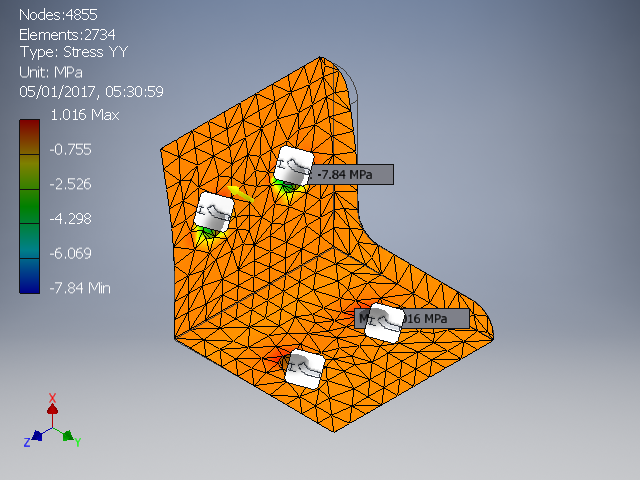
[picture p183: modelsali/Models2/Stress/Images/L_Fixer2 Stress Analysis Report 05_01_2017/0/Result_0_12_rev.png]


#####  Stress YZ

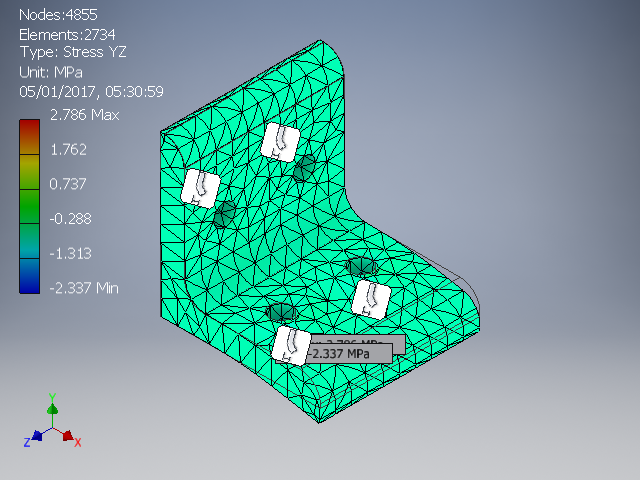
[picture p184: modelsali/Models2/Stress/Images/L_Fixer2 Stress Analysis Report 05_01_2017/0/Result_0_13.png]


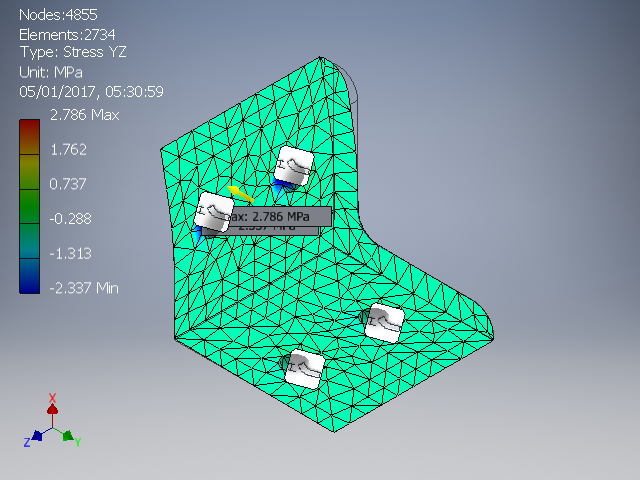
[picture p185: modelsali/Models2/Stress/Images/L_Fixer2 Stress Analysis Report 05_01_2017/0/Result_0_13_rev.png]


#####  Stress ZZ

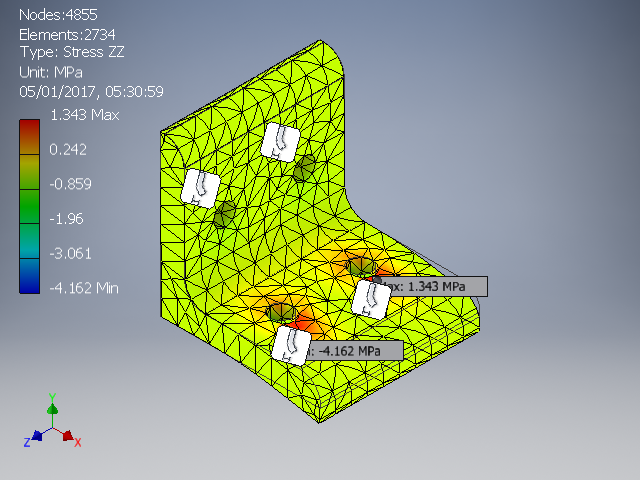
[picture p186: modelsali/Models2/Stress/Images/L_Fixer2 Stress Analysis Report 05_01_2017/0/Result_0_14.png]


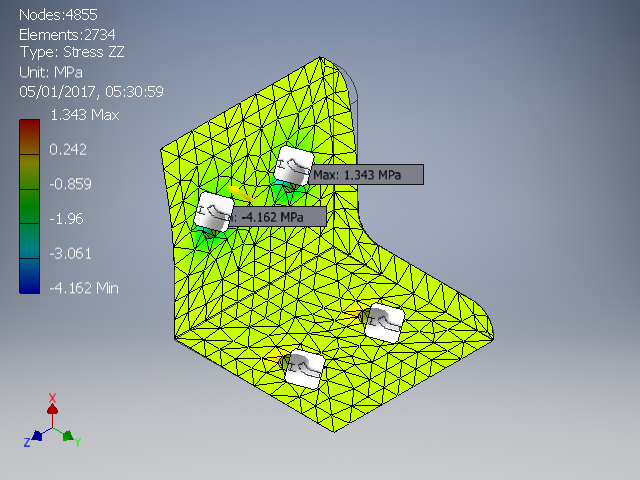
[picture p187: modelsali/Models2/Stress/Images/L_Fixer2 Stress Analysis Report 05_01_2017/0/Result_0_14_rev.png]


#####  X Displacement

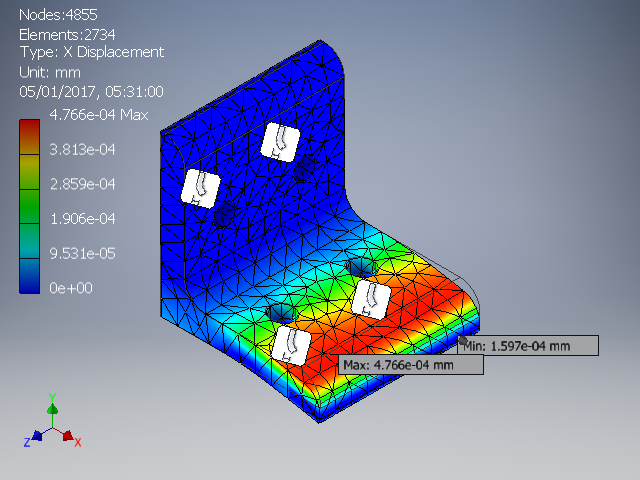
[picture p188: modelsali/Models2/Stress/Images/L_Fixer2 Stress Analysis Report 05_01_2017/0/Result_0_3.png]


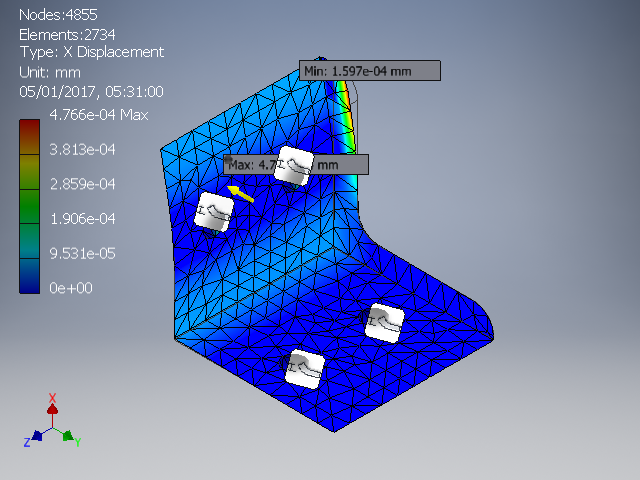
[picture p189: modelsali/Models2/Stress/Images/L_Fixer2 Stress Analysis Report 05_01_2017/0/Result_0_3_rev.png]


#####  Y Displacement

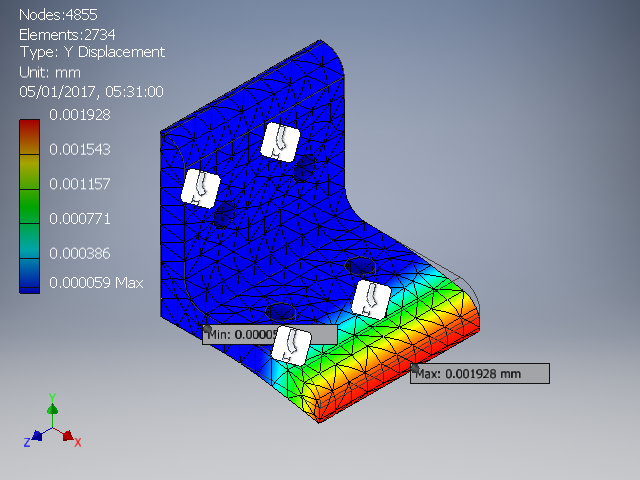
[picture p190: modelsali/Models2/Stress/Images/L_Fixer2 Stress Analysis Report 05_01_2017/0/Result_0_4.png]


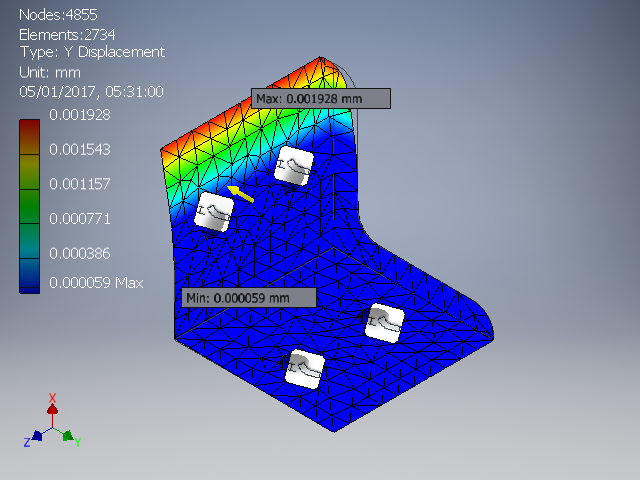
[picture p191: modelsali/Models2/Stress/Images/L_Fixer2 Stress Analysis Report 05_01_2017/0/Result_0_4_rev.png]


#####  Z Displacement

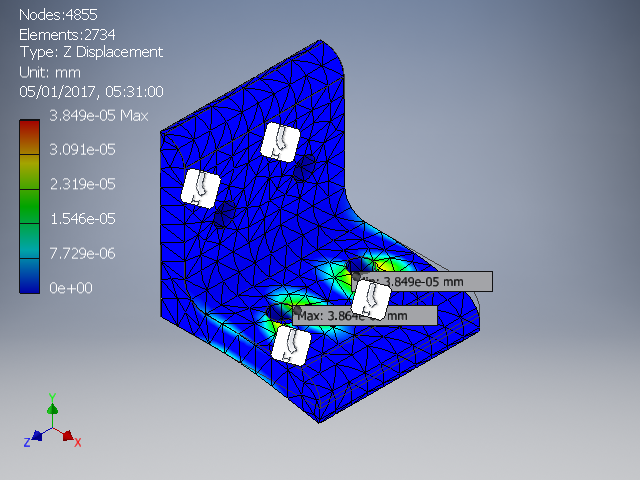
[picture p192: modelsali/Models2/Stress/Images/L_Fixer2 Stress Analysis Report 05_01_2017/0/Result_0_5.png]


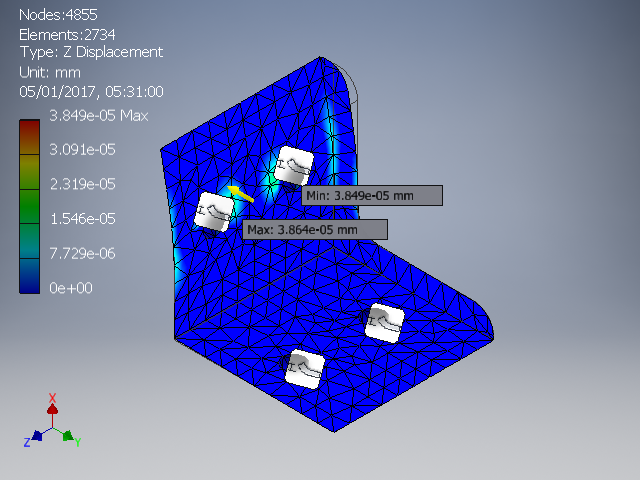
[picture p193: modelsali/Models2/Stress/Images/L_Fixer2 Stress Analysis Report 05_01_2017/0/Result_0_5_rev.png]


#####  Equivalent Strain

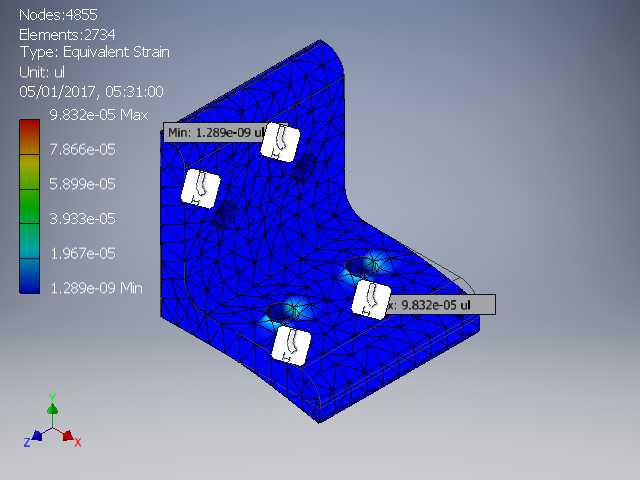
[picture p194: modelsali/Models2/Stress/Images/L_Fixer2 Stress Analysis Report 05_01_2017/0/Result_0_80.png]


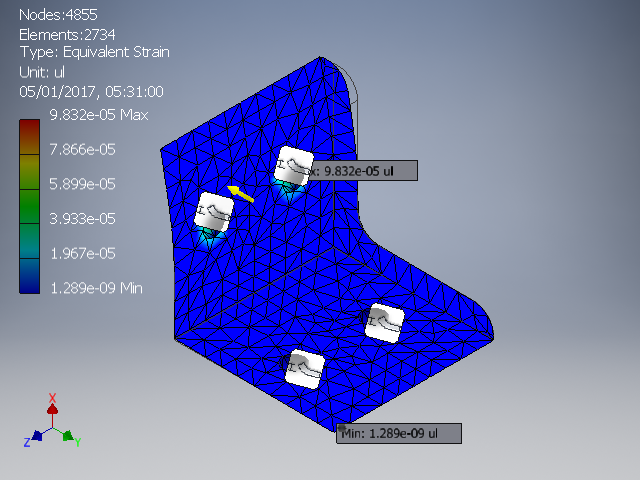
[picture p195: modelsali/Models2/Stress/Images/L_Fixer2 Stress Analysis Report 05_01_2017/0/Result_0_80_rev.png]


#####  1st Principal Strain

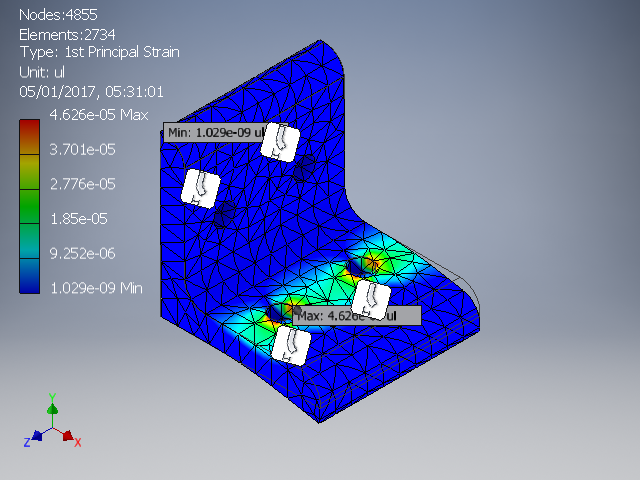
[picture p196: modelsali/Models2/Stress/Images/L_Fixer2 Stress Analysis Report 05_01_2017/0/Result_0_81.png]


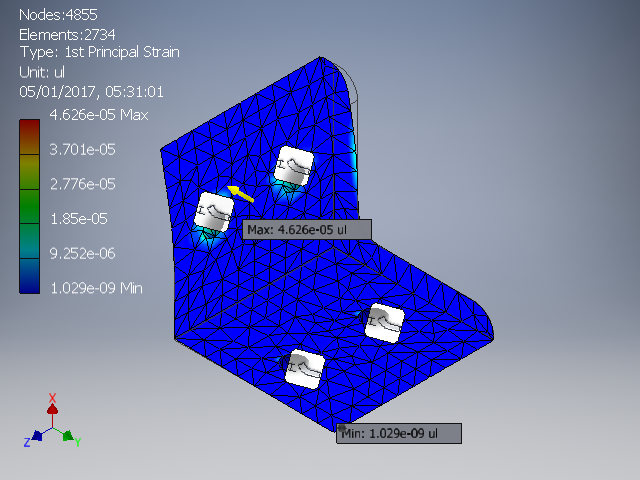
[picture p197: modelsali/Models2/Stress/Images/L_Fixer2 Stress Analysis Report 05_01_2017/0/Result_0_81_rev.png]


#####  3rd Principal Strain

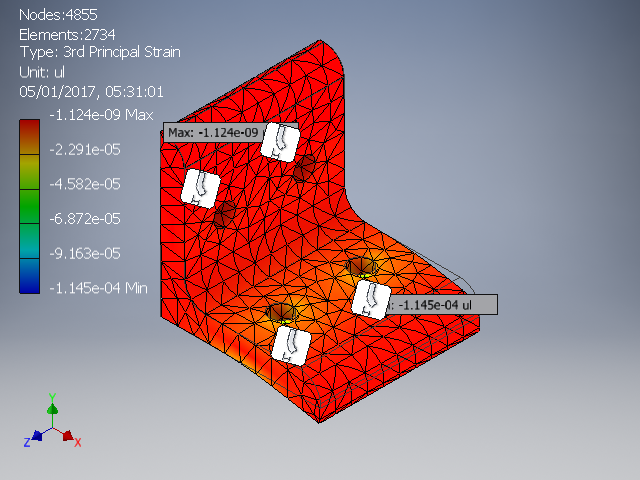
[picture p198: modelsali/Models2/Stress/Images/L_Fixer2 Stress Analysis Report 05_01_2017/0/Result_0_83.png]


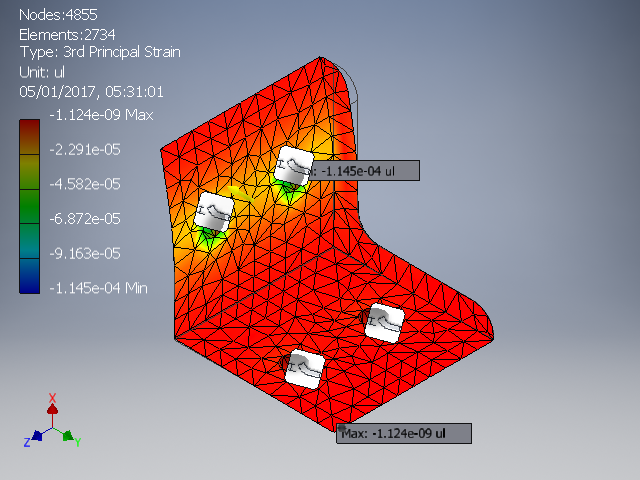
[picture p199: modelsali/Models2/Stress/Images/L_Fixer2 Stress Analysis Report 05_01_2017/0/Result_0_83_rev.png]


#####  Strain XX

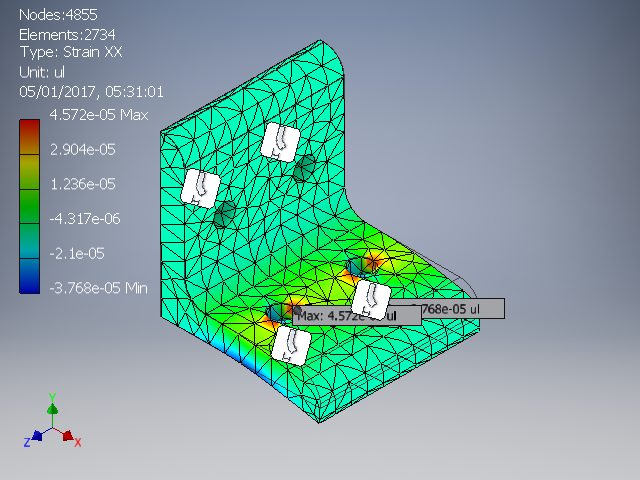
[picture p200: modelsali/Models2/Stress/Images/L_Fixer2 Stress Analysis Report 05_01_2017/0/Result_0_58.png]


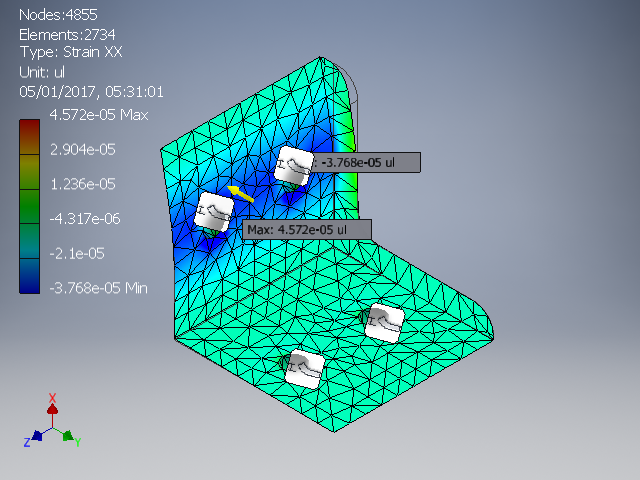
[picture p201: modelsali/Models2/Stress/Images/L_Fixer2 Stress Analysis Report 05_01_2017/0/Result_0_58_rev.png]


#####  Strain XY

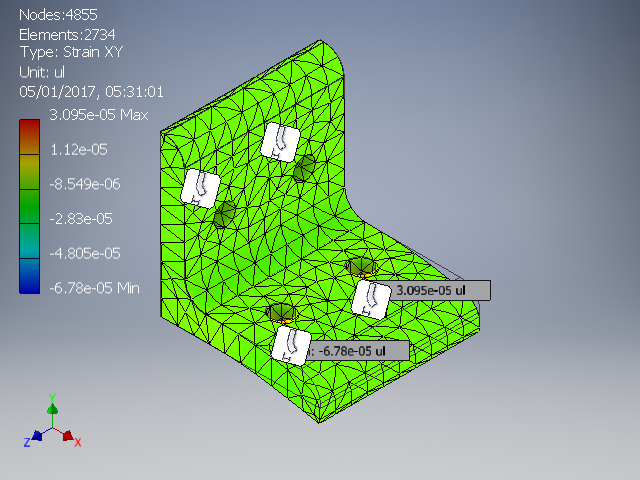
[picture p202: modelsali/Models2/Stress/Images/L_Fixer2 Stress Analysis Report 05_01_2017/0/Result_0_59.png]


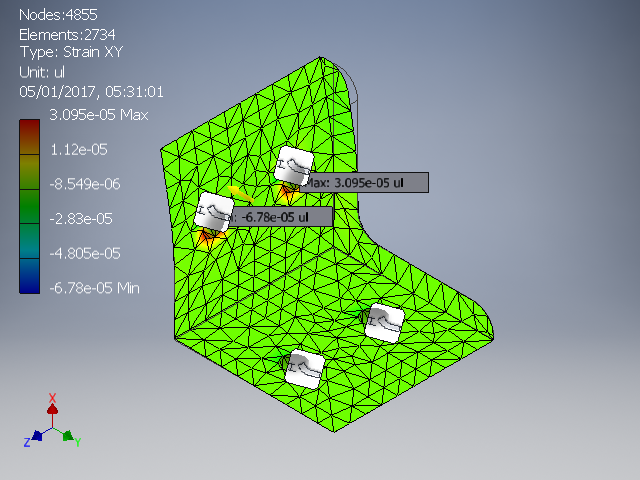
[picture p203: modelsali/Models2/Stress/Images/L_Fixer2 Stress Analysis Report 05_01_2017/0/Result_0_59_rev.png]


#####  Strain XZ

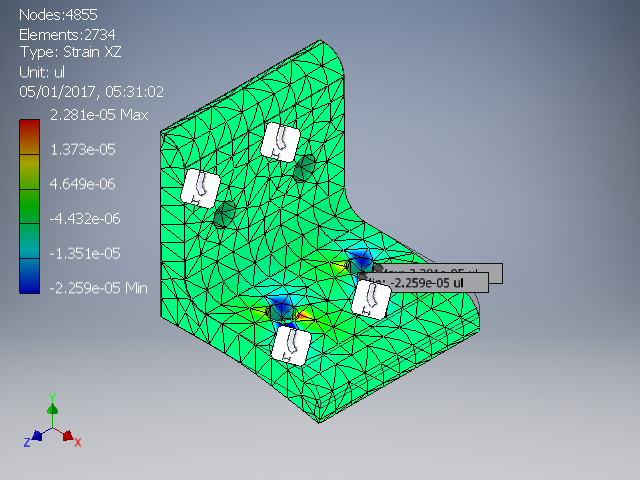
[picture p204: modelsali/Models2/Stress/Images/L_Fixer2 Stress Analysis Report 05_01_2017/0/Result_0_60.png]


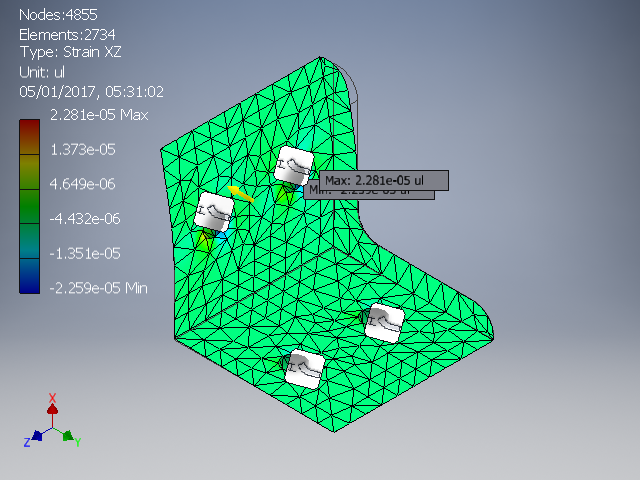
[picture p205: modelsali/Models2/Stress/Images/L_Fixer2 Stress Analysis Report 05_01_2017/0/Result_0_60_rev.png]


#####  Strain YY

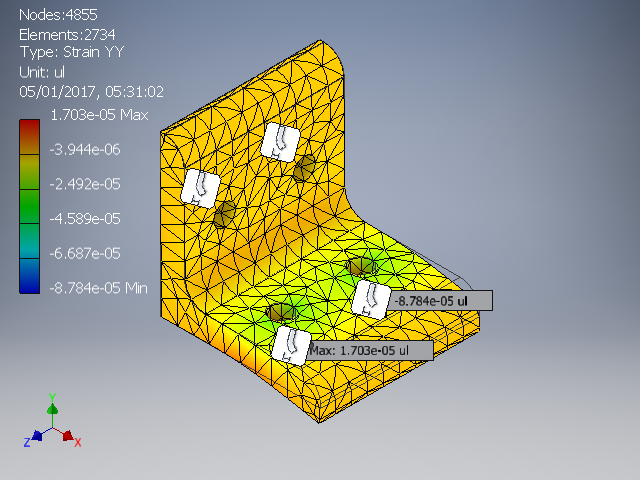
[picture p206: modelsali/Models2/Stress/Images/L_Fixer2 Stress Analysis Report 05_01_2017/0/Result_0_61.png]


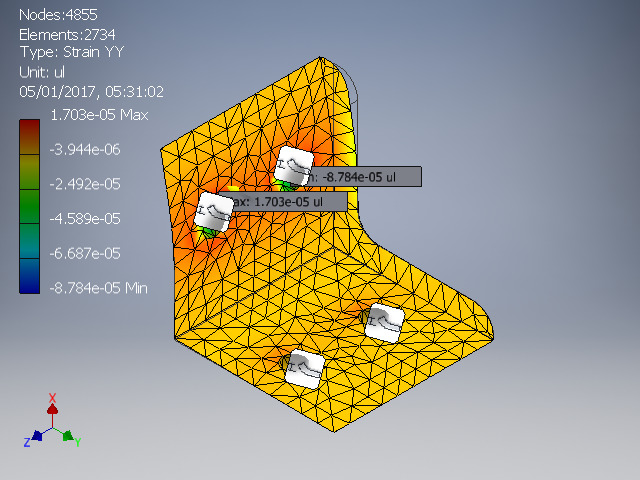
[picture p207: modelsali/Models2/Stress/Images/L_Fixer2 Stress Analysis Report 05_01_2017/0/Result_0_61_rev.png]


#####  Strain YZ

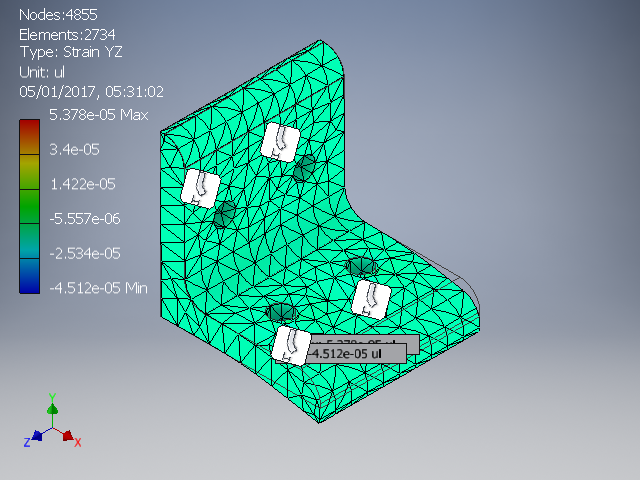
[picture p208: modelsali/Models2/Stress/Images/L_Fixer2 Stress Analysis Report 05_01_2017/0/Result_0_62.png]


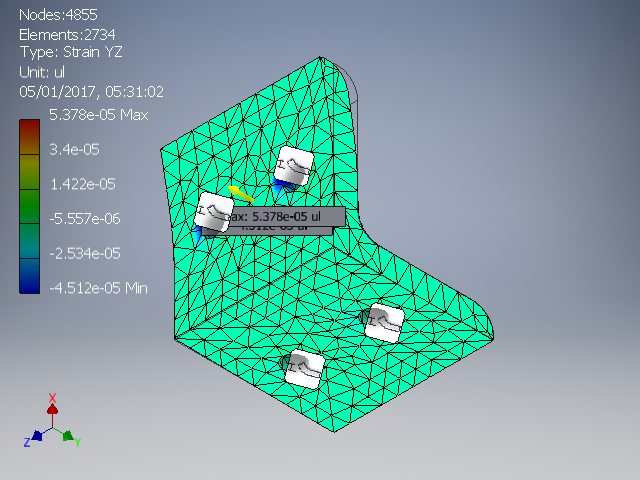
[picture p209: modelsali/Models2/Stress/Images/L_Fixer2 Stress Analysis Report 05_01_2017/0/Result_0_62_rev.png]


#####  Strain ZZ

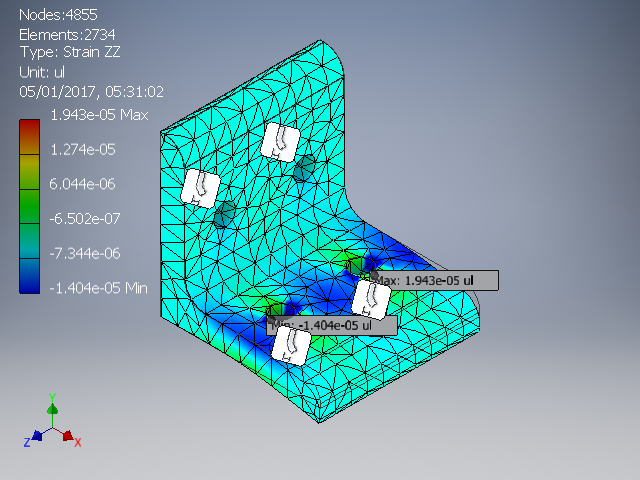
[picture p210: modelsali/Models2/Stress/Images/L_Fixer2 Stress Analysis Report 05_01_2017/0/Result_0_63.png]


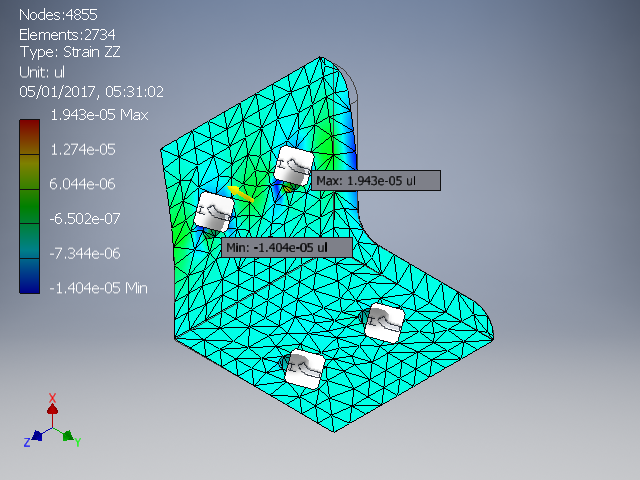
[picture p211: modelsali/Models2/Stress/Images/L_Fixer2 Stress Analysis Report 05_01_2017/0/Result_0_63_rev.png]


C:\Users\Ali\Desktop\roboticFarm-master\Models2\Gantry\L_Fixer2.ipt

Image Width (pixels):
