umurcg/roboticFarm/final pres.pptx

## Universal Tool Mount

Tools
- Watering Tool
- Weeder Assembly
- Seeder
- Soil Sensor
- Custom Tool Possibility

Working Principle
- Magnet Rings
- Conductive screws

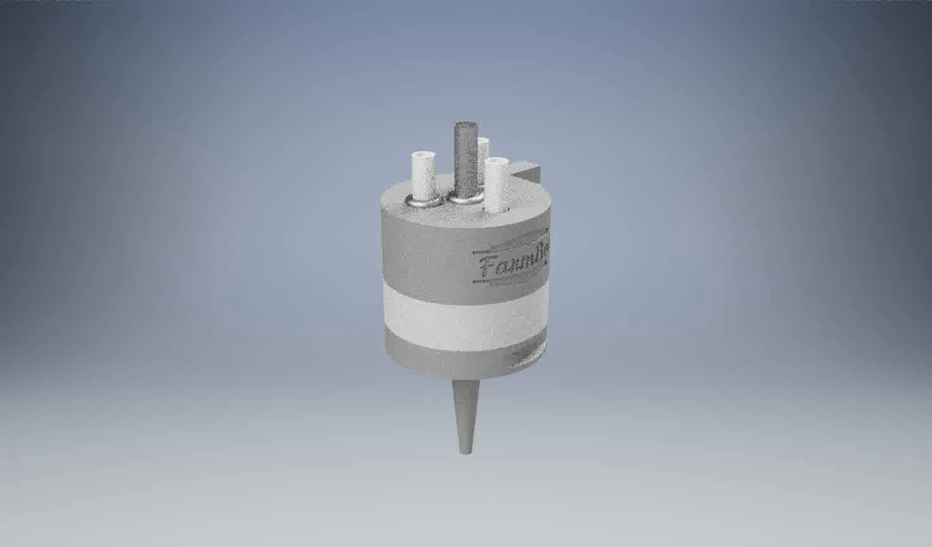
[picture p212: figure]

## Movement of UTM

## Objectives

- Mechanical movement system with working software interface.
- Water and vacuum system integration
- Led system integration
