umurcg/roboticFarm/Notlar.docx

Toprak derinliği

60 cm (En büyük sorun havuç. O da en fazla 60 cm toprak istiyor.)

Bitkiler

| Sowing Time | Planting Time | Cutting/Lifting Time
Brokoli | Apr-May | Jun-Jul | Aug-Oct
Havuç | Mar-Jul | - | Jun-Dec
Lahana – Summer Cabbage | Mar-May | May-Jul | Jun-Oct
Marul - Lettuce | Mar-June | - | Jun-Oct

Ref

The vegetable expert- - Dr.D.G. Hessayon

Exhaust Fan

GROW SPACE SIZE | WATTAGE OF LIGHT | CFM OF FAN*
0.6 x 1.2 x 1.5 | 250W | 80-120 CFM
1 x 1 x 2 | 600W | 160 - 238 CFM
1.2 x 1.2 x 2.1 | 1,000W | 224 - 336 CFM

SUNON DP200A 117 CFM – 17 TL

Led

2 m² – 1200W

Full Spectrum

Ampül şeklinde 4 parça Full spectrum (10W) – 10.20$

Shallow Rooting 12" - 18" | Medium Rooting 18" - 24" | Deep Rooting 24" - 36"+
Arugula | Beans, dry | Artichokes
Broccoli | Beans, pole | Asparagus
Brussels sprouts | Beans, snap | Beans, lima
Cabbage | Beets | Okra
Cauliflower | Canteloupe | Parsnips
Celery | Carrots | Pumpkins
Chinese cabbage | Chard | Rhubarb
Corn | Cucumber | Squash, winter
Endive | Eggplant | Sweet potatoes
Garlic | Kale | Tomatoes
Kohlrabi, Bok Choy | Peas | Watermelon
Lettuce | Peppers
Onions, Leeks, Chives | Rutabagas
Potatoes | Squash, summer
Radishes | Turnips
Spinach
Strawberries

http://eartheasy.com/raised-beds-soil-depth-requirements.html
