umurcg/roboticFarm/800px-ScrewRap_overview.jpg

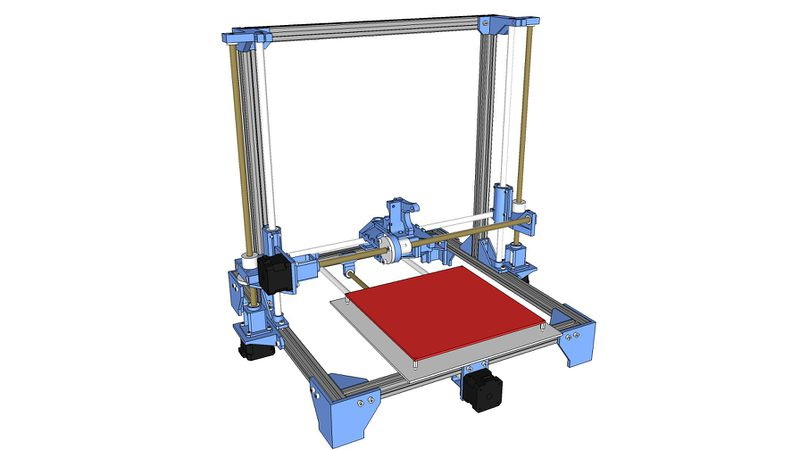
800px-ScrewRap_overview.jpg
