umurcg/roboticFarm/Models2/LED Tube/54leds.JPG

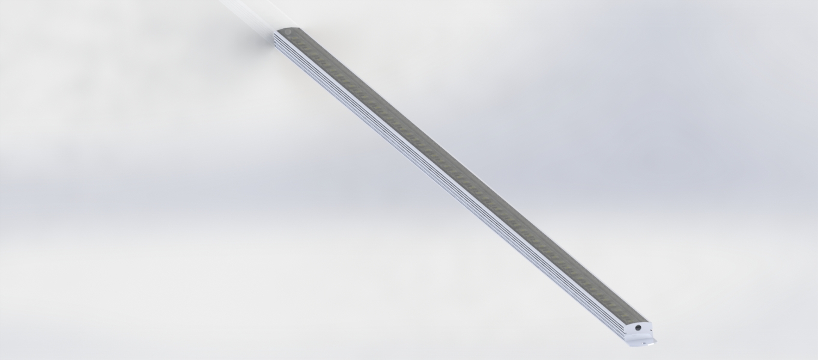
Models2/LED Tube/54leds.JPG
