umurcg/roboticFarm/Models2/LED Tube/frontal.JPG

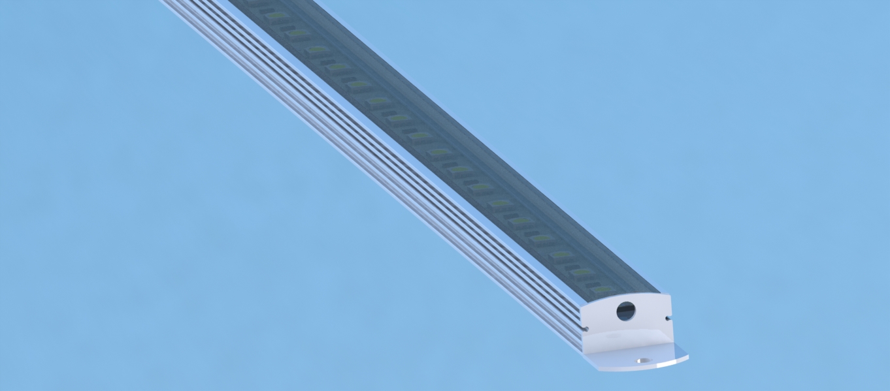
Models2/LED Tube/frontal.JPG
