umurcg/roboticFarm/Models2/LED Tube/sintapa.JPG

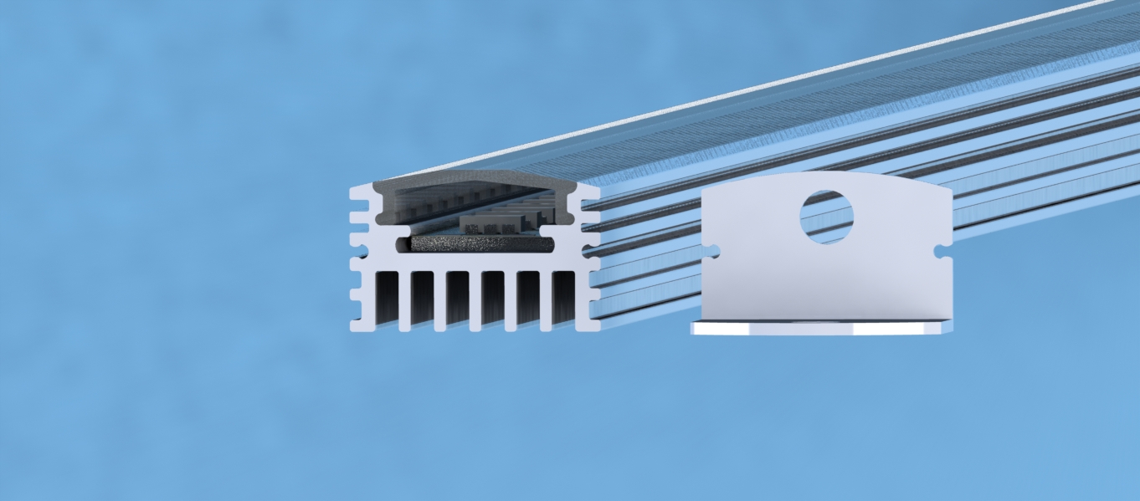
Models2/LED Tube/sintapa.JPG
