umurcg/roboticFarm/Models2/Tools.bmp

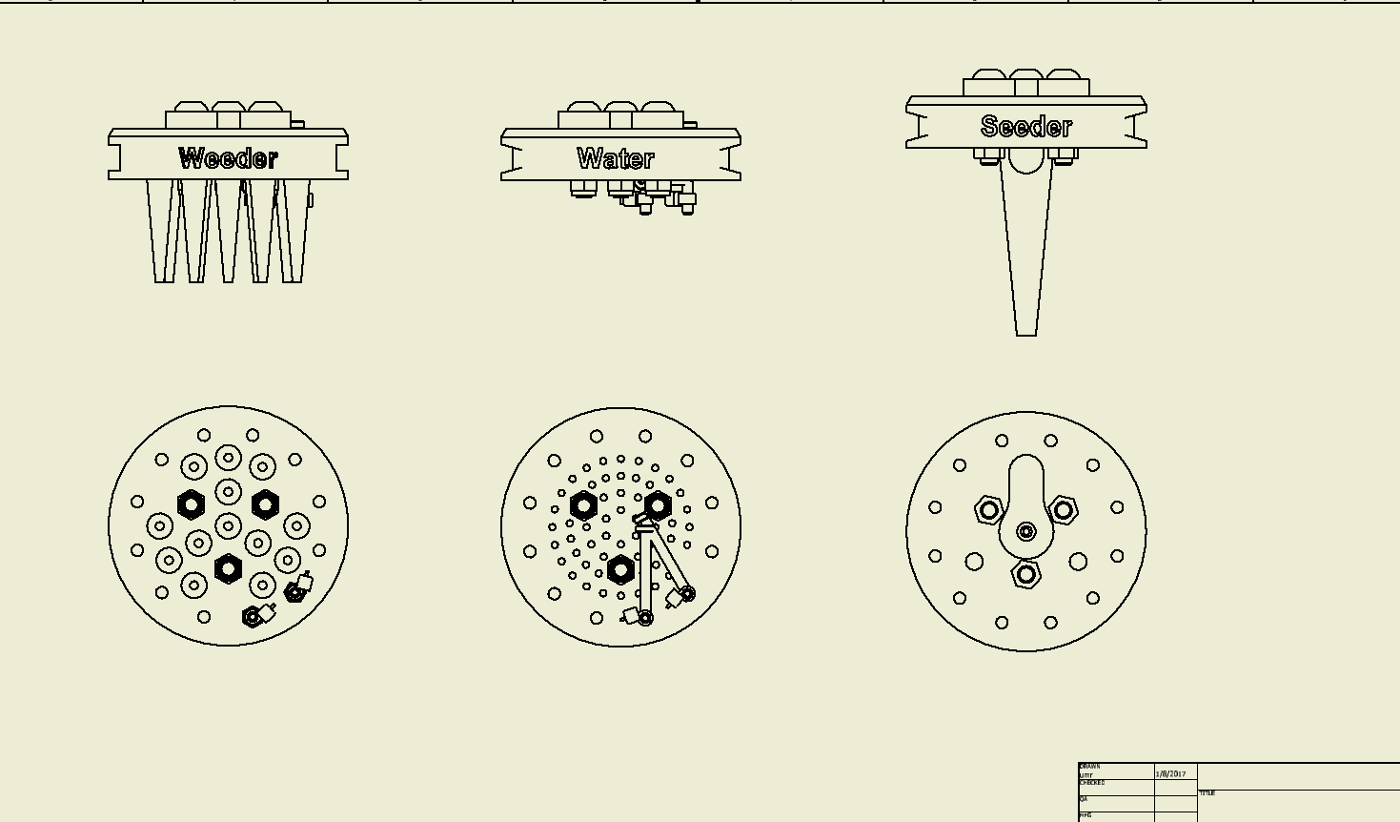
Models2/Tools.bmp
