umurcg/roboticFarm/Pic/FoodPriceStatistics2.JPG

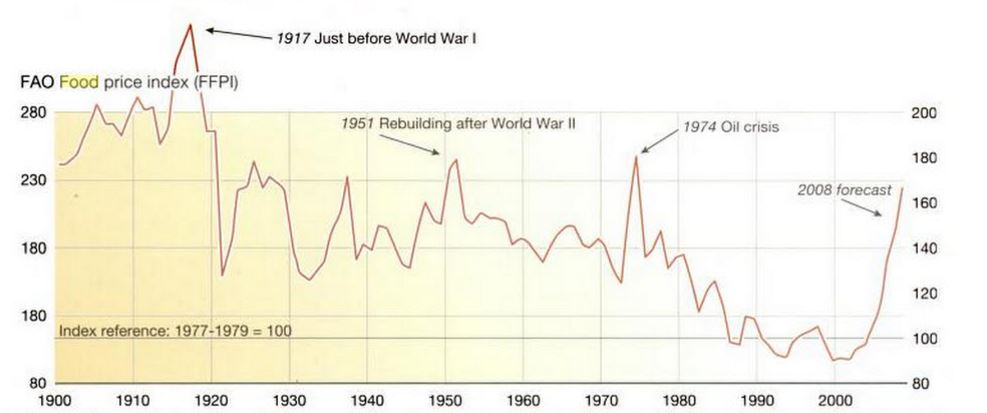
Pic/FoodPriceStatistics2.JPG
