umurcg/roboticFarm/Pic/FoodPriceStatistics.JPG

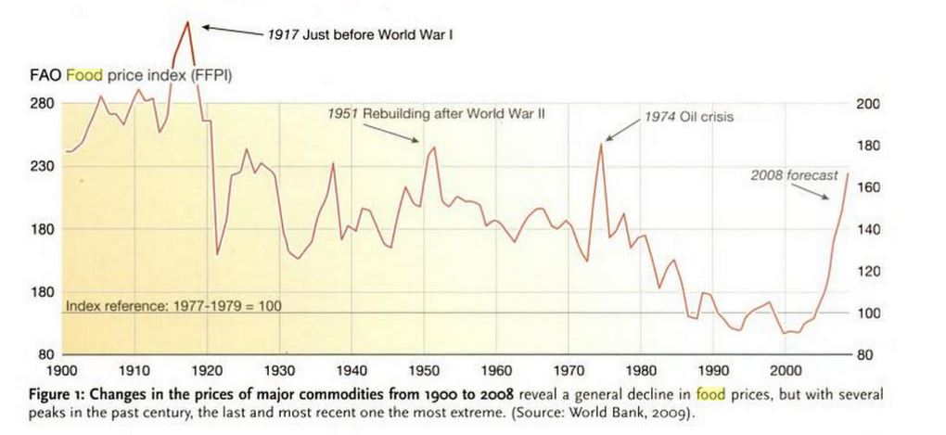
Pic/FoodPriceStatistics.JPG
