umurcg/roboticFarm/Pic/PopulationGrowth.JPG

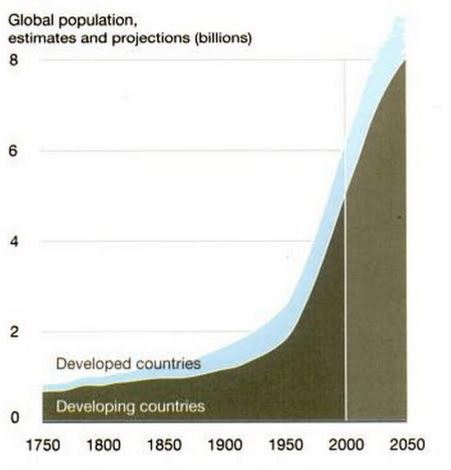
Pic/PopulationGrowth.JPG
