umurcg/roboticFarm/Resources/Grasping in Robotics - Springer_files/000.png

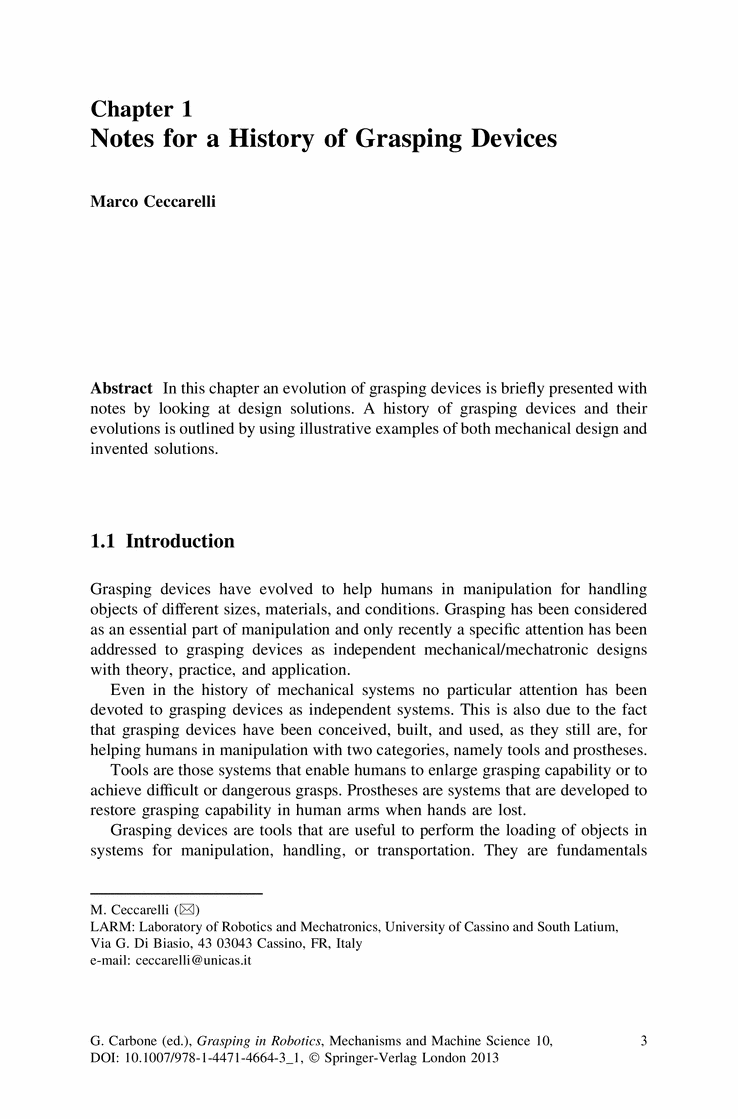
Resources/Grasping in Robotics - Springer_files/000.png
