umurcg/roboticFarm/Resources/Grasping in Robotics - Springer_files/978-1-4471-4664-3.jpg

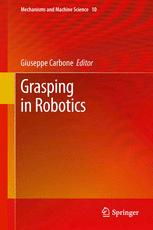
Resources/Grasping in Robotics - Springer_files/978-1-4471-4664-3.jpg
