umurcg/roboticFarm/Resources/Robotics _ Free Full-Text _ Towards an Open Software Platform for Field Robots in Precision Agriculture _ HTML_files/ESCI.png

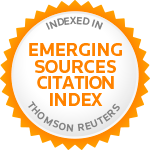
Resources/Robotics _ Free Full-Text _ Towards an Open Software Platform for Field Robots in Precision Agriculture _ HTML_files/ESCI.png
