umurcg/roboticFarm/Resources/Robotics _ Free Full-Text _ Towards an Open Software Platform for Field Robots in Precision Agriculture _ HTML_files/robotics-03-00207-g001-1024.png

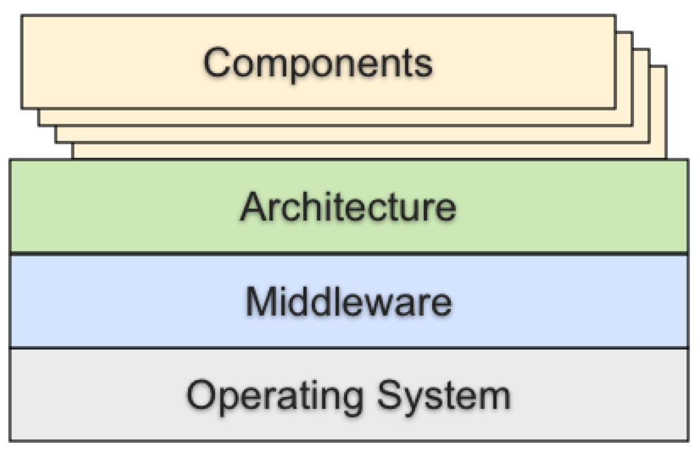
Resources/Robotics _ Free Full-Text _ Towards an Open Software Platform for Field Robots in Precision Agriculture _ HTML_files/robotics-03-00207-g001-1024.png
