umurcg/roboticFarm/Resources/Robots in agriculture - YouTube_files/featured_channel.jpg

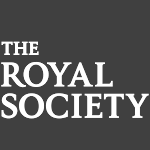
Resources/Robots in agriculture - YouTube_files/featured_channel.jpg
