umurcg/roboticFarm/Resources/Robots in agriculture - YouTube_files/hqdefault(1).jpg

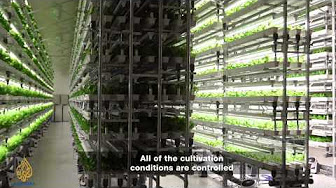
Resources/Robots in agriculture - YouTube_files/hqdefault(1).jpg
