umurcg/roboticFarm/Resources/Robots in agriculture - YouTube_files/hqdefault(2).jpg

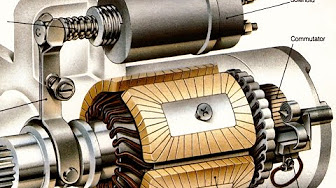
Resources/Robots in agriculture - YouTube_files/hqdefault(2).jpg
