umurcg/roboticFarm/Resources/Robots in agriculture - YouTube_files/hqdefault(3).jpg

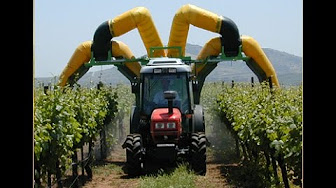
Resources/Robots in agriculture - YouTube_files/hqdefault(3).jpg
