umurcg/roboticFarm/Resources/Robots in agriculture - YouTube_files/hqdefault(4).jpg

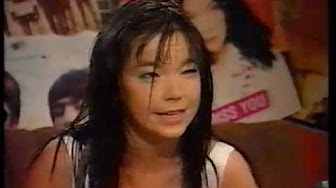
Resources/Robots in agriculture - YouTube_files/hqdefault(4).jpg
