umurcg/roboticFarm/Resources/Robots in agriculture - YouTube_files/hqdefault(5).jpg

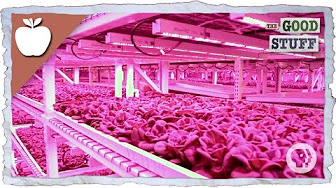
Resources/Robots in agriculture - YouTube_files/hqdefault(5).jpg
