umurcg/roboticFarm/Resources/Robots in agriculture - YouTube_files/hqdefault(6).jpg

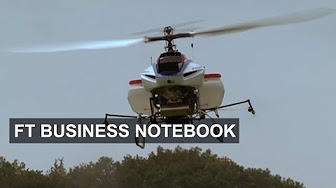
Resources/Robots in agriculture - YouTube_files/hqdefault(6).jpg
