umurcg/roboticFarm/Resources/Robots in agriculture - YouTube_files/hqdefault(7).jpg

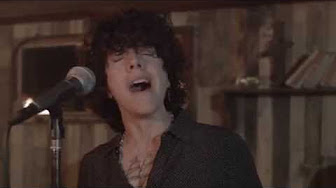
Resources/Robots in agriculture - YouTube_files/hqdefault(7).jpg
