umurcg/roboticFarm/Resources/Robots in agriculture - YouTube_files/hqdefault.jpg

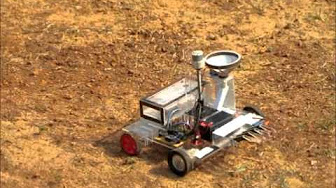
Resources/Robots in agriculture - YouTube_files/hqdefault.jpg
