umurcg/roboticFarm/Things to Buy new.xlsx

Aluminum Foam
Farmbot Doc Name | Name | Specs. | Description | Image | Where to buy | Quantity | Price Per Unit (TL) - VAT Included | SubTotal
Extrusions
Track Extrusions | Aluminum Sigma Profile | 20 x 40 x 2420 mm | Track extrusions are the primary structural component of the tracks sub-assembly. They can be combined end-to-end in order to create longer tracks. The gantry v-wheels roll along the track extrusions, allowing FarmBot to move in the x-direction. | https://files.readme.io/SslZOK4lTJSp3DjzzcvN_20150113_140302.jpg | Doğuş Kalıp | 2 | 53.406738 | 106.813476
Gantry Columns |  | 20 x 60 x 700mm | The gantry columns are made from aluminum extrusions. They can be scaled to be taller or shorter to satisfy your needs. The two large spaces inside the columns are used to conceal and protect the GT2 timing belts that run along the tracks and up to the gantry pulleys. | https://files.readme.io/0ac9eh6eRWnHpUhpK6xQ_IMG_1938.JPG | Doğuş Kalıp | 2 | 17.542 | 35.084
Gantry Main Beam |  | 20 x 60 x 1380mm | This aluminum extrusion serves as the gantry's primary structural element. The cross-slide's v-wheels move across this extrusion, allowing FarmBot to move in the y-direction. It is possible to make this extrusion longer or shorter to suit your needs. | https://files.readme.io/dTUrgZKIR021wPUWyvJC_IMG_1975.JPG | Doğuş Kalıp | 1 | 8.3076 | 8.3076
Z-Axis Extrusion |  | 20 x 40 x 370mm |  | https://files.readme.io/ltg1khxeRkydftw36iBC_IMG_20160316_143818.jpg | Doğuş Kalıp | 1 | 8.165493 | 8.165493
Fasteners and Hardware (Tekman Civata temsili)
M3 x 10mm Screws | M3 Low-Profile Socket Head Cap Screw | 3 x 10mm |  | https://files.readme.io/dDekUaWKRY28Z96vo7W6_M3%20Screw.JPG | Tekman Civata | 14 | 0.0867 | 1.2138
M3 x 20mm Screws |  | 3 x 20mm |  | https://files.readme.io/dDekUaWKRY28Z96vo7W6_M3%20Screw.JPG | Tekman Civata | 4 | 0.012 | 0.048
M3 x 40mm Screws |  | 3 x 40mm |  | https://files.readme.io/dDekUaWKRY28Z96vo7W6_M3%20Screw.JPG | Tekman Civata | 12 | 0.02631 | 0.31572
M3 x 5mm Setscrews | Knurl Grip Cup Point Set Screw | 3 x 5mm | Two of these setscrews are used to secure each GT2 pulley to the motor's shaft. The cup edge is knurled for gripping strength so these screws resist loosening. | https://files.readme.io/e3bStBXTSDePBQiQazRg_Knurl-Grip%20Cup%20Point%20Set%20Screw.JPG | Tekman Civata | 6 | 0.022 | 0.132
M3 Locknuts | Nylon-Insert Locknut | M3 | Twelve of these locknuts are used to secure the UTM electronic pin screws in place. The nylon insert allows them to resist loosening when subjected to vibration. | https://files.readme.io/UsrNocOcSaCHA945ZQUE_M3%20Lokcnut.JPG | Tekman Civata | 24 | 0.0442 | 1.0608
M5 x 10mm Screws | Button-Head Socket Cap Screw | 5 x 10mm | M5 button-head screws of various lengths are used throughout FarmBot to attach plates and 3D printed parts to extrusions, V-wheels to plates, and other components together. They are usually used in combination with M5 washers, and terminated with an M5 tee nut or locknut. The button head provides a wide bearing surface, a low-profile head, and a finished appearance. Length is measured from under the head. | https://files.readme.io/hnXMDG6lQc2V7g08yTKu_M5%20x%2010mm%20Screws.JPG | Tekman Civata | 116 | 0.0904 | 10.4864
M5 x 16mm Screws |  | 5 x 16mm |  | https://files.readme.io/hnXMDG6lQc2V7g08yTKu_M5%20x%2010mm%20Screws.JPG | Tekman Civata | 23 | 0.0887 | 2.0401
M5 x 20mm Screws |  | 5 x 20mm |  | https://files.readme.io/hnXMDG6lQc2V7g08yTKu_M5%20x%2010mm%20Screws.JPG | Tekman Civata | 3 | 0.1045 | 0.3135
M5 x 25mm Screws |  | 5 x 25mm |  | https://files.readme.io/hnXMDG6lQc2V7g08yTKu_M5%20x%2010mm%20Screws.JPG | Tekman Civata | 9 | 0.1165 | 1.0485
M5 x 30mm Screws |  | 5 x 30mm |  | https://files.readme.io/hnXMDG6lQc2V7g08yTKu_M5%20x%2010mm%20Screws.JPG | Tekman Civata | 22 | 0.1464 | 3.2208
M5 Washers | Washer | M5 | These washers are used throughout FarmBot in combination with M5 screws and M5 locknuts. They allow nuts to be tightened on plastic components and plates while preventing damage and distributing load. | https://files.readme.io/8BX1g8hLQPeVfgTcPLIo_M5%20washers.JPG | Tekman Civata | 48 | 0.0091 | 0.4368
M5 x 6mm Spacers | Spacer | 5 x 6mm | These spacers are used to offset V-wheels from plates so that they may engage extrusions. | https://files.readme.io/RMcHdg8nRBeuIKS4c5uc_quarter_inch_aluminum_spacer__25068.1365305898.1280.1280.jpg |  | 13 | - | -
M5 x 20mm Spacers |  | 5 x 20mm |  | https://files.readme.io/RMcHdg8nRBeuIKS4c5uc_quarter_inch_aluminum_spacer__25068.1365305898.1280.1280.jpg |  | 2 | - | -
M5 x 6mm Eccentric Spacers |  | 5 x 6mm | When rotated, eccentric spacers accurately position V-wheels on a plate such that they can firmly engage V-slot aluminum extrusions. They are only used on wheels on one side of an extrusion. Adjustments are made by using a 10mm wrench on the spacer itself. | https://files.readme.io/liWY3eR4yXDAQL6EHMAG_111_zoom_1411241121.jpg |  | 9 | - | -
M5 Locknuts | Nut | M5 | These nuts resist loosening because their nylon insert grips the screw that they are attached to. They are used in combination with M5 screws throughout FarmBot. | https://files.readme.io/o7xYAKKXQwaKWXMFQIEl_M5%20Locknuts.JPG | Tekman Civata | 60 | 0.0435 | 2.61
M5 Tee Nuts | Cırcırlı somun | M5 | Combined with M5 screws, these drop-in style tee nuts allow components such as plates and 3D printed parts to be attached quickly and securely anywhere on a V-slot aluminum extrusion. | https://files.readme.io/Da4Vwg2PRTab7zlVtPps_IMG_0439.JPG | Doğuş kalıp | 118 | - | -
Wood Screws | Wood Screws | 1 inch | These are used to attach the track end plates and track joining plates to supporting infrastructure such as a raised. | https://files.readme.io/sacf9Ex7S8ayqFZ5MMlx_b70838c3-9d85-4078-9004-5d0110371e1d_1000.jpg | Tekman Civata | 20 | 0.0685 | 1.37
Drivetrain (Bak)
V-Wheels | Polycarbonate Wheel | Clear Polycarbonate, Outer Diameter: 23.9mm, Inner Diameter: 16mm, Width: 10.23mm, Compression Strength: 86 Mpa | These polycarbonate V-wheels are precision machined to allow FarmBot to move in the X, Y, and Z directions smoothly and precisely. Each wheel requires two bearings and one precision shim to operate correctly. | https://files.readme.io/YrnpDfwSbWrRk8el9Dsg_IMG_0285.JPG | http://www.aliexpress.com/item/Solid-V-Xtreme-Wheel-Kits-30-kits-per-pack-free-shipping-DHL/32664711000.html | 1 | 188.25 | 188.25
Bearings | SS-625-2RS | Outer Diameter: 16mm, Inner Diameter: 5mm, Width: 5mm, Rubber Sealed | These stainless steel bearings resist corrosion and have rubber seals to keep debris out. Two of them are used in every V-wheel, and one is used to support the driveshaft in the driveshaft bearing plate. | https://files.readme.io/jGbHX3usRlCLUTGRvRdV_IMG_0293%20(1).JPG
Precision Shims | Precision Shim | Outer Diameter: 10mm, Inner Diameter: 5mm, Width: 1mm | These small washers are placed in between the two bearings in every V-wheel. They keep the bearings from squishing into each other and binding when the wheel is tightened onto a plate. | https://files.readme.io/9iZacmnqQdqFVqASQGBg_Capture.JPG
Bearings | SS-625-2RS | Outer Diameter: 16mm, Inner Diameter: 5mm, Width: 5mm, Rubber Sealed | These stainless steel bearings resist corrosion and have rubber seals to keep debris out. Two of them are used in every V-wheel, and one is used to support the driveshaft in the driveshaft bearing plate. | https://files.readme.io/jGbHX3usRlCLUTGRvRdV_IMG_0293%20(1).JPG | http://www.aliexpress.com/item/double-Rubber-sealing-cover-deep-groove-ball-bearing-625-2RS-5-16-5-mm-625-RS/32351041379.html | 6 | 0.6 | 3.6
Driveshaft | Driveshaft | 17-4 PH Stainless Steel, Diameter: 5mm, Length: 2m, Yield Strength: 118,000 psi | The driveshaft is used to transfer power from the gantry motor such that both gantry pulleys are synchronized and can move the gantry along the tracks without binding. | http://www.mcmaster.com/#3180t35/=13ibsvd |  | 1 | - | -
M5 Lock Collar | Lock Collar | Type 303 Stainless Steel, Inner Diameter: 5mm, Outer Diameter: 13mm, Thickness/Width: 6mm, Setscrew: M3x3mm | The M5 lock collar is used in combination with a GT2 pulley to "capture" and hold in place the driveshaft bearing inside the driveshaft bearing plate. | https://files.readme.io/q8wcZgWVQKnksnUuCWcA_Capture.JPG |  | 1 | - | -
GT2 Timing Belt | Belt (4.5m) | Neoprene with Fiberglass Cords, Width: 5mm, Pitch: 2mm, Length: 4.5m |  | https://files.readme.io/9TX8IaEZRETTK3bqXsYw_GT2-Belt.jpg | http://www.robotus.net/GT2-Kayis,PR-1226.html | 2 | 16.52 | 33.04
GT2 Timing Belt | Belt (2m) | Neoprene with Fiberglass Cords, Width: 5mm, Pitch: 2mm, Length: 2m |  | https://files.readme.io/9TX8IaEZRETTK3bqXsYw_GT2-Belt.jpg | http://www.robotus.net/GT2-Kayis,PR-1226.html | 1 | 16.52 | 16.52
20 Tooth GT2 Pulleys | Pulley | Aluminum, Number of Teeth: 20, Inner Diameter: 5mm, Outer Diameter: 15mm, Height: 14mm, Setscrews: 2 x 1.5mm, Max Belt Width: 7mm, Pitch: 2mm | These pulleys are attached directly to NEMA 17 stepper motor shafts or onto the driveshaft. They transfer power from the motor to the belt such that FarmBot can move in the X and Y directions. | https://files.readme.io/8doQ798HTrWrTDxr7JJ4_DSC02013__78099.1372088407.1280.1280.JPG | http://www.robotus.net/3D-Kayis-Kasnak-20-Dis,PR-1232.html | 3 | 20.06 | 60.18
5mm to 5mm Flex Coupling | Coupling | Aluminum, Inner Diameter: 5mm, Outer Diameter: 18mm,Length: 25mm | This aluminum coupling connects the gantry stepper motor to the driveshaft. It is secured with two setscrews on each shaft. | https://files.readme.io/hU8hEi9CTWuOz1y4n1wI_1175-01.jpg | http://www.robotus.net/5mm-5mm-Kaplin,PR-1228.html | 1 | 16.52 | 16.52
5mm to 8mm Flex Coupling |  | Aluminum, Inner Diameter: 5mm and 8mm, Outer Diameter: 18mm,Length: 25mm | This aluminum coupling connects the Z-axis stepper motor to the leadscrew to allow FarmBot to move in the Z direction. | https://files.readme.io/ZNUcnH6Q9egzwZantjZz_1176-02.jpg | http://www.robotus.net/5mm-8mm-Kaplin,PR-1225.html | 1 | 16.52 | 16.52
8mm ACME Leadscrew | Leadscrew | Stainless Steel, Diameter: 8mm, Threads: Tr8*8-2p (4 starts), Pitch: 2mm, Lead: 8mm, Length: 600mm | This stainless steel leadscrew allows FarmBot to move in the Z direction. | https://files.readme.io/x2hv7tB6RFaVhJ9kxfnp_DSC03575__26013.1394590131.1280.1280.JPG | http://www.robotus.net/3D-Printer-Vidali-Mil-300mm-x-8mm,PR-1236.html | 2 | 61.761 | 123.522
Leadscrew Block | Leadscrew Block | Delrin, Threads: Tr8*8-2p (4 starts), Pitch 2mm, Lead: 8mm, Mounting holes: M5 - 20mm apart, Length: 34mm, Width: 20mm, Thickness: 12mm | This delrin block attaches to the cross-slide plate so that the leadscrew can move through it, allowing FarmBot to move in the Z direction. | https://files.readme.io/3K7FnPe5RUqSMy3uLFZ4_DSC03591__35062.1394590651.1280.1280.JPG |  | 2 | 3D Printer | -
Electronics and Wiring
Electronics Housing | Electronics Housing | Polycarbonate, Waterproof, Clear Cover, Screw mounted, Height: 23cm, Width: 13cm, Depth: 8cm | This waterproof housing protects FarmBot's electronics from rain and debris. It has a clear front cover and keeps water out with a rubber gasket. | https://files.readme.io/sevhV0JOTiitpq5yspYa_Capture.JPG | http://www.altinkaya.com.tr/Yeni-Urunler/EC-1722.html | 1 | 29.64 | 29.64
Power Supply | Power Supply | 12 volt, 30 amp DC |  | https://files.readme.io/MMXq2GmTQHSCf5AZbBiP_Power_supply_12V_30A_11__66927.1365351190.1280.1280.jpg | http://www.gittigidiyor.com/arama/?k=12+volt+30+amper+g%C3%BC%C3%A7+kayna%C4%9F%C4%B1 | 1 | 65 | 65
5V Power Adapter | Step-Down (Buck) Converter | Input Voltage: 6-23V, Output Voltage: 5V, Output Current: 3A continuous, 5A peak |  | https://files.readme.io/IBB4Lf7vQPex3YL88N3u_1385-04.jpg | http://www.direnc.net/Step-Down-Voltage-Regulator-D15V35F5S3-pololu-2110,PR-25726.html | 1 | 51.64 | 51.64
Arduino Mega and USB cable | Arduino Mega and USB cable |  | This is the microcontroller that powers FarmBot. It receives G-code commands from the Raspberry Pi and then sends signals to move motors, read sensors, activate peripherals, and more. |  | https://www.direnc.net/arduino-mega-2560-r3-usb-kablo-dahil | 1 | 47.9 | 47.9
RAMPS shield | RAMPS shield |  |  | https://files.readme.io/2kQxXBTQPaCiq7sRtbXP_4_21_16.jpg | http://www.direnc.net/Reprap-Ramps-14-3d-Printer-Kontrol-Karti,PR-26301.html | 1 | 34.7 | 34.7
Stepper Drivers | Stepper Drivers |  |  | https://files.readme.io/dkbAZuW2QESz5V8dqzfF_0J5806.1200.jpg | http://www.direnc.net/DRV8824-Step-Motor-Surucu-Devresi-drv8824-stepper-motor-driver-pololu-2131,PR-26424.html | 4 | 16.66 | 66.64
Moisture Sensor | Moisture Sensor |  |  | https://skfb.ly/PFKs | https://www.direnc.net/toprak-nem-sensoru-higromete | 1 | 10 | 10
Cable Carrier | Cable Carrier | 15 x 40 x 1000mm, Bending Radius: 28mm | These hollow plastic chains are used throughout FarmBot to manage cables and tubing. | https://files.readme.io/sgT3k4tBSbiIJRsCDpve_Drag-Chain-30331-03.jpg |  | 4 | Katalogdan bak | -
Universal Tool Mount Cable | Cable | Number of wires: 12, 20 awg, length: 3m, 6amps |  | http://images1.mcmaster.com/mvB/contents/gfx/large/8082k29p2-d01b-digitall.png?ver=1434361832 | http://www.mcmaster.com/#8082k14 | 1 | - | -
Solenoid Valve | Solenoid Valve | 1/2" Nominal NPS, 12V, Normally closed |  | https://files.readme.io/4fBesLYvSvCljTojbBBO_997-04.jpg | http://www.robotistan.com/selenoid-su-valf-12v-solenoid-valve-12 | 1 | 21.37 | 21.37
Vacuum Pump | Vacuum Pump | 12V DC |  | https://files.readme.io/chxiChUSKn7QoCyJXCzg_61IVsCaLcGL._SL1315_.jpg | http://www.robotistan.com/sparkfun-vakum-pompasi-vacuum-pump-12v | 1 | 59.47 | 59.47
Peripheral Cable | Cable | 8m, number of wire: 2, rated voltage: 12V, 18 awg |  | http://images1.mcmaster.com/mvB/contents/gfx/large/9697t2p1-d01bl.png?ver=1373878646 | Koçtaş | 2 | 15 | 30
Jumper Wire | Jumper Wire | 18 gauge |  |  | http://www.direnc.net/40PIN-JUMPER-RIBBON-KABLO,PR-23317.html | 2 | 12.46 | 24.92
USB Borescope Camera | Camera | USB |  |  | http://www.gittigidiyor.com/arama/?k=y%C4%B1lan+kamera | 1 | 35 | 35
 | LEDs | 10 pcs x 36 leds |  |  | https://www.aliexpress.com/item/10pcs-0-5M-27Red-9Blue-12V-LED10w-grow-light-bars-light-strip-Hydroponic-Plant-flowers-vegatables/32251271379.html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 | 1 | 91.29 | 91.29
Tubing
Liquid/Gas Tubing | Tube | 4m, clear | The camera is not a typical FarmBot tool in the sense that it does not mount onto the universal tool mount and it is not stored in the tool bay. Instead, it remains fixed in place on the z-axis next to the UTM and can be used at any time, even when other tools are mounted. The camera itself is a low cost waterproof USB borescope. It is connected directly to the raspberry pi and can take photos for weed detection, time lapse photography of your plants growing, and video for live streaming what is happening at the UTM. | http://images1.mcmaster.com/mvB/contents/gfx/large/5233kp9l.png?ver=1321345659 | http://www.hirdavatmarketim.com/Maxtor-Poliuretan-Pnomatik-Hortum-65x10-mm,PR-4897.html | 3 | 5 | 15
Barbs | Barbs |  |  |  | Koçtaş | 3 | 2 | 6
Barbed Adapter | Barbed Adapter |  |  | https://www.google.com.tr/search?q=Barbed+Adapter&safe=off&client=firefox-b-ab&tbm=isch |  | 1 | 2 | 2
Hose Clamp | Hose Clamp |  |  |  |  | 1 | 2 | 2
Garden Hose Adapter | Garden Hose Adapter |  |  |  |  | 1 | 2 | 2
Garden Hose | Garden Hose | As long as needed to reac to nearest water supply |  |  |  | 1 | 15 | 15
O-rings | O-rings |  |  |  |  | 3 | 2 | 6
Inline Pressure Regulator | Inline Pressure Regulator |  |  |  |  | 1 | 20 | 20
Grommets | Grommets |  |  |  |  | 4 | 0.5 | 2
Miscellaneous
Ring Magnets | Ring Magnets | Neodymium, 15 x 5 x 5mm |  | https://files.readme.io/Pm6D80sTysMkCG96oB3w_magnet15x5x5mmring.jpg | http://urun.gittigidiyor.com/yapi-market-tamirat/6-adet-15x5x5-halka-neodyum-miknatis-232039734 | 12 | 3.85 | 46.2
Zip Ties | Zip Ties |  |  |  | Koçtaş | 1 | 5 | 5
Compression Springs | Compression Springs | Free Length: 11mm, Compressed Length: 4.09mm, Outer Diameter: 4.4mm, Inner Diameter: 3.6mm, Wire Diameter: 0.4mm, Spring Rate: 0.62 Newtons/mm, Load Capacity: 4.36 Newtons |  | https://files.readme.io/ASP8NkFCS9CzLGK1bMS4_81bzWHpkXvL._SL1500_.jpg | Sanayi | 12 | - | -
 | Aluminum - Foam | 11.5m | Case walls for isolation and reflection | http://www.balkotrade.com/cam-yunu-klimapan-levhasi-2-5cm-50kg-m3-folyolu.html | Balkotrade | 1 | 66 | 66
Raised Bed
Wood Walls | Wood Walls | Thickness: 5cm, Height: 30 cm, Length: 1.5 m |  | https://files.readme.io/qgEL3yMZS2YzlpRmILV4_IMG_20141203_131420.jpg | Koçtaş | 2
Wood Walls | Wood Walls | Thickness: 5cm, Height: 30 cm, Length: 1m |  | https://files.readme.io/qgEL3yMZS2YzlpRmILV4_IMG_20141203_131420.jpg | Koçtaş | 2
Wood Support | Wood Support | 10x10cm, Length: 50 cm |  | https://files.readme.io/qgEL3yMZS2YzlpRmILV4_IMG_20141203_131420.jpg | Koçtaş | 4
Wood Screw | Wood Screw | 10cm |  |  | Koçtaş | 20
 |  |  |  |  |  |  | Total (TRY) | 1395.588989
 |  |  |  |  |  |  | Total (Dolar) | 389.8293265
 |  |  |  |  |  |  |  | TR | Dolar
Extrusions |  |  |  |  |  |  |  | 158.370569 | 44.23758911
Fasteners and Hardware (Tekman Civata temsili) |  |  |  |  |  |  |  | 24.29642 | 6.786709497
Drivetrain (Bak) |  |  |  |  |  |  |  | 458.152 | 127.975419
Electronics and Wiring |  |  |  |  |  |  |  | 567.57 | 158.5391061
Tubing |  |  |  |  |  |  |  | 70 | 19.55307263
Miscellaneous |  |  |  |  |  |  |  | 117.2 | 32.73743017
Raised Bed |  |  |  |  |  |  |  | 10 | 2.793296089
TOTAL |  |  |  |  |  |  |  | 1405.588989 | 392.6226226
