umurcg/roboticFarm/Models/NEMA 17 Stepper Motor Assembly.IGS

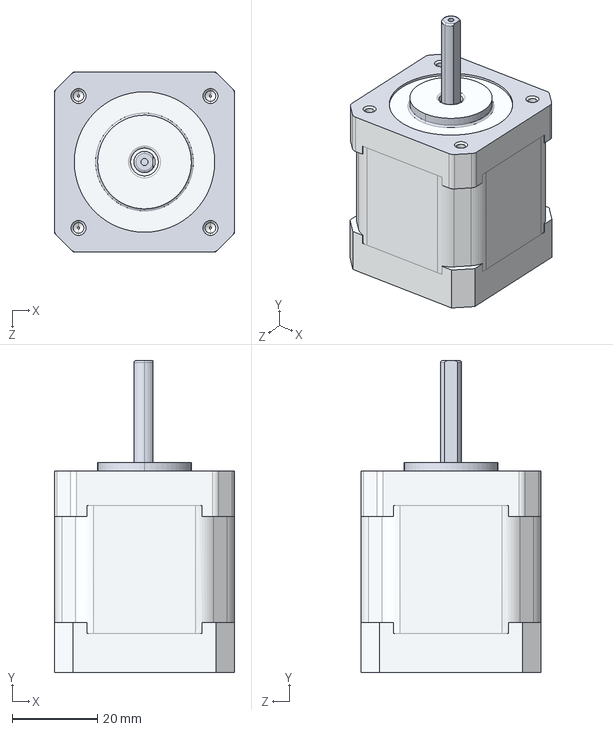
[picture p243: CAD file, 2016-12-13]
Models/NEMA 17 Stepper Motor Assembly.IGS
42.3 x 73.3 x 42.3 mm
