umurcg/roboticFarm/Models2/LED Tube/led-strip-on-aliuminium-pad-17-5w-m-smd5050-1.snapshot.2/Solidworkssmd5050Strip/smd5050Strip/5cmLedStrip.SLDASM

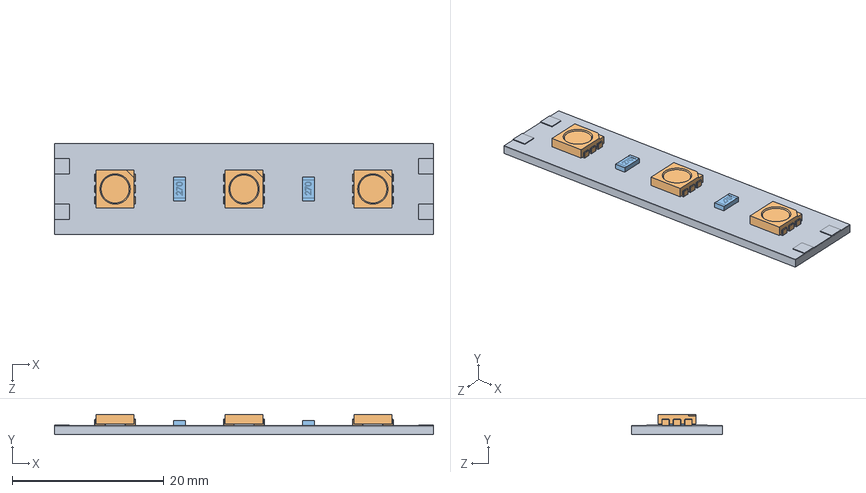
[picture p244: CAD file, 2017-01-07]
Models2/LED Tube/led-strip-on-aliuminium-pad-17-5w-m-smd5050-1.snapshot.2/Solidworkssmd5050Strip/smd5050Strip/5cmLedStrip.SLDASM
50.0 x 2.70 x 12.0 mm
stripPad
led5050 x 3
Resistor1206 x 2
