umurcg/roboticFarm/Models2/LED Tube/led-strip-on-aliuminium-pad-17-5w-m-smd5050-1.snapshot.2/Solidworkssmd5050Strip/smd5050Strip/screenshot1.SLDASM

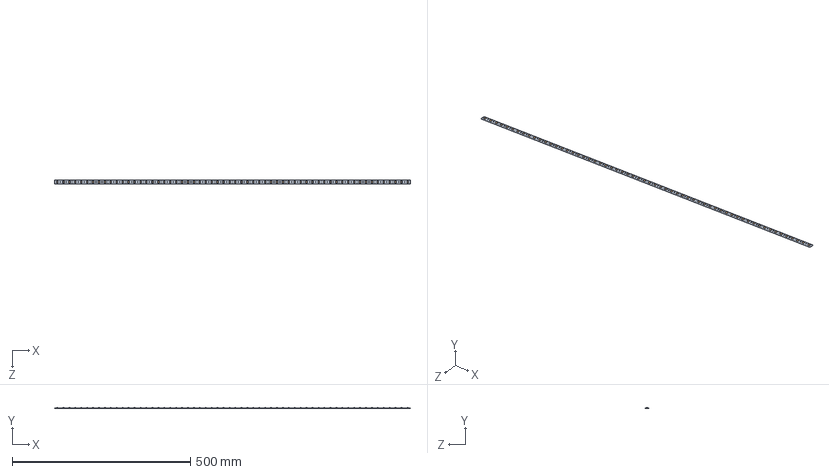
[picture p245: CAD file, 2017-01-07]
Models2/LED Tube/led-strip-on-aliuminium-pad-17-5w-m-smd5050-1.snapshot.2/Solidworkssmd5050Strip/smd5050Strip/screenshot1.SLDASM
1000.0 x 2.70 x 12.0 mm
stripPad x 20
led5050 x 60
Resistor1206 x 40
