umurcg/roboticFarm/Models2/LED Tube/lampara 54 leds.SLDASM

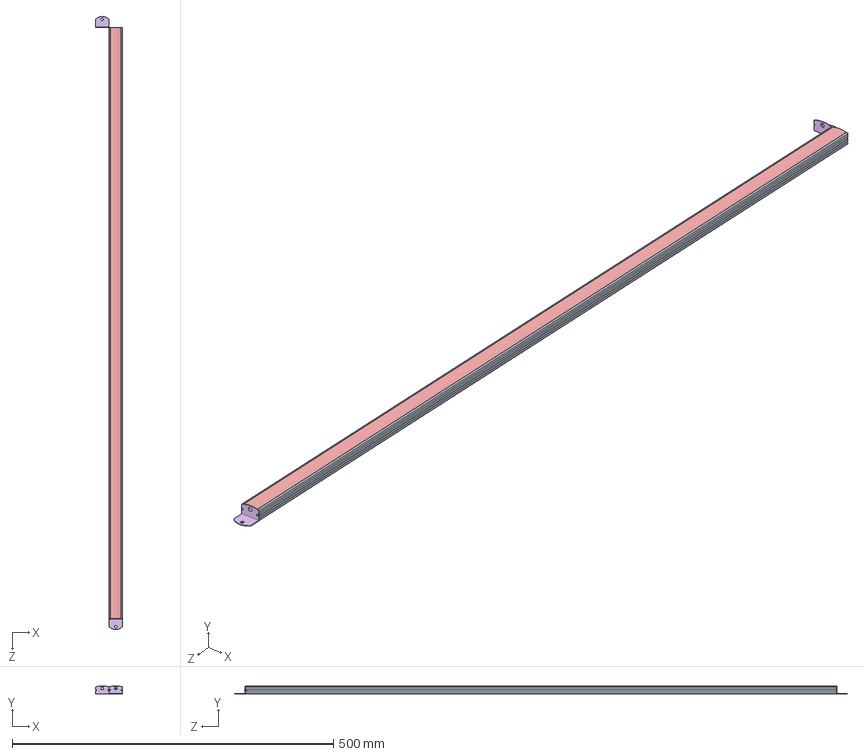
[picture p246: CAD file, 2017-01-07]
Models2/LED Tube/lampara 54 leds.SLDASM
41.5 x 13.2 x 954.5 mm
disipador
stripPad x 18
led5050 x 54
Resistor1206 x 36
tapa
tapabase x 2
flat head miniature screw_ai x 2
