umurcg/roboticFarm/Models2/LED Tube/led-strip-on-aliuminium-pad-17-5w-m-smd5050-1.snapshot.2/Solidworkssmd5050Strip/smd5050Strip/LED5050/led5050.STEP

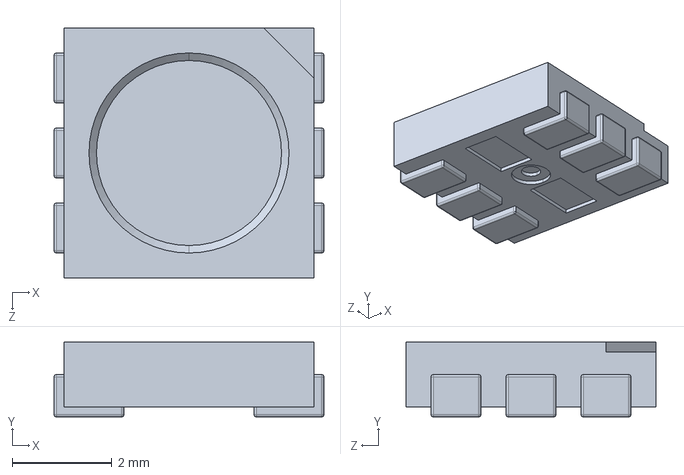
[picture p247: CAD file, 2017-01-07]
Models2/LED Tube/led-strip-on-aliuminium-pad-17-5w-m-smd5050-1.snapshot.2/Solidworkssmd5050Strip/smd5050Strip/LED5050/led5050.STEP
5.40 x 1.50 x 5.00 mm
