umurcg/roboticFarm/Models2/LED Tube/led-strip-on-aliuminium-pad-17-5w-m-smd5050-1.snapshot.2/Solidworkssmd5050Strip/smd5050Strip/Resistor1206/Resistor1206.STEP

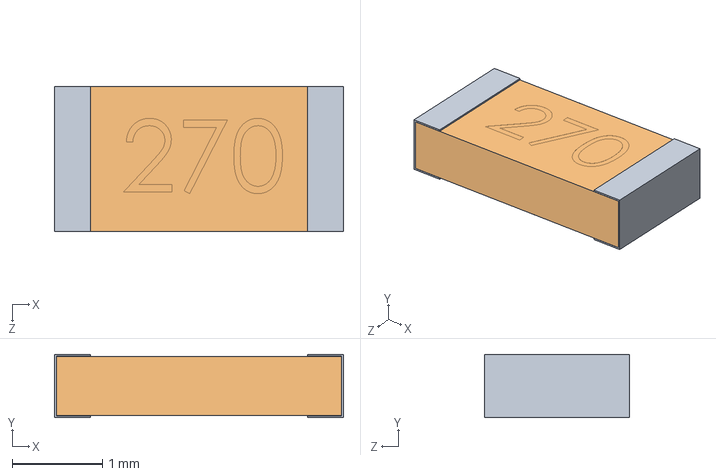
[picture p248: CAD file, 2017-01-07]
Models2/LED Tube/led-strip-on-aliuminium-pad-17-5w-m-smd5050-1.snapshot.2/Solidworkssmd5050Strip/smd5050Strip/Resistor1206/Resistor1206.STEP
3.20 x 0.7 x 1.60 mm
