umurcg/roboticFarm/Models2/LED Tube/tapabase.SLDPRT

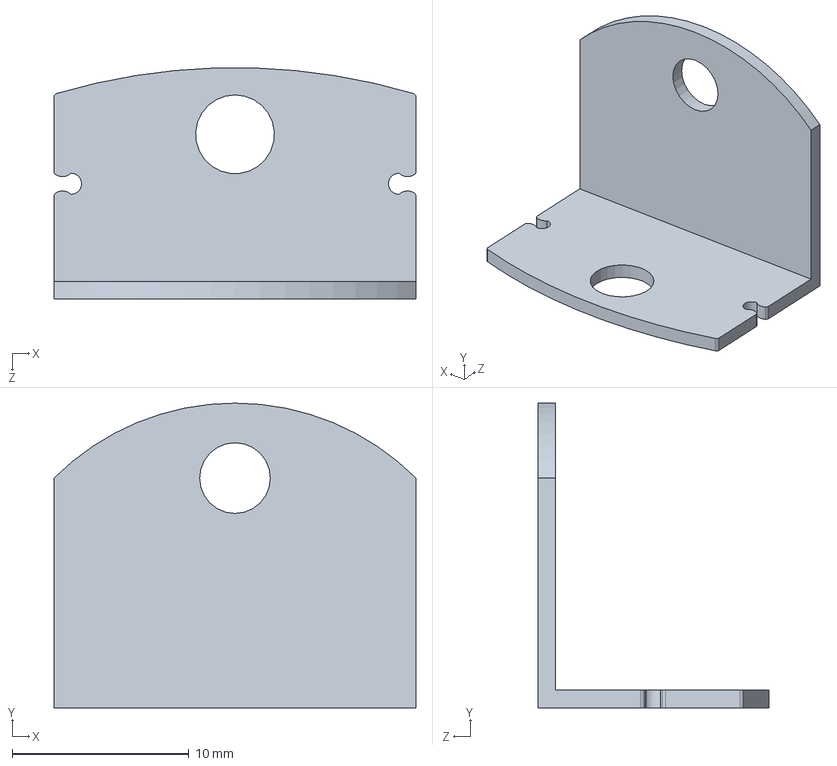
[picture p249: CAD file, 2017-01-07]
Models2/LED Tube/tapabase.SLDPRT
20.5 x 17.2 x 13.1 mm
