umurcg/roboticFarm/Models2/LED Tube/disipador.SLDPRT

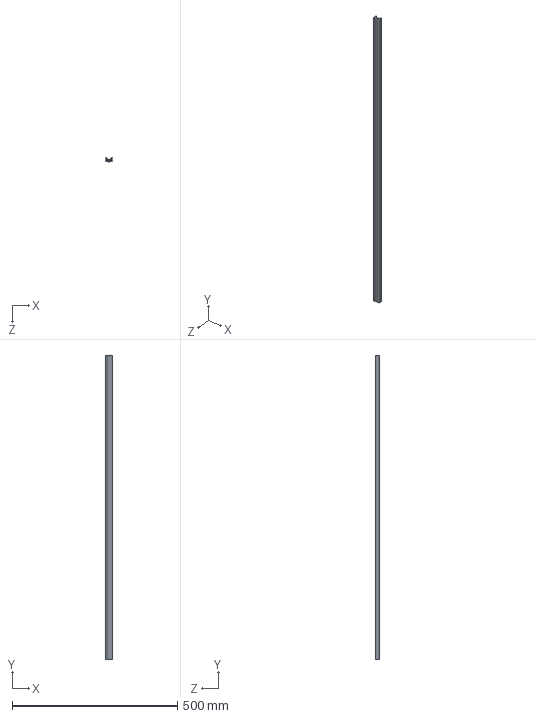
[picture p250: CAD file, 2017-01-07]
Models2/LED Tube/disipador.SLDPRT
20.5 x 920.0 x 12.2 mm
