umurcg/roboticFarm/Models2/LED Tube/tapa.SLDPRT

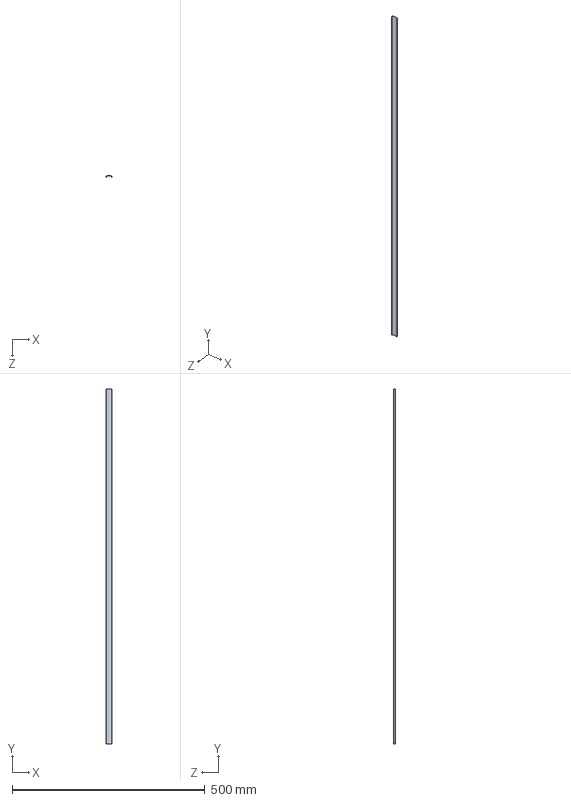
[picture p251: CAD file, 2017-01-07]
Models2/LED Tube/tapa.SLDPRT
16.7 x 920.0 x 4.54 mm
