umurcg/roboticFarm/Models2/LED Tube/led-strip-on-aliuminium-pad-17-5w-m-smd5050-1.snapshot.2/Solidworkssmd5050Strip/smd5050Strip/stripPad.SLDPRT

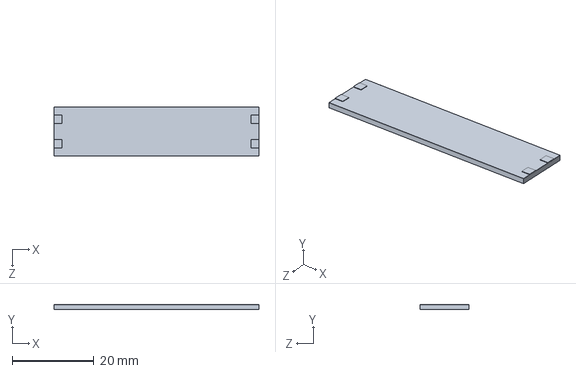
[picture p252: CAD file, 2017-01-07]
Models2/LED Tube/led-strip-on-aliuminium-pad-17-5w-m-smd5050-1.snapshot.2/Solidworkssmd5050Strip/smd5050Strip/stripPad.SLDPRT
50.0 x 1.30 x 12.0 mm
