umurcg/roboticFarm/Models2/ventoinha_80mm.SLDPRT

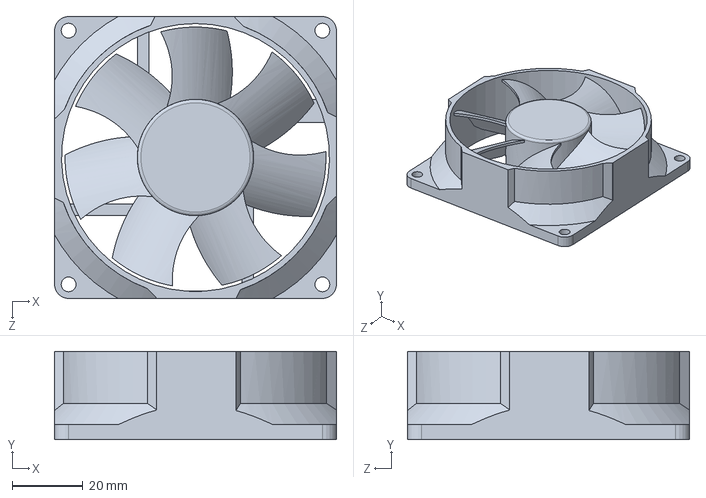
[picture p253: CAD file, 2017-01-07]
Models2/ventoinha_80mm.SLDPRT
80.0 x 25.0 x 80.0 mm
