umurcg/roboticFarm/(list of files, cad)

Other CAD files:
Models2/LED Structure Assembly.dwg
Models2/UTM_Assembly.dwg
Models2/Gantry/L_Fixer_Drawing.dwg
Models2/LED Tube/led-strip-on-aliuminium-pad-17-5w-m-smd5050-1.snapshot.2/1mLedStrip.STEP
Models2/Tools.dwg
modelsali/Models2/FarmBot2.dwg
Models2/Gantry PlateDrawing.dwg
modelsali/Models2/GenesisForward.dwg
Models2/LED Tube/led-strip-on-aliuminium-pad-17-5w-m-smd5050-1.snapshot.2/Solidworkssmd5050Strip/smd5050Strip/1mLedStrip.STEP
modelsali/Models2/FarmBot.dwg
Models2/FarmBot2.dwg
Models/Assemble.iam
Models/Base.ipt
Models/BedTrack.ipt
Models/BedTrack_MIR.ipt
Models/ElectronicCase.ipt
Models/ElevatorTrack.ipt
Models/ElevatorTrack_MIR.ipt
Models/GantryRod.ipt
Models/HeaderTrack.ipt
Models/HeaderWheelSupport.ipt
Models/LeadScrewTrackConnection.ipt
Models/LedSystem.ipt
Models/Motor.ipt
Models/MotorFixer.ipt
Models/MotorFixerDown.ipt
Models/MotorFixerDown_MIR.ipt
Models/MotorFixer_MIR.ipt
Models/Motor_MIR.ipt
Models/Nut.ipt
Models/Nut_MIR.ipt
Models/OldVersions/20.1122 45X45UL 2GG.0006.ipt
Models/OldVersions/Assemble.0029.iam
Models/OldVersions/Base.0012.ipt
Models/OldVersions/BedTrack.0033.ipt
Models/OldVersions/ElectronicCase.0001.ipt
Models/OldVersions/ElevatorTrack.0010.ipt
Models/OldVersions/GantryDeneme.0001.ipt
Models/OldVersions/GantryRod.0004.ipt
Models/OldVersions/HeaderTrack.0003.ipt
Models/OldVersions/HeaderWheelSupport.0006.ipt
Models/OldVersions/HeaderWheelSupport.0007.ipt
Models/OldVersions/LedSystem.0001.ipt
Models/OldVersions/Motor.0002.ipt
Models/OldVersions/MotorFixer.0003.ipt
Models/OldVersions/MotorFixerDown.0003.ipt
Models/OldVersions/Nut.0002.ipt
Models/OldVersions/Profile3.0007.ipt
Models/OldVersions/RayHeaderPlater.0003.ipt
Models/OldVersions/RayHeaderPlater.0005.ipt
Models/OldVersions/ScrewDriver.0008.ipt
Models/OldVersions/Track.0006.ipt
Models/OldVersions/TrackPowerJoint.0007.ipt
Models/OldVersions/TrackSupport.0006.ipt
Models/OldVersions/UpperTrack.0008.ipt
Models/OldVersions/UpperTrack.0009.ipt
Models/OldVersions/Wheel.0003.ipt
Models/OldVersions/Wheels.0004.ipt
Models/OldVersions/WheelsSupport.0006.ipt
Models/OldVersions/WheelsSupport.0008.ipt
Models/OldVersions/profile.0001.ipt
Models/OldVersions/profile2.0005.ipt
Models/OldVersions/wheelRoadGantry.0001.ipt
Models/RayHeaderPlater.ipt
Models/ScrewDriver.ipt
Models/ScrewDriver_MIR.ipt
Models/TrackPowerJoint.ipt
Models/TrackPowerJoint_MIR.ipt
Models/TrackPowerJoint_MIR1.ipt
Models/TrackSupport.ipt
Models/TrackSupport_MIR.ipt
Models/UTM Cover.ipt
Models/Wheel.ipt
Models/Wheel_MIR.ipt
Models/WheelsSupport.ipt
Models/WheelsSupport_MIR.ipt
Models/profile.ipt
Models/profile2.ipt
Models/wheelRoad.ipt
Models/wheelRoadGantry.ipt
Models2/30x60Sigma.ipt
Models2/30x60SigmaLong.ipt
Models2/30x60Sigma_MIR.ipt
Models2/30x60Sigma_MIR1.ipt
Models2/BedAssembly/BedAseembly.iam
Models2/BedAssembly/OldVersions/BedAseembly.0015.iam
Models2/BeltMain.ipt
Models2/Case/Case.iam
Models2/Case/InsulatorWallNorrow.ipt
Models2/Case/InsulatorWallWide.ipt
Models2/Case/NarrowWall.iam
Models2/Case/OldVersions/Case.0012.iam
Models2/Case/ReflectorWallNorrow.ipt
Models2/Case/ReflectorWallWide.ipt
Models2/Case/WideWall.iam
Models2/FarmBot.iam
Models2/GanrtyPlatev2.ipt
Models2/Gantry/Elevator Track30x30.ipt
Models2/Gantry/Gantry.iam
Models2/Gantry/GantryDown.iam
Models2/Gantry/GantryDown_MIR.iam
Models2/Gantry/GantryDown_MIR1.iam
Models2/Gantry/GantryPlate_v3.ipt
Models2/Gantry/GantryPlate_v3_MIR.ipt
Models2/Gantry/GantryPlate_v3_MIR1.ipt
Models2/Gantry/GantryUp.iam
Models2/Gantry/L_Fixer.ipt
Models2/Gantry/L_Fixer_MIR.ipt
Models2/Gantry/L_Fixer_MIR1.ipt
Models2/Gantry/L_Fixer_MIR2.ipt
Models2/Gantry/M5 Screw with Tee Nut_MIR1.iam
Models2/Gantry/M5 Screw with Tee Nut_MIR2.iam
Models2/Gantry/M5 Screw.ipt
Models2/Gantry/M5 Screw_MIR1.ipt
Models2/Gantry/M5 Screw_MIR2.ipt
Models2/Gantry/M5ScrewWithoutNot.ipt
Models2/Gantry/M5ScrewWithoutNot_MIR.ipt
Models2/Gantry/Motor.ipt
Models2/Gantry/MotorFixer.ipt
Models2/Gantry/Motor_MIR1.ipt
Models2/Gantry/Motor_MIR2.ipt
Models2/Gantry/OldVersions/Driveshaft.0002.ipt
Models2/Gantry/OldVersions/Gantry Plate.0001.ipt
Models2/Gantry/OldVersions/Gantry Plate_MIR.0001.ipt
Models2/Gantry/OldVersions/GantryDown.0045.iam
Models2/Gantry/OldVersions/GantryPlate_v3.0014.ipt
Models2/Gantry/OldVersions/GantryUp.0035.iam
Models2/Gantry/OldVersions/L_Fixer.0017.ipt
Models2/Gantry/OldVersions/L_Fixer2.0006.ipt
Models2/Gantry/OldVersions/L_Fixer2_MIR.0001.ipt
Models2/Gantry/OldVersions/L_Fixer_Drawing.0002.dwg
Models2/Gantry/OldVersions/L_Fixer_MIR.0005.ipt
Models2/Gantry/OldVersions/M5 Screw.0006.ipt
Models2/Gantry/OldVersions/M5ScrewWithoutNot.0006.ipt
Models2/Gantry/OldVersions/Motor.0009.ipt
Models2/Gantry/OldVersions/MotorFixer.0013.ipt
Models2/Gantry/OldVersions/ScrewDriver.0011.ipt
Models2/Gantry/OldVersions/Tee Nut With headless screw_MIR.0002.iam
Models2/Gantry/OldVersions/Tee Nut.0006.ipt
Models2/Gantry/OldVersions/Tee Nut.0008.ipt
Models2/Gantry/OldVersions/Tee Nut_MIR1.0002.ipt
Models2/Gantry/ScrewDriver.ipt
Models2/Gantry/ScrewDriver_MIR1.ipt
Models2/Gantry/ScrewDriver_MIR2.ipt
Models2/Gantry/Tee Nut With headless screw_MIR.iam
Models2/Gantry/Tee Nut.ipt
Models2/Gantry/Tee Nut_MIR1.ipt
Models2/Gantry/Tee Nut_MIR2.ipt
Models2/Gantry/Tee Nut_MIR3.ipt
Models2/Head/HeadPlate.ipt
Models2/Head/HeadSlider.iam
Models2/Head/OldVersions/HeadPlate.0010.ipt
Models2/Head/OldVersions/HeadSlider.0010.iam
Models2/HeadTools/OldVersions/SeederAssembly.0003.iam
Models2/HeadTools/OldVersions/Watering Tool Assembly.0001.iam
Models2/HeadTools/Seeder/15mm x 5mm x 5mm Ring Magnet.ipt
Models2/HeadTools/Seeder/M5 Locknut.ipt
Models2/HeadTools/Seeder/M5 Screw_16mm.ipt
Models2/HeadTools/Seeder/M5 Screw_25mm.ipt
Models2/HeadTools/Seeder/MagnetAssembly.iam
Models2/HeadTools/Seeder/Seeder.ipt
Models2/HeadTools/Seeder/SeederAssembly.iam
Models2/HeadTools/Water/15mm x 5mm x 5mm Ring Magnet.ipt
Models2/HeadTools/Water/M3 Locknut.ipt
Models2/HeadTools/Water/M3 Screw.ipt
Models2/HeadTools/Water/M5 Locknut.ipt
Models2/HeadTools/Water/M5 Screw.ipt
Models2/HeadTools/Water/OldVersions/Watering Tool Assembly.0002.iam
Models2/HeadTools/Water/Watering Tool Assembly.iam
Models2/HeadTools/Water/Watering Tool.ipt
Models2/HeadTools/Water/Zip Tie.ipt
Models2/HeadTools/Weeder/15mm x 5mm x 5mm Ring Magnet.ipt
Models2/HeadTools/Weeder/M3 Locknut.ipt
Models2/HeadTools/Weeder/M3 Screw.ipt
Models2/HeadTools/Weeder/M5 Locknut.ipt
Models2/HeadTools/Weeder/M5 Screw.ipt
Models2/HeadTools/Weeder/Weed Suppressor Base.ipt
Models2/HeadTools/Weeder/Weeder Assembly.iam
Models2/HeadTools/Weeder/Zip Tie.ipt
Models2/LBent_PScrew.ipt
Models2/LBent_PScrew_MIR.ipt
Models2/LED Structure/LED Structure Assembly.iam
Models2/LED Structure/Led Plater.ipt
Models2/LED Structure/OldVersions/LED Structure Assembly.0007.iam
Models2/LED Structure/OldVersions/Led Plater.0010.ipt
Models2/LED Structure/OldVersions/Support.0005.ipt
Models2/LED Structure/OldVersions/Support_MIR.0001.ipt
Models2/LED Structure/OldVersions/Support_MIR1.0001.ipt
Models2/LED Structure/OldVersions/Support_MIR_MIR.0001.ipt
Models2/LED Structure/Support.ipt
Models2/LED Structure/Support_MIR.ipt
Models2/LED Structure/Support_MIR1.ipt
Models2/LED Structure/Support_MIR_MIR.ipt
Models2/LED Tube/5cmLedStrip.iam
Models2/LED Tube/OldVersions/5cmLedStrip.0001.iam
Models2/LED Tube/OldVersions/lampara 54 leds.0002.iam
Models2/LED Tube/Resistor1206.ipt
Models2/LED Tube/disipador.ipt
Models2/LED Tube/lampara 54 leds.iam
Models2/LED Tube/led-strip-on-aliuminium-pad-17-5w-m-smd5050-1.snapshot.2/Solidworkssmd5050Strip/smd5050Strip/1mLedStrip.SLDASM
Models2/LED Tube/led-strip-on-aliuminium-pad-17-5w-m-smd5050-1.snapshot.2/Solidworkssmd5050Strip/smd5050Strip/LED5050/led5050.SLDPRT
Models2/LED Tube/led-strip-on-aliuminium-pad-17-5w-m-smd5050-1.snapshot.2/Solidworkssmd5050Strip/smd5050Strip/LED5050/led5050.STL
Models2/LED Tube/led-strip-on-aliuminium-pad-17-5w-m-smd5050-1.snapshot.2/Solidworkssmd5050Strip/smd5050Strip/Resistor1206/Resistor1206.SLDPRT
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
