umurcg/roboticFarm/(commit log)

2016-11-27 Basit model çizimleri
    [Assemble.0004.iam, Assemble.iam, Base.0002.ipt, Base.ipt, ElectronicCase.ipt, GantryDeneme.0001.ipt, GantryRod.0004.ipt, GantryRod.ipt]
2016-12-13 design update
    [20.1122 45X45UL 2GG.0006.ipt, 30x30Sigma.ipt, 30x60Sigma.0001.ipt, 30x60Sigma.ipt, 5mm x 5mm Flexible Coupling.ipt, Assemble.0004.iam, Assemble.0029.iam, Assemble.iam]
2016-12-25 model update
    [Base.ipt]
2016-12-25 minor updates on models
    [Assembly1Deneme.0001.iam, Assembly1Deneme.iam, Base.0019.ipt, Base.0020.ipt, Base.ipt, BedAseembly.0009.iam, BedAseembly.0011.iam, BedAseembly.iam]
2017-01-03 Head assembly
    [1.5mm Square O-Ring 7.5mm ID (modelled as 8mm ID).ipt, 12 wire cable.ipt, 15mm x 5mm x 5mm Ring Magnet.ipt, Elevator Track.0002.ipt, Elevator Track.0003.ipt, Elevator Track.ipt, Elevator Track_MIR.0001.ipt, Elevator Track_MIR.0002.ipt]
